chobyeongjun/AR_Walker/STM_Board/Assets/README.md

# Assets

이미지·다이어그램·스크린샷 저장 폴더.

## 권장

- **Excalidraw** 플러그인 사용 시: `.excalidraw.md` 파일로 저장
- PCB 스크린샷, 블록 다이어그램, 핀맵 이미지 등
- 파일명은 kebab-case 권장 (`block-diagram.png`)

## 연결

- [[Exosuit Board MOC]]
- [[Block Diagram]]
