chobyeongjun/AR_Walker/STM_Board/90 Templates/Schematic Block.md

---
aliases: []
tags: [type/block, phase/A]
type: schematic_block
phase: A
status: pending
kicad_sheet: ""
---

# {{title}}

## 목적

<!-- 이 블록이 하는 일 -->

## 핵심 부품

- [[]]

## 핀맵 (MCU 측)

| 신호 | MCU 핀 | 주변기기 | 비고 |
|---|---|---|---|

## 외부 회로

<!-- 디커플링, 풀업, 안티앨리어싱, 보호회로 등 -->

## 관련 개념

- [[]]

## 데이터시트 / 레퍼런스

- [ ]

## 작업 체크리스트

- [ ] reference schematic 수집
- [ ] KiCad 심볼 확인
- [ ] 풋프린트 확인
- [ ] sheet 그리기
- [ ] ERC 통과
- [ ] peer review

## 핀 충돌 검사

<!-- CubeMX .ioc 와 대조 -->
