chobyeongjun/AR_Walker/STM_Board/10 Project/Project MOC.md

---
aliases: [Project]
tags: [moc, project]
---

# Project MOC

Exosuit STM32 Board 프로젝트 전체 네비게이션.

## 계획·상태

- [[Goals & Requirements]] — 무엇을 만드는가, 비기능 요구사항
- [[Block Diagram]] — 시스템 블록 구성도
- [[Phase Plan]] — P0~P8 단계별 일정
- [[Size Budget]] — 보드 면적 예산
- [[Modular Strategy]] — Phase A / B 분리 전략

## 추적·투명성

- [[Decisions Log]] — 시간순 결정 기록
- [[Open Questions]] — 보류·미결 항목
- **[[Citations & Sources]]** ⭐ — 각 스펙·주장의 출처 추적 (투명성)

## Legacy (2026-04-12~14 이전 세션)

- [[_legacy/BOARD_PLAN]]
- [[_legacy/BOARD_DESIGN]]
- [[_legacy/BOARD_DESIGN_REVIEWED]]
- [[_legacy/EXOSUIT_PROTECTION]]
- [[_legacy/HANDOFF]]
- [[_legacy/RECONCILIATION]] — legacy 와 내 노트 diff

## 관련 MOC

- [[Components MOC]]
- [[Concepts MOC]]
- [[Schematic Blocks MOC]]
- [[BOM MOC]]
- [[Reference Index]]
