chobyeongjun/AR_Walker/STM_Board/90 Templates/Concept.md

---
aliases: []
tags: [type/concept, domain/]
type: concept
---

# {{title}}

> 이 템플릿은 `~/research-vault/templates/` 에도 복사해두는 것 권장.

## 문제 (Why)

<!-- 이 개념이 왜 필요한가? -->

## 해법 (How)

<!-- 어떻게 해결하는가? -->

## 우리 보드에서의 적용

<!-- 구체적 구현 -->

## 관련 부품

- [[]]

## 관련 결정

- [[]]

## 참고 자료
