chobyeongjun/AR_Walker/STM_Board/90 Templates/Decision.md

---
aliases: []
tags: [type/decision, status/decided]
type: decision
date: 
status: decided
domain: 
---

# Decision: {{title}}

> 이 템플릿은 `~/research-vault/templates/` 에도 복사해두는 것 권장.

## 결정

<!-- 한 줄로 -->

## 맥락

<!-- 언제, 왜 이 결정이 필요했는가 -->

## 고려한 옵션

- A: ...
- B: ...
- C: ...

## 근거

<!-- 왜 이 옵션을 골랐는가 -->

## 영향

- [[]]
- [[]]

## 재고 트리거

<!-- 언제 이 결정을 다시 볼 것인가 -->
