chobyeongjun/AR_Walker/STM_Board/10 Project/_legacy/BOARD_DESIGN_REVIEWED.md

# 보드 설계 검토 결과 — 수정본

> 4개 전문 에이전트 병렬 검토 결과 반영 (전원부 / STM32H743 / 아날로그 / CAN)

---

## CRITICAL 이슈 목록 (설계 전 반드시 수정)

| # | 영역 | 문제 | 결과 | 수정 |
|---|---|---|---|---|
| C1 | 전원 | AP62200WU VIN 최대 24V → 배터리 완충 25.2V 초과 | 동작 범위 이탈, 신뢰성 불가 | **AP63205WU-7** (4.2~32V) 또는 TPS54331으로 교체 |
| C2 | 전원 | SMBJ26A 클램프 전압 42.1V > AP63205 절대최대정격 | TVS가 있어도 IC 보호 안 됨 | 벅 컨버터 교체 후 TVS 재설계 |
| C3 | 전원 | P-MOS 역전압 보호 VGS = -22.9V → 절대최대정격 ±20V 초과 | P-MOS 파손 | GATE-GND 간 **12V 제너(BZT52C12) + R 100kΩ** 추가 |
| C4 | MCU | VCAP_2 핀(Pin 57) 누락 → LQFP100에는 VCAP 핀 2개 | 내부 1.2V LDO 불안정 → MCU 미동작 | VCAP_1(Pin33), VCAP_2(Pin57) 각각 **2.2μF** 독립 배치 |
| C5 | MCU | VREF+ 핀(Pin 21) 미처리 | 내장 ADC 전면 동작 불가 | VREF+ → VDDA 직결 + 100nF + 1μF |
| C6 | 아날로그 | ADS1234 AVDD 최소 4.75V → 현재 3.3V 계획 | ADC 미동작 | AVDD에 **5V 공급** 필수 |
| C7 | 아날로그 | INA333(3.3V 단전원) + 5V 여기 로드셀 → VCM=2.5V, 허용 최대 2.1V | 계측앰프 새추레이션, 측정 불가 | 여기 전압 3.0V 이하로 낮추거나 **INA128/AD8221**로 교체 |

---

## WARNING 이슈 목록 (설계 완료 전 반영)

| # | 영역 | 문제 | 권고 |
|---|---|---|---|
| W1 | 전원 | AMS1117-3.3 SOT-223 탭 미납땜 시 Tj=120°C(한계 125°C) | SOT-223 탭을 GND 동박(≥1cm²)에 납땜, 또는 벅으로 대체 |
| W2 | MCU | VDDA 필터 불충분 (1μF+100nF만) | 3.3V → **600Ω@100MHz 페라이트 비드** → VDDA, VDDA 쪽 10μF+1μF+100nF |
| W3 | MCU | PC13 RTC 도메인 핀 최대 전류 3mA | 직렬 100Ω 추가, 직접 부하 구동 금지, 필요 시 다른 GPIO로 이전 |
| W4 | MCU | 크리스탈 RS 저항 누락 | OSC_IN과 크리스탈 사이 **22Ω** 직렬 저항 추가 |
| W5 | MCU | USB Type-C CC1/CC2 핀 미처리 | CC1, CC2 각각 **5.1kΩ → GND**, D+/D-에 ESD TVS(PRTR5V0U2X) 추가 |
| W6 | MCU | BOOT0 처리 미명시 | **10kΩ 풀다운** + 점퍼/버튼으로 VDD 선택 가능하게 |
| W7 | MCU | NRST 값 미명시 | **100nF** (GND 사이), 저항 불필요 |
| W8 | 아날로그 | AINxN 처리 미명시 (단방향 측정) | AINxN에 VDD/2=1.65V 미드레일 인가, INA333 VREF도 동일 전압 |
| W9 | 아날로그 | 입력 과전압 보호 없음 | 각 입력 핀에 **직렬 10kΩ + BAV99 클램프 다이오드** |
| W10 | 아날로그 | 안티앨리어싱 필터 없음 | AINxP/N 직전 **1kΩ + 150nF** RC 필터 (fc≈1kHz) |
| W11 | CAN | TJA1051 STBY 핀 floating 위험 | **STBY → GND 직결** 또는 10kΩ 풀다운 |
| W12 | CAN | 차동 임피던스 재계산 필요 | 0.2mm 폭은 JLCPCB 스택업에서 약 88Ω → **0.17~0.18mm로 조정** |
| W13 | CAN | 토폴로지 미확정 | **데이지체인 확정**, 스타 구성 1Mbps에서 반사 위험 |
| W14 | CAN | GND 플레인 물리 분리 계획 문제 | **단일 연속 GND 플레인 유지** + 구역 파티셔닝 (Henry Ott 방식) |
| W15 | CAN | EMI → 로드셀 간섭 대책 없음 | CAN 양옆 GND 가드 트레이스, CMC(ACM2012-900) 검토 |

---

## 수정된 BOM

### 전원부 (변경)

| 부품 | 파트넘버 (수정 전) | 파트넘버 (수정 후) | 이유 |
|---|---|---|---|
| 벅 컨버터 | AP62200WU | **AP63205WU-7** | VIN 최대 32V, 5A |
| 역전압 P-MOS | 미정 | **DMP2305U-7** (SOT-23) | VGS ±20V, VDSS -30V |
| 역전압 제너 | 없음 | **BZT52C12** (SOD-123) | 12V, GATE-GND 클램핑 |
| TVS | SMBJ26A | **TVS 재설계** (AP63205 VIN 32V 기준) | 입력 내성 상향 후 재선정 |

### 아날로그부 (변경)

| 부품 | 파트넘버 (수정 전) | 파트넘버 (수정 후) | 이유 |
|---|---|---|---|
| 계측앰프 | INA333AIDGK | **INA128UA** (SOIC-8) 또는 **AD8221ARZ** | 5V 여기 로드셀 CMR 문제 해결 |
| 로드셀 여기 | 5V | **3.0V** (LDO 추가) | INA333 유지 시 CMR 허용 |

> **판단**: INA128(VDD 최대 ±18V = 36V, CMR 범위 -4V ~ Vcc-1.25V)은 5V 단전원에서 5V 여기 로드셀 사용 가능. AD8221도 동일. **INA128UA로 교체 권장.**

### 추가 부품

| 부품 | 파트넘버 | 용도 |
|---|---|---|
| 제너 다이오드 | BZT52C12 (SOD-123) | P-MOS GATE 보호 |
| 페라이트 비드 | BLM18PG601SN1D (0603) | VDDA 디지털-아날로그 분리 |
| 클램프 다이오드 | BAV99 (SOT-23) | 로드셀 입력 과전압 보호 |
| USB ESD | PRTR5V0U2X (SOT-363) | USB D+/D- 보호 |
| CAN CMC | ACM2012-900-2P-T002 | CAN 커먼모드 노이즈 (선택) |
| CC 저항 | 5.1kΩ 0402 ×2 | USB Type-C CC1/CC2 |
| BOOT 저항 | 10kΩ 0402 | BOOT0 풀다운 |
| NRST 캐패시터 | 100nF 0402 | NRST 필터 |
| Crystal RS | 22Ω 0402 | HSE 고조파 방지 |

---

## 수정된 회로 설계 핵심 사항

### 전원부 수정 회로

```
배터리(+) ─── [R1: 100kΩ] ─── GATE ─── [BZT52C12: 12V] ─── GND
                               │
배터리(+) ─── DRAIN(DMP2305U) ─── SOURCE ─── AP63205WU-7 VIN
                                              (4.2V~32V OK)
                                                 │
                                              5V 출력
                                                 │
                                    ┌────────────┤
                                    │            │
                               [AMS1117-3.3]  [ADP3338-3.3]
                               (디지털 3.3V)  (아날로그 3.3V)
                                    │
                               SOT-223 탭 → GND 동박 ≥1cm²
```

### STM32H743 전원 필터 수정

```
3.3V ─── [BLM18PG601: 600Ω@100MHz] ─── VDDA (Pin 11)
                                          ├── 10μF (X5R)
                                          ├── 1μF
                                          └── 100nF

3.3V ─────────────── VREF+ (Pin 21)
                      ├── 1μF
                      └── 100nF

GND ─── VCAP_1 (Pin 33) ─── 2.2μF (X5R, 6.3V)
GND ─── VCAP_2 (Pin 57) ─── 2.2μF (X5R, 6.3V)   ← 기존 누락!
```

### 로드셀 신호 체인 수정

```
로드셀 (5V 여기)
    │
  [R: 10kΩ] ─── IN+ ─── INA128UA ─── OUT ─── [R:1kΩ] ─── AINxP
  [BAV99]        │      (VDD=5V)               [C:150nF]
                IN- ─── VREF=1.65V             [C to GND]
                        │                          │
                [BAV99] │               AINxN ─── 1.65V (VDD/2)
                        │
                GAIN 설정: RG = 100kΩ/(G-1)
                G = 1650mV / (로드셀_full_scale_mV)
                예) 5V × 2mV/V = 10mV → G = 165 → RG = 613Ω
```

> **주의**: INA128은 5V 단전원에서 VDD/2 = 2.5V 공통모드 입력 지원. 허용 VCM = -4V ~ Vcc-1.25V = 3.75V → 2.5V OK.

### ADS1234 전원 수정

```
시스템 5V ─── AVDD (Pin) ─── 10μF + 100nF (기존 AGND 레일에서 공급)
3.3V      ─── DVDD (Pin) ─── 100nF
AVDD > DVDD 순서 또는 동시 인가 (역순 래치업 주의)
```

### CAN STBY 핀 수정

```
TJA1051 STBY ─── GND (직결)  ← 항상 Normal mode
             또는
TJA1051 STBY ─── [10kΩ] ─── GND (풀다운 + GPIO 제어 가능)
```

---

## PCB 레이아웃 수정 사항

### GND 플레인 처리 (수정)

```
[잘못된 기존 계획]
Layer 2: AGND 플레인 / DGND 플레인 물리적 분리(슬릿)

[수정된 방법 - Henry Ott]
Layer 2: 단일 연속 GND 플레인 (자르지 않음)
보드 구역 파티셔닝:
  ┌──────────────┬──────────────┐
  │   아날로그   │   디지털     │
  │ 로드셀/ADC   │ MCU/CAN/전원 │
  │ (좌측 하단) │ (우측 전체)  │
  └──────────────┴──────────────┘
규칙: 디지털 트레이스가 아날로그 구역 위(Layer 1) 통과 금지
      ADS1234 AGND/DGND 핀만 단일 스타포인트 연결
```

### 크리스탈 레이아웃 추가 규칙

```
OSC_IN ─── [22Ω] ─── 크리스탈 핀1
OSC_OUT ──────────── 크리스탈 핀2
크리스탈 아래 Layer 2 GND 비아 없음 (가드링만)
부하 캐패시터 GND 비아: 크리스탈 바로 옆 2mm 이내
```

---

## 확인된 OK 항목

- TJA1051T/3J 3.3V 로직 호환: VCCIO=3.3V 인가 시 OK
- CAN-FD Classic CAN 하위 호환: FDCAN_FRAME_CLASSIC 설정으로 OK
- FDCAN1/2 핀 할당 (PD0/1, PB12/13): STM32H743 AF 매핑 OK
- INA219 배터리 모니터 버스 전압: 25.2V < 26V 측정 한계 OK
- ADP3338 아날로그 LDO: 노이즈 40μVrms, 열 여유 OK
- ADS1234 데이터 레이트: PDIV=00으로 채널당 1kHz OK
- REF3325 출력 전류: 10mA >> ADC 요구 전류 OK
- SWD 핀 (PA13/PA14): 표준 SWD OK
- STM32H743 SMPS: H743에는 없음 → 외부 SMPS 부품 불필요 (단순화)
- JST-GH 4핀 CAN 커넥터: 전류/전압 정격 OK

---

## 수정 후 단계별 진행 체크리스트

### 스키매틱 작성 전 확인
- [ ] AP63205WU-7 데이터시트 입수 (LCSC C2688410)
- [ ] INA128UA 데이터시트 입수
- [ ] ADS1234 AVDD=5V, DVDD=3.3V 전원 분리 회로 설계
- [ ] P-MOS 역전압 보호 제너 포함 회로 확정

### 스키매틱 ERC 전 확인
- [ ] VCAP_1 (Pin 33) → 2.2μF 연결
- [ ] VCAP_2 (Pin 57) → 2.2μF 연결 (별도)
- [ ] VREF+ (Pin 21) → VDDA + 100nF + 1μF
- [ ] VDDA → 페라이트 비드 → 3.3V
- [ ] BOOT0 → 10kΩ 풀다운
- [ ] NRST → 100nF → GND
- [ ] OSC_IN → 22Ω → 크리스탈
- [ ] USB CC1, CC2 → 5.1kΩ → GND 각각
- [ ] TJA1051 STBY → GND
- [ ] TJA1051 VCCIO → 3.3V

### PCB 레이아웃 전 확인
- [ ] GND 플레인 단일 유지 (분리 금지)
- [ ] 아날로그/디지털 구역 배치 계획 확정
- [ ] AMS1117 SOT-223 탭 GND 동박 ≥1cm²
- [ ] CAN 차동쌍 폭 0.17~0.18mm
- [ ] JLCPCB 임피던스 제어 옵션 사용

---

## skiro 기록 대상 (설계 중 반드시 추적)

각 CRITICAL 수정 완료 시 `skiro_record_solution` 실행
문제 재발 시 `skiro_record_problem` 즉시 기록
하드웨어 테스트 전 `skiro_safety_gate_create` 실행 (CRITICAL 0개 조건)
