chobyeongjun/AR_Walker/STM_Board/10 Project/_legacy/EXOSUIT_PROTECTION.md

# Exosuit 보드 보호 회로 설계 — 최종 확정본

> **배경**: 케이블 드리븐 외골격의 반복적 pull-release → 수십 A 전류 급변 → 보드 반복 파손
> 4개 전문 에이전트 병렬 분석 + 교차검증으로 수치 근거 확정

---

## 왜 보드가 타는가 — 수치 분석

### 메커니즘 1: 재생 에너지 전압 폭주 (가장 위험)

```
케이블 릴리즈 순간:
  케이블 탄성에너지 = F×x/2 = 100N × 5mm / 2 = 0.25J/모터
  4개 동시 릴리즈: E_total = 1J

  배터리 BMS가 역전류 거부할 때 에너지 행선지:
  → 버스 캐패시터 충전

  C_bus = 100μF (보호 없을 때):
  V_peak = √(2×1J / 100μF + 24²) = √(20,000 + 576) = 143V  ← 즉사

  C_bus = 10,000μF (보호 후):
  V_peak = √(2×1J / 10,000μF + 24²) = √(200 + 576) = 27.9V ← 안전
```

### 메커니즘 2: Ground Bounce → CAN 트랜시버 TXD/RXD 파손

```
모터 리턴 전류 급변 + PCB 그라운드 인덕턴스:
  V_bounce = L × dI/dt = 50nH × 50A/μs = 2.5V

TJA1051 TXD/RXD 핀 (VIO 기준):
  절대최대정격: VIO ± 0.3V
  2.5V bounce → 즉시 초과 → 트랜시버 파손

  이것이 CAN 트랜시버가 주기적으로 죽는 원인
```

### 메커니즘 3: L·dI/dt 버스 스파이크

```
케이블 + PCB 배선 인덕턴스 총계 ≈ 700nH ~ 2μH
극단 케이스: V = 2μH × 2A/μs = 4V → 버스 최대 29.2V
→ 재생 에너지보다 작지만 고주파 반복 → 소자 열화 가속
```

---

## 확정 보호 아키텍처

### 블록 다이어그램

```
배터리 24V LiPo (완충 25.2V)
         │
    ┌────┴─────────────────────────────────────────────────┐
    │  [DMP2305U P-MOS + BZT52C12 12V 제너] 역전압 보호    │
    └────────────────────────┬─────────────────────────────┘
                             │
    ┌────────────────────────┴─────────────────────────────┐
    │  [SL08-2R005 NTC × 2 직렬 = 4Ω] 인러시 제한         │
    │  [Omron G5V-1 릴레이 bypass — 정상동작 후 단락]      │
    └────────────────────────┬─────────────────────────────┘
                             │
         24V_MOTOR 버스 ─────┤
                             │
         ┌───────────────────┤───────────────────┐
         │                   │                   │
  [BUS_BULK ×2]    [BUS_TVS P6KE33CA×2]  [제동저항 회로]
  9,400μF/35V       클램프 37.8V          TLV3201(비교기)
  버스 에너지 흡수   최후 클램프           26.5V 임계 → IPB025N10N3
                                         → 3Ω/50W 저항 → GND

    ┌─────────────┬─────────────┬─────────────┬───────────┐
  모터1          모터2          모터3          모터4
[SMAJ28CA]    [SMAJ28CA]    [SMAJ28CA]    [SMAJ28CA]  로컬 TVS
[470μF/35V]   [470μF/35V]   [470μF/35V]   [470μF/35V] 로컬 캐패시터
[BLM31AG]     [BLM31AG]     [BLM31AG]     [BLM31AG]   페라이트비드
[커넥터]       [커넥터]       [커넥터]       [커넥터]

         │
         └─────────────────── 24V_LOGIC 분기 (5A 퓨즈)
                              [10μH + 100μF 필터]
                              [AP63205WU-7 → 5V]
                              [TPS7A4700 LDO → 3.3V]

PGND ──[BLM21PG601SN1 단 1개]── AGND (스타 그라운드)

CAN 신호 경로 (FDCAN1, FDCAN2 동일):

STM32 FDCAN TX/RX
     │
 [33Ω] + [PRTR5V0U2X ESD ±8kV]
     │
 ISO1050DUBR (격리 5000Vrms)
 VCC1 = 3.3V (AGND)
 VCC2 = 5V (PGND, MGJ2D 격리출력 + BZT52C5V6 5.6V 제너)
     │
 [22Ω 댐핑]
     │
 [ACM2012-900 CMC 900Ω@100MHz]
     │
 [SM712-02HTG TVS 500W]
     │
 CAN 커넥터 → AK 모터 (데이지체인, 120Ω 종단)
```

---

## 확정 BOM — 보호 소자 전용

| 위치 | 부품 | 파트넘버 | 수량 | 선택 근거 |
|---|---|---|---|---|
| 버스 벌크 캐패시터 | 4700μF/35V 전해 | Rubycon 35ZLH4700M | 2 | 1J 재생에너지 흡수, V_peak=27.9V |
| 모터 로컬 캐패시터 | 470μF/35V OS-CON | Panasonic SVPD471M35 | 4 | 각 모터 로컬 에너지 흡수 |
| 버스 주 TVS | P6KE33CA 600W | Vishay P6KE33CA | 2병렬 | 37.8V 클램프, AK 내압 40V 대비 여유 |
| 모터 로컬 TVS | SMAJ28CA 400W | Vishay SMAJ28CA | 4 | 모터별 독립 보호, SOD-123 소형 |
| 제동 저항 | 3Ω/50W | Arcol HS50 3R0 J | 1 | 25W 평균 소산, 사이클 20% 듀티 |
| 제동 MOSFET | 100V/130A | Infineon IPB025N10N3 G | 1 | 재생 전류 소산 스위치 |
| 제동 비교기 | 단전원 비교기 | TI TLV3201DCKR | 1 | 26.5V 임계 감지 |
| 제동 임계 저항 상단 | 100kΩ 0.1% | - | 1 | 26.5V 분압 설정 |
| 제동 임계 저항 하단 | 10kΩ 0.1% | - | 1 | 26.5V 분압 설정 |
| 인러시 NTC | 2Ω NTC | Ametherm SL08-2R005 | 2직렬 | 4Ω 합산, 인러시 <6A, τ=40ms |
| 인러시 bypass 릴레이 | 5V DC 릴레이 | Omron G5V-1-DC5 | 1 | 정상동작 후 NTC 단락 |
| 역전압 P-MOS | -30V/4A SOT-23 | Diodes DMP2305U-7 | 1 | 역접속 완전 차단 |
| GATE 클램프 제너 | 12V SOD-123 | BZT52C12 | 1 | VGS ≤ 12V (절대최대 20V 보호) |
| CAN TVS | 500W 통합 | SM712-02HTG | 2 | CAN_H/L 동시, 4× PESD1CAN 에너지 |
| CAN 커먼모드 초크 | 900Ω@100MHz | TDK ACM2012-900-2P-T002 | 2 | EMI 차단, TVS 코어 포화 방지 |
| CAN 격리 트랜시버 | 5000Vrms | TI ISO1050DUBR | 2 | GND bounce 경로 물리 차단 |
| 격리 DC/DC | 5V→5V 2W | Murata MGJ2D05050SC | 2 | VCC2 독립 공급 |
| VCC2 보호 제너 | 5.6V SOD-123 | BZT52C5V6 | 2 | VCC2 최대 6.5V 보호 |
| FDCAN 핀 ESD | ±8kV SOT-363 | Nexperia PRTR5V0U2X | 2 | TX/RX 핀 직접 보호 |
| FDCAN 댐핑 저항 | 33Ω 0402 | - | 4 | 반사 억제, ESD 전류 제한 |
| CAN 댐핑 저항 | 22Ω 0402 | - | 4 | 버스 라인 댐핑 |
| PGND-AGND 비드 | 600Ω@100MHz | Murata BLM21PG601SN1D | 1 | 스타 그라운드 단 1개 연결점 |
| 모터 전원 페라이트 | 600Ω@100MHz 3A | Murata BLM31AG601SN1L | 4 | 모터별 고주파 노이즈 차단 |
| 5V 라인 TVS | 400W SOD-123 | Vishay SMAJ5.0A | 1 | AP63205 출력 보호 |

---

## 교차검증에서 수정된 핵심 사항

| 항목 | 1차 설계 | 교차검증 후 수정 | 근거 |
|---|---|---|---|
| 버스 캐패시터 | 4,400μF | **11,280μF** | 1J 흡수에 C_min=9,615μF 필요 |
| 제동 저항 임계 | 28V | **26.5V** | 배터리 완충 25.2V 대비 마진 확보 |
| TJA1051 VCC 보호 | SMAJ5.0A(클램프 9.2V) | **ISO1050 + BZT52C5V6(5.6V)** | VCC2 절대최대 6.5V < SMAJ5.0A 클램프 |
| 인러시 NTC | 단일 2Ω | **직렬 2개 4Ω + 릴레이** | 반복 동작 시 자기가열 → 저항 감소 방지 |
| CAN 트랜시버 | TJA1051 비격리 | **ISO1050 격리 5000Vrms** | GND bounce 2.5V → TXD/RXD 파손 원인 |

---

## PCB 레이아웃 규칙 (보호 관점)

### 1. 고전류 루프 면적 최소화 (인덕턴스 감소)

```
[잘못된 배치] 배터리 커넥터 → 트레이스 100mm → 캐패시터 → 모터
→ 루프 면적 크면 L 증가 → V_spike 증가

[올바른 배치] 배터리 커넥터 옆 3mm 이내에 벌크 캐패시터 배치
→ BUS_BULK ↔ 배터리 커넥터 사이 트레이스 최단
→ 캐패시터 GND via는 패드 직결, 별도 트레이스 없이
```

### 2. 모터 전원 리턴 경로 전용화

```
모터 커넥터 GND 핀
     ↓ (via 4개 이상)
Layer 2 PGND 플레인
     ↓ (넓은 Pour)
배터리 GND 커넥터
→ 이 경로에 MCU, 센서 GND 비아 없음
```

### 3. 격리 경계선 (ISO1050)

```
PCB Layer 1~4 모두:
  MCU 영역 (AGND) │ 솔더마스크 갭 2mm │ CAN 버스 영역 (PGND)
ISO1050 패키지가 이 경계를 가로지름
ISO1050 아래 Layer 2: AGND와 PGND 사이 갭 (via 없음)
```

### 4. 제동 저항 배치

```
IPB025N10N3 → PCB 모서리 or 외부 방열판 연결
저항 HS50 3Ω → PCB 외부 별도 방열판 (50W 소산)
MOSFET 방열: TO-263 패드 → 2oz 동박 방열 패드 최소 4cm²
```

### 5. CAN 보호 소자 배치 순서

```
커넥터 핀에서 거리:
3mm: SM712-02HTG TVS
8mm: ACM2012-900 CMC
13mm: 22Ω 댐핑 저항
18mm: ISO1050 버스측 핀
→ 격리 장벽 →
23mm: PRTR5V0U2X ESD
28mm: 33Ω MCU 측 저항
35mm: STM32H743 FDCAN 핀
```

---

## 실패 모드 보호 검증

| 실패 모드 | 보호 소자 | V 또는 E | 보호 충분? |
|---|---|---|---|
| 4모터 동시 회생 1J | 11,280μF + 제동저항 26.5V | V_peak=27.9V < 28V | ✅ 충분 |
| 버스 스파이크 (빠른 상승) | P6KE33CA×2 (1,200W) | 37.8V 클램프 | ✅ AK 내압 40V 이내 |
| 모터 로컬 서지 | SMAJ28CA + 470μF | 각 모터 독립 | ✅ 전파 차단 |
| CAN ESD ±8kV | SM712-02HTG + PRTR5V0U2X | ±8kV HBM | ✅ |
| GND bounce → MCU 파손 | ISO1050 5000Vrms 격리 | 물리적 경로 차단 | ✅ 근본 해결 |
| 24V 스파이크 → VCC2 | BZT52C5V6 5.6V 클램프 | 5.6V < VCC2_max 6.5V | ✅ |
| 역전압 접속 | DMP2305U + BZT52C12 | VGS ≤ 12V | ✅ |
| 인러시 전류 | NTC 4Ω 직렬 | 피크 6A, 2.88J/NTC | ✅ < 5J 정격 |
| CAN 커먼모드 노이즈 | ACM2012-900 CMC | -40dB@100MHz | ✅ |

---

## skiro 체크포인트

```
모터 연결 전: skiro_safety_gate_create (CRITICAL 0개 확인)
제동저항 초기 테스트: 먼저 28V 공급 → 비교기 출력 확인 → 저항 연결
ISO1050 통신 확인: 루프백 → 실제 모터 CAN 통신
벌크 캐패시터 충전 확인: NTC 자기가열 후 릴레이 동작 확인
```
