chobyeongjun/AR_Walker/Walker_Main/Python_GUI/Resources/Images/H-Walker_Blue.png

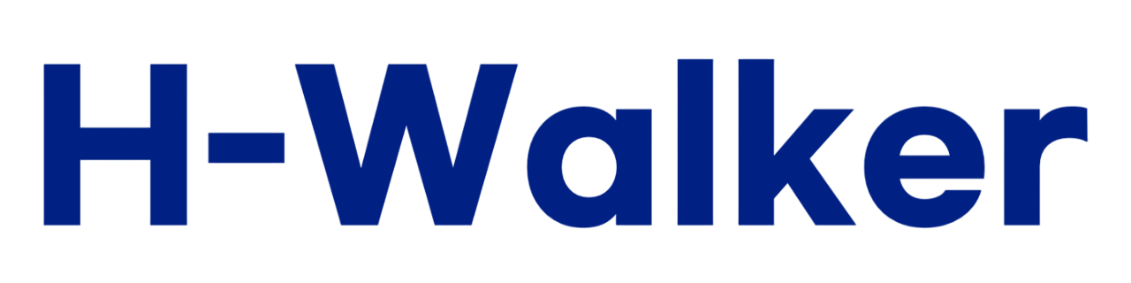
Walker_Main/Python_GUI/Resources/Images/H-Walker_Blue.png
