chobyeongjun/AR_Walker/Walker_Main/Python_GUI/Resources/Images/H-Walker_Sky.png

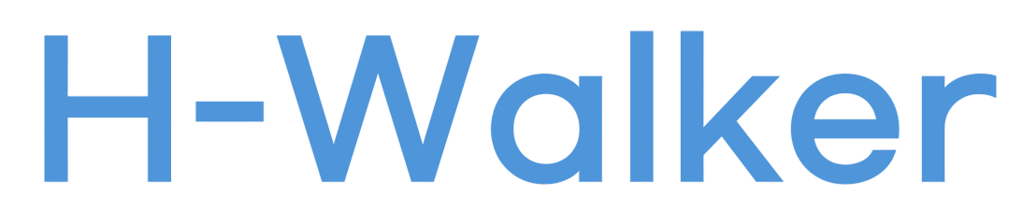
Walker_Main/Python_GUI/Resources/Images/H-Walker_Sky.png
