chobyeongjun/AR_Walker/STM_Board/20 Components/INA228.md

---
aliases: [INA228, 배터리 모니터]
tags: [type/component, domain/power, domain/sensor, phase/A, status/decided]
type: component
part_number: INA228IDGSR
package: VSSOP-10
manufacturer: TI
voltage_range: 0-85V common-mode
interface: I²C
phase: A
status: decided
qty: 2
---

# INA228

## 한 줄 요약

0~85V 전류·전압·전력·**쿨롱 카운터** 통합 모니터 — 배터리 SoC 추정. **2개 사용** (24V × 2 직렬 배터리 개별 측정).

## 사양

- 전압 범위: 0~85V (common-mode) — 24V 단일 / 48V 직렬 둘 다 OK
- ADC: 20-bit
- BUS 정밀도: 1.5 mV
- CURRENT 분해능: shunt 1mΩ + gain → 4µA LSB 가능
- 인터페이스: I²C (400kHz / 2.94 MHz)
- **CHARGE 레지스터** — 내장 쿨롱 카운터 (mAh 적분)

## ⚠️ Legacy: 2개 사용 (직렬 배터리)

Legacy HANDOFF 명시: **INA228 × 2**.

이유: 24V × 2 직렬 = 48V 시스템 시, **각 배터리 팩 개별 전압/전류 측정** 필요.
- 팩 1 불균형 감지
- 팩 간 electrical breakaway 감지
- 개별 SoC 계산 후 합산

I²C 주소 서로 다르게 (ADDR0/ADDR1 핀 결선) 설정.

### 24V 단일 시스템이면?

INA228 × 1 로도 OK. 단 legacy 가 2개 명시했으므로 **2개 풋프린트 배치 → 미사용 시 DNP** 추천.

## 왜 선택했나

- **전 전압 범위 커버** — 12V 든 48V 든 동일 IC
- vs INA226 (36V max) — 48V 불가
- vs 풀 BMS (BQ40Z80) — 과잉
- 내장 쿨롱 카운팅으로 MCU 부담 ↓

## 연결되는 블록

- [[Battery Monitor]]

## 관련 개념

- [[Battery SoC Estimation]]

## 외부 회로

- Shunt 저항 1 mΩ 2W 2512 (Susumu CSS2H) — 입력 +V 라인 직렬
- I²C 풀업 4.7kΩ × 2 ([[MCU Core]] I²C1 버스 공유)
- 3.3V 바이패스 (100nF + 1µF)

## I²C 주소

| 칩 | ADDR0 | ADDR1 | 주소 |
|---|---|---|---|
| INA228 #1 (팩 1) | GND | GND | 0x40 |
| INA228 #2 (팩 2) | VS | GND | 0x41 |

## 데이터시트

- [ ] TI INA228 데이터시트 PDF
