chobyeongjun/AR_Walker/STM_Board/20 Components/BZT52C12.md

---
aliases: [BZT52C12, 12V 제너]
tags: [type/component, domain/power, domain/safety, phase/B, status/decided]
type: component
part_number: BZT52C12
package: SOD-123 (SMD)
manufacturer: various (commodity)
voltage_range: 12V Zener
interface: Zener diode
phase: B
status: decided
---

# BZT52C12

## 한 줄 요약

12V 제너 다이오드 SOD-123 — [[DMP2305U]] P-MOS GATE 클램프. VGS 절대최대 ±20V 이내로 제한.

## 왜 12V

- V_GS(on) 임계: -2V 정도부터 도통 (DMP2305U R_DS 곡선)
- V_GS = -12V 에서 R_DS ~ 100mΩ (양호)
- 절대최대 -20V 에 마진 8V

## 관련

- [[DMP2305U]]
- [[Motor Power]]
