chobyeongjun/AR_Walker/STM_Board/20 Components/SL08-2R005.md

---
aliases: [SL08-2R005, 인러시 NTC]
tags: [type/component, domain/power, phase/B, status/decided]
type: component
part_number: SL08-2R005
package: through-hole
manufacturer: Ametherm
voltage_range: -
interface: thermistor (NTC)
phase: B
status: decided
---

# SL08-2R005

## 한 줄 요약

2Ω NTC 인러시 제한. 2개 직렬 (4Ω) 로 반복 동작 지원.

## 사양

- 저항 (25°C): 2Ω
- 최대 연속 전류: 5A
- 에너지 정격: 5J (단발)
- 패키지: through-hole

## 사용 방식

[[Inrush Current Limiting]] 참조.

2개 직렬로 4Ω → I_inrush = 24V/4Ω = 6A. τ = 45ms.
100ms 후 Omron G5V-1 릴레이 bypass → NTC 발열 없음.

## 관련

- [[Inrush Current Limiting]]
- [[Motor Power]]
