chobyeongjun/AR_Walker/STM_Board/90 Templates/Component.md

---
aliases: []
tags: [type/component, domain/, status/decided]
type: component
part_number: ""
package: ""
manufacturer: ""
voltage_range: ""
interface: ""
phase: A
status: decided
---

# {{title}}

> 이 템플릿은 `~/research-vault/templates/` 에도 복사해두는 것 권장 (vault 공용).

## 한 줄 요약

<!-- 이 부품이 어떤 역할을 하는지 한 문장 -->

## 사양

| 항목 | 값 |
|---|---|
| 제조사 |  |
| 패키지 |  |
| 공급 전압 |  |
| 인터페이스 |  |
| 핀 수 |  |
| 가격대 |  |

## 왜 이 부품을 선택했나

<!-- 관련 Concept 또는 Decision 노트로 근거 연결 -->

## 연결되는 블록

- [[]]

## 관련 개념

- [[]]

## 데이터시트 / 레퍼런스

- [ ] 데이터시트 PDF 저장
- [ ] EVM / dev board schematic 수집

## 핀 / 주의사항
