chobyeongjun/AR_Walker/STM_Board/20 Components/74LVC1G08.md

---
aliases: [74LVC1G08, AND gate]
tags: [type/component, domain/safety, phase/A, status/decided]
type: component
part_number: 74LVC1G08GW
package: SC-70-5 또는 SOT-353
manufacturer: Nexperia
voltage_range: 1.65-5.5V
interface: logic
phase: A
status: decided
---

# 74LVC1G08

## 한 줄 요약

단일 2-입력 AND 게이트 — [[E-stop Dual Safety]] 의 HW 차단 요소.

## 역할

`motor_enable_final = (MCU motor_enable) AND (E-stop NC 접점 OK)`

MCU 가 행(freeze)해도 E-stop 입력이 끊기면 게이트 출력 LOW → 모터 드라이버 enable 신호 차단.

## 사양

- 단일 게이트, 2-입력 AND
- 전파 지연: ~3 ns
- 공급 전압: 3.3V (우리 로직 레벨)
- 패키지: SC-70-5 또는 SOT-353 (1.6 × 1.6mm)

## 외부 회로

- VCC 100nF 바이패스
- 미사용 입력 없음 (2-입력 전부 사용)

## 연결되는 블록

- [[Safety UI]]

## 관련 개념

- [[E-stop Dual Safety]]

## 데이터시트

- [ ] Nexperia 74LVC1G08 데이터시트 PDF
