chobyeongjun/AR_Walker/STM_Board/20 Components/AS5048A.md

---
aliases: [AS5048A, encoder]
tags: [type/component, domain/sensor, phase/A, status/decided]
type: component
part_number: AS5048A
package: TSSOP-14
manufacturer: ams
voltage_range: 3.3V or 5V
interface: SPI or PWM or ABI
phase: A
status: decided
---

# AS5048A

## 한 줄 요약

14-bit 자기식 절대 인코더 — 풀리에 다이아메트럴 자석 배치, 케이블 위치·모터 축 각도 측정.

## 사양

- 해상도: **14-bit** (16384 pos/rev)
- 인터페이스: SPI (1MHz) + PWM + ABI
- 전원: 3.3V 또는 5V
- 최대 회전 속도: 14.5k RPM
- 온도: -40~125°C

## 왜 선택했나

- 풀리 회전 절대각 직접 측정 (reboot 후 homing 불필요)
- 접촉식 아닌 자기식 → 수명 길고 신뢰성 ↑
- [[Elmo 드라이버]] 내부 인코더 피드백을 CANopen 으로 받는 방법도 있지만, 외부 엔코더로 이중 센싱 안전

## 외부 회로

- SPI 풀업 (MISO 10kΩ)
- 바이패스 캡 (VDD 100nF)
- 자석 위치: IC 위 1-2mm 거리, 다이아메트럴 자화

## 연결되는 블록

- [[Encoder]] — 인코더 sheet
- [[MCU Core]] SPI3 + 2× CS

## 데이터시트

- [ ] ams AS5048A 데이터시트 PDF
- [ ] Adafruit AS5048A breakout schematic (참고)
