chobyeongjun/AR_Walker/STM_Board/20 Components/REF5025.md

---
aliases: [REF5025, 정밀 레퍼런스]
tags: [type/component, domain/sensor, phase/A, status/decided]
type: component
part_number: REF5025AIDR
package: SO-8
manufacturer: TI
voltage_range: input 2.7-18V, output 2.5V
interface: analog
phase: A
status: decided
---

# REF5025

## 한 줄 요약

2.5V 정밀 전압 레퍼런스 — [[ADS131M04]] REFIN 용, force 측정 정확도 결정.

## 사양

- 출력: 2.500 V ± 0.05% (A 그레이드)
- 온도 드리프트: **3 ppm/°C**
- 노이즈: 7.5 µVpp (0.1~10Hz)
- 출력 전류: ±10 mA

## 왜 필요한가

ADS131M04 의 FSR (full-scale range) 은 ±VREF. VREF 가 불안정하면 모든 force 측정이 비례로 오차.
내장 레퍼런스 (2.442V 내부) 보다 외부 REF5025 가 10× 안정적.

## 외부 회로

```
3.3V_A ─[100nF + 10µF]─ VIN
                       │
                       └── OUT (2.5V) ─[4.7µF + 100nF]─► ADS131M04 REFIN
                           NR(5) ─[1µF]─ GND          (노이즈 필터)
```

## 관련

- [[ADS131M04]]
- [[Loadcell Amplifier Design]]
- [[Loadcell Amp]]

## 데이터시트

- [ ] TI REF5025 데이터시트 PDF
