chobyeongjun/AR_Walker/STM_Board/20 Components/TPD4S012.md

---
aliases: [TPD4S012, USB ESD]
tags: [type/component, domain/comm, domain/safety, phase/A, status/decided]
type: component
part_number: TPD4S012DBVR
package: SOT-23-6
manufacturer: TI
voltage_range: 3.3V~5V
interface: USB D+/D-
phase: A
status: decided
---

# TPD4S012

## 한 줄 요약

4채널 ±15 kV ESD 다이오드 어레이 — USB-C D+/D- + CC 라인 정전기 보호.

## 사양

- ESD: IEC 61000-4-2 ±15 kV (접촉·공중 방전)
- 커패시턴스: 0.8 pF (USB HS 480 Mbps 에 적합)
- 4 채널 (D+, D-, CC1, CC2)
- SOT-23-6 (2.9×1.6 mm)

## 왜 선택했나

- USB HS (480Mbps) 에 낮은 cap 필수 (≤1pF)
- 4 채널 — D+/D- + CC1/CC2 모두 보호
- vs USBLC6 (2채널) — CC 라인까지 커버 못함

## 외부 회로

- USB 커넥터 바로 뒤 배치 (근접성 중요)
- VBUS 는 별도 보호 (TVS)

## 연결되는 블록

- [[USB Debug]]

## 데이터시트

- [ ] TI TPD4S012 데이터시트 PDF
