chobyeongjun/AR_Walker/Walker_Main/Hardware/Bowden_Transmission/Bill_of_Materials_AK60V1_1.xlsx

Item | Link | Count | Price ($) | Total ($)
Machined Parts
Sprocket (x2) AND Cable - Chain Interface (x4) | https://www.hubs.com/ | 1 | 432.58 | 432.58
Prefabricated Parts
Chain Master Link | https://www.mcmaster.com/catalog/130/1314/6027K71 | 4 | 1.78 | 7.12
04B Chain (1ft) | https://www.mcmaster.com/catalog/130/1314/6027K71 | 1 | 9.02 | 9.02
TMotors AK60V1.1 KV80 | https://www.cubemars.com/goods-1142-AK60-6+V11+KV80.html | 2 | 298.9 | 597.8
6mm x 13mm x 5mm Flanged Ball Bearing (package of 10) | https://www.amazon.com/HiPicco-Flanged-Bearing-Shielded-Bearings/dp/B0CRLFPJPG?th=1 | 1 | 7.99 | 7.99
Steel Cable (500ft) | https://www.amazon.com/gp/product/B00TYSBDPU/ref=ppx_yo_dt_b_search_asin_title?ie=UTF8&psc=1 | 1 | 99 | 99
Cable Crimps (pack of 50) | https://www.mcmaster.com/catalog/130/1731/3914T11 | 1 | 9.04 | 9.04
Fasteners
M3X8 Buttonhead Screw (pack of 100) | https://www.mcmaster.com/products/screws/system-of-measurement~metric/rounded-head-screws~/metric-18-8-stainless-steel-button-head-hex-drive-screws/thread-siz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 | 1 | 8 | 8
M3X6 Buttonhead Screw (pack of 100) | https://www.mcmaster.com/products/screws/system-of-measurement~metric/rounded-head-screws~/metric-18-8-stainless-steel-button-head-hex-drive-screws/finish~pas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 | 1 | 5.83 | 5.83
M3X30 Flathead Screw (pack of 50) | https://www.mcmaster.com/products/screws/flat-head-screws~/metric-alloy-steel-hex-drive-flat-head-screws/thread-size~m3/length~30-mm/ | 1 | 6.93 | 6.93
M5X20 Buttonhead Screw (pack of 50) | https://www.mcmaster.com/products/screws/rounded-head-screws~/metric-18-8-stainless-steel-button-head-hex-drive-screws/thread-size~m5/length~20-mm/finish~pass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 | 1 | 12.38 | 12.38
M5 Lock Nuts (pack of 50) | https://www.mcmaster.com/products/nuts/locknuts~/nylon-insert-locknuts~~/system-of-measurement~metric/thread-size~m5/material~stainless-steel-2/ | 1 | 7.26 | 7.26
M3 Washer (pack of 10) | https://www.mcmaster.com/products/washers/washers-2~/metric-general-purpose-washers/screw-size~m3/material~aluminum-1/ | 1 | 10.4 | 10.4
M4X8 Buttonhead Screw (pack of 100) | https://www.mcmaster.com/products/screws/rounded-head-screws~/metric-18-8-stainless-steel-button-head-hex-drive-screws/thread-size~m4/length~8-mm/finish~passi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 | 1 | 10.09 | 10.09
Total: |  |  |  | 1223.44
Bowden Tube | https://www.amazon.com/Jagwire-Sport-Housing-Slick-Lube-Titanium/dp/B085NBZMJS?s=sporting-goods | 1 | 61.97
