chobyeongjun/AR_Walker/Walker_Main/Hardware/Hip_Device/Bill_of_Materials.xlsx

Part | Quantity | Price (9/18/23) | Total Price | Notes | Link
Motor
AK60v1.1 Motor | 2 | 298.90 | 597.80 |  | https://store.tmotor.com/goods-1201-AK60-6+V11.html
External Manufactured Parts
Abduciton/Adduction Block - Hip | 2 | 103.50 | 207.00 | Refer to documentation for ordering information and files | https://uptivemfg.com/
Abduciton/Adduction Block - Leg | 2 | 103.50 | 207.00 | Refer to documentation for ordering information and files | https://uptivemfg.com/
Printed Circuit Board | 1 | 59.92 | 0.00 | Refer to documentation for ordering information and necessary files; Initial order was for 5 boards so price is estimated as 1/5th that price | https://jlcpcb.com/
Carbon Fiber Parts - Internally Manufactured
Carbon Fiber - Upright | 1 | 173.99 | 173.99 | Recommended stock should have enough for multiple uprights of varying lengths (e.g., short and long versions of uprights) | https://www.rockwestcomposites.com/25502-group
Carbon Fiber Plate | 1 | 60.25 | 60.25 | Part Number: 8181K14; For: Motor Adaptors (Inner and Outer), Spacer, and Motor-to-Upright; Totals 8 Parts | https://www.mcmaster.com/8181K14/
3D Printed Parts - Internally Printed
Upright Bolt Support | 2 | 2.44 | 4.88 | Printed with Onyx using a Markforged Mark Two; Price is estimated based on material used from printer; See Solidworks files located within documentation | N/A
HoleTemplateForUpright | 1 | 1.60 | 1.60
Motor-to-Leg Shell | 2 | 1.81 | 3.62
Thigh Cuffs - Right | 1 | 77.80 | 77.80
Thigh Cuffs - Left | 1 | 80.61 | 80.61
Thigh Cuffs - Back | 2 | 8.91 | 17.82
Thigh Cuffs - Top Slider | 2 | 9.13 | 18.26
Thigh Cuffs - Bottom Slider | 2 | 9.47 | 18.94
FSR Puck Plate | 4 | 1.05 | 4.20
Backplate | 1 | 24.37 | 24.37
Battery Cover | 1 | 11.86 | 11.86
Electrical Box Cover - Shell | 1 | 22.32 | 22.32
Electrical Box Cover - Internal | 1 | 4.55 | 4.55
Strain Relief for PCB Wires (left) | 1 | 1.31 | 1.31
Strain Relief for PCB Wires (right) | 1 | 1.28 | 1.28
PCB Spacer | 1 | 1.05 | 1.05
Hardware - Mounting Plates to Belt
PVC/Acrylic Plate Mounting Plates | 2 | 18.77 | 37.54 | Part Number: 8650K21, Grey | https://www.mcmaster.com/8650K21-8650K214/
Aluminum Hex Nut - M5 x 0.8 mm | 16 | 0.13 | 2.07 | Part Number: 91854A102; Only comes in pack of 50, price is estimated on a per part basis | https://www.mcmaster.com/91854a102/
Button Head Hex Drive Screw - M5 x 0.8 mm; Length: 22 mm | 8 | 0.26 | 2.10 | Part Number: 91239A242, Only comes in pack of 50, price is estimated on a per part basis | https://www.mcmaster.com/91239A242/
Aluminum Washer - M5 Screw Size | 8 | 1.08 | 8.66 | Part Number: 92334A113; Only comes in pack of 10, price is estimated on a per part basis | https://www.mcmaster.com/92334A113/
Nylon 6/6 Plastic Cap Nut | 8 | 0.26 | 2.08 | Part Number: 90527A510; Only Comes in Pack of 100, price is estimated on a per part basis | https://www.mcmaster.com/90527A510/
Hardware - Electrical Box
Zinc-Plated Steel Button Head Torx - M3 x 0.5 mm; Length 14 mm | 4 | 0.19 | 0.74 | Part Number: 92832A566; Only comes in pack of 50, price estimated on a per part basis | https://www.mcmaster.com/92832A566/
Aluminum Waher - M3 Screw Size | 4 | 1.04 | 4.16 | Part Number: 92334A109, Only comes in pack of 10, price estimated on per part basis | https://www.mcmaster.com/92334A109/
Medium-Strength Steel Thin Hex Nut - M3 x 0.5 mm | 2 | 0.06 | 0.11 | Part Number: 90370A203, Only comes in pack of 100, price estimated on a per part basis | https://www.mcmaster.com/90370A203/
Alloy Steel Socket Head Screw - M3 x 0.5 mm; Length 10 mm | 7 | 0.10 | 0.67 | Part Number: 91290A115, Only comes in pack of 100, price estimated on a per part basis | https://www.mcmaster.com/91290A115/
Heat-Set Inserts for Plastic - M3 x 0.5 mm | 15 | 0.28 | 4.27 | Part Number: 94459A130, Only comes in pack of 50, price estimated on a per part basis | https://www.mcmaster.com/94459A130/
M2.5 x 0.5 Tap | 1 | 11.99 | 11.99 | Might be able to get away with not using this | https://www.amazon.com/Aceteel-Metric-Thread-Machine-M2-5x0-5mm/dp/B09SHPBP22
Button Head Hex Drive Screw - M2.5 x 10 mm | 2 | 0.39 | 0.77 | Part Number: 91239A757, Only comes in pack of 25, price estimated on a per part basis | https://www.mcmaster.com/91239A757/
Hardware - Motor to Belt
Stainless Steel Ball Bearing - 6mm Shaft Diameter | 4 | 8.74 | 34.96 | Part Number: 7804K143 | https://www.mcmaster.com/7804K143/
Metal Sealing Washer - M6 Screw Size | 4 | 0.35 | 1.41 | Part Number: 97725A102, Only comes in pack of 50, price is estimated on a per part basis | https://www.mcmaster.com/97725A102/
Stainless Steel Low-Profile Precision Shoulder Screw - 6 mm Diameter; Length: 25 mm | 2 | 10.89 | 21.78 | Part Number: 90323A466 | https://www.mcmaster.com/90323A466/
Stainless Steel M5 Locknut | 2 | 0.15 | 0.29 |  | https://www.mcmaster.com/94205A240/
Button Head Hex Drive Screw - M5 x 0.8 mm; Length: 14 mm | 8 | 0.16 | 1.28 | Part Number: 91239A230; Only comes in pack of 100, price is estimated on a per part basis | https://www.mcmaster.com/91239A230/
Aluminum Hex Nut - M5 x 0.8 mm | 8 | 0.26 | 2.07 | Part Number: 91854A102; Only comes in pack of 50, price is estimated on a per part basis | https://www.mcmaster.com/91854A102/
Zinc-Plated Alloy Steel Button Head Torx Screws - M3 x 0.5 mm; Length: 6 mm | 8 | 0.08 | 0.65 | Part Number: 92832A215, Only comes in pack of 100, price is estimated on a per part basis | https://www.mcmaster.com/92832A215/
Alloy Steel Socket Head Screw - M3 x 0.5 mm; Length: 4 mm | 18 | 0.13 | 2.33 | Part Number: 91290A109; Only comes in pack of 100, price is estimated on a per part basis | https://www.mcmaster.com/91290A109/
Hardware - Upright to Motor
Alloy Steel Socket Head Screw - M3 x 0.5 mm; Length: 10 mm | 12 | 0.10 | 1.14 | Part Number: 91290A115; Only comes in pack of 100; price is estimated on a per part basis | https://www.mcmaster.com/91290A115/
Button Head Torx Screw - M5 x 0.8 mm; Length 30 mm | 6 | 0.37 | 2.20 | Part Number: 90910A582; Only comes in pack of 25, price is estimated on a per part basis | https://www.mcmaster.com/90910A582/
Aluminum Washer - M5 Screw Size | 6 | 1.09 | 6.55 | Part Number: 92334A113, Only comes in pack of 10, price is estimated on a per part basis | https://www.mcmaster.com/92334A113/
Aluminum Hex Nut - M5 x 0.8 mm | 6 | 0.26 | 1.56 | Part Number: 91854A102; Only comes in pack of 50, price is estimated on a per part basis | https://www.mcmaster.com/91854A102/
Electrical - CAN Wire
Motor-to-Board CAN Wire - CABLE 2COND 28AWG CLEAR SHLD 25' | 2 | 5.98 | 11.96 | Digi-Key Part Number: CI28E-25-ND; Part comes in 25 feet, price estimated based on length used (~19 inches) | https://www.digikey.com/en/products/detail/969M101-28-1TPS-025/CI28E-25-ND/3526257?itemSeq=386416477
CJT Connectors - Motor End | 2 | 0.03 | 0.07 | LCSC Part Number: C339040; Only comes in pack of 20, price estimated on a per part basis | https://www.lcsc.com/product-detail/Rectangular-Connectors-Housings_CJT-Changjiang-Connectors-A1257H-4P_C339040.html
CJT Pins - Motor End | 4 | 0.01 | 0.04 | LCSC Part Number: C339052; Only comes in pack of 100, price estimated on a per part basis | https://www.lcsc.com/product-detail/Line-Pressing-Terminals_CJT-Changjiang-Connectors-A1257-TP_C339052.html
Molex Pins - Board End | 4 | 0.12 | 0.48 | Digi-Key Part Number: WM7933-ND | https://www.digikey.com/en/products/detail/molex/5013340100/1531513
Molex Connectors- Board End | 2 | 0.32 | 0.64 | Digi-Key Part Number: WM7915-ND | https://www.digikey.com/en/products/detail/molex/5013300200/1531499
Electrical - FSRs
Force Sensitve Resistors (FSRs) | 4 | 27.82 | 111.27 | Comes in pack 4 | https://www.tekscan.com/products-solutions/force-sensors/flexiforce-a502-sensor
Wire - FSRs (Ribbon Cable) | 8 | 0.33 | 2.66 | Has ten pins, only need two for each FSR; price estimated on a per foot basis | https://www.amazon.com/risingsaplings-Ribbon-Rainbow-1-27mm-2-54mm/dp/B097C84H9W
FSR - Male and Female Pin Headers | 8 | 0.45 | 3.60 | Contains 20 of each, only need 8; price estimated on per pair basis | https://www.amazon.com/2-54mm-Breakaway-Female-Connector-Arduino/dp/B01MQ48T2V
Electrical - FSR to Board Wire
FSR-to-Board Connecting Cable - CABLE 4COND 28AWG BLACK SHLD 5M | 1 | 21.97 | 21.97 | Digi-Key Part Number:T1319-5-ND; Part comes in 5 meters, price estimated based on length used (~ 4ft) | https://www.digikey.com/en/products/detail/tensility-international-corp/30-00491/5819490
Ribbon Cable Header for Board- CONN RCPT 8POS IDC 28AWG GOLD | 2 | 2.11 | 4.22 |  | https://www.digikey.com/en/products/detail/w%C3%BCrth-elektronik/61200823021/4846918
Ribbon Cable | 2 | 0.33 | 0.67 | Has 10 pins but only need eight, can use other two for FSRs; Price based on a per foot basis | https://www.amazon.com/risingsaplings-Ribbon-Rainbow-1-27mm-2-54mm/dp/B097C84H9W
Electrical - Power Switch
Xt30 Male and Female - For Battery-to-Board Connection & Motor to Board | 1 | 0.86 | 0.86 | Comes in a pack of 10 (also include XT30 Female and Heat Shrink, so you could use to make own power cables); price esimtated on per part basis | https://www.amazon.com/10Pairs-Upgrade-Connector-Female-Battery/dp/B08P5HVMYT
Xt60 Male - For Battery-to-Board Connection | 1 | 1.00 | 1.00 | Comes in pack of 10, price estimated on a per part basis | https://www.amazon.com/XT60E-M-Mountable-Connector-Models-Multicopter/dp/B07YJMCDC3?th=1
Switch | 1 | 2.13 | 2.13 | Digi-Key Part Number: EG1529-ND | https://www.digikey.com/en/products/detail/e-switch/R5ABLKBLKFF0/301976
25 FT 16 AWG Electrical Wire | 1 | 11.98 | 11.98 |  | https://www.amazon.com/Electrical-Conductor-parallel-silicone-Extension/dp/B07RRPFL3Q
16 AWG Quick Disconnect Terminals | 2 | 0.10 | 0.20 |  | https://www.amazon.com/TICONN-Disconnect-Connectors-Electrical-Assortment/dp/B08BZ972B5?cv_ct_cx=ticonn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
Electrical - Motor Power Cables
16 AWG Wire | Price Factored Above |  |  | Comes in a pack of 10 (also include XT30 Female and Heat Shrink, so you could use to make own power cables); price esimtated on per part basis | https://www.amazon.com/Electrical-Conductor-parallel-silicone-Extension/dp/B07RRPFL3Q
Xt30 Male and Female - For Battery-to-Board Connection & Motor to Board | Price Factored Above |  |  | Comes in a pack of 10 (also include XT30 Female and Heat Shrink, so you could use to make own power cables); price esimtated on per part basis | https://www.amazon.com/10Pairs-Upgrade-Connector-Female-Battery/dp/B08P5HVMYT
Heat Shrink | Price Factored Below |  |  | Digi-Key Part Number: EG1529-ND | https://www.amazon.com/650pcs-Shrink-Tubing-innhom-Approved/dp/B07WWWPR2X?hvadid=664381657194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
Electrical - Other
Battery | 1 | 37.99 | 37.99 | Comes in pack of 2, price estimated on a per part basis | https://www.amazon.com/HRB-1800mAh-Helicopter-Airplane-Multicopter/dp/B088QXJNJV/
TICOON Nylon Spade Female Terminals | 2 | 0.09 | 0.18 | Contains pack of 100, price estimated on a per part basis | https://www.amazon.com/TICONN-Disconnect-Connectors-Electrical-Assortment/dp/B08BZ972B5?cv_ct_cx=ticonn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
Arduino Nano 33 BLE (with Headers) | 1 | 31.25 | 31.25 | Digi-Key Part Number: 1050-ABX00034-ND | https://www.digikey.com/en/products/detail/arduino/ABX00034/10239973
Teensy 4.1 (with Headers) | 1 | 37.28 | 37.28 | Digi-Key Part Number: 1568-DEV-16996-ND | https://www.digikey.com/en/products/detail/sparkfun-electronics/DEV-16996/13158152
RGB LED | 1 | 2.04 | 2.04 | Digi-Key Part Number: 754-2153-ND | https://www.digikey.com/en/products/detail/kingbright/WP154A4SEJ3VBDZGC-CA/7597097
Heat Shrink - FSRs and Cables (CAN, FSR-to-Board, Battery Connectors) | 1 | 9.96 | 9.96 | Just listed as one part price wise but contains all you need for device and much more | https://www.amazon.com/650pcs-Shrink-Tubing-innhom-Approved/dp/B07WWWPR2X?hvadid=664381657194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
Thigh Cuffs
Denser Hook & Loop Adehsive Tape | 1 | 10.99 | 10.99 | You don't need full amount, Price listed as full amount due to challenge of estimate amount used | https://www.amazon.com/Denser-Sticky-Adhesive-Fastener-Strips/dp/B07N3B36Z2?th=1
3 mm thick Velcro Brand Fastener Compatible UBL Neoprene | 1 | 65.00 | 65.00 | 3mm Thick; Color: Black; You don't need full amount, Price listed as full amount due to challenge of estimating amount used | https://www.seattlefabrics.com/Velcroreg-Brand-Fastener-Compatible-UBL-Neoprene-by-the-Linear-Foot-starting-4500-per-linear-foot_p_843.html
Velcro Fastener | 1 | 1.36 | 1.36 | Comes in a pack of 5, you only need 2-4, price estimated on a per part basis | https://www.securecableties.com/18-x-2-inch-cinch-straps-5-pack
Aluminum Hex Nut - M5 x 0.8 mm | 4 | 0.26 | 1.04 | Part Number: 91854A102; Only comes in pack of 50, price is estimated on a per part basis | https://www.mcmaster.com/91854A102/
Screw - M5 x Length: 12 | 4 | 0.12 | 0.49 | Part Number: 91306A666; Only comes in pack of 100, price is estimated on a per part basis | https://www.mcmaster.com/91306A666/
Aluminum Washer - M5 Screw Size | 4 | 1.08 | 4.33 | Part Number: 92334A113, Only comes in pack of 10, price is estimated on a per part basis | https://www.mcmaster.com/92334A113/
Cam Handle - M3 x 0.5 mm; Length: 15 mm | 2 | 15.02 | 30.04 | Part Number: 5720K241 | https://www.mcmaster.com/5720K241/
Button Head Hex Drive Screw - M3 x 0.5 mm; Length: 16 mm | 2 | 0.09 | 0.19 | Part Number: 92095A184; Only comes in pack of 100, price is estimated on a per part basis | https://www.mcmaster.com/92095A184/
M3 Nut | 4 | 0.06 | 0.23 | Part Number: 90370A203, Only comes in pack of 100, price estimated on a per part basis | https://www.mcmaster.com/90370A203/
Misc
Hip Belt | 1 | 39.00 | 39.00 | Any similar waist belt will suffice, this product may have limited quantities, we will update this information and guide if we switch to new one | https://www.moosejaw.com/p/osprey-womens-isoform-cm-hipbelt-23trywsfrmcmhpbltbag/23trywsfrmcmhpbltbag?sku=25482757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
SD Card | 1 | 10.96 | 10.96 | 32 GB is enough | https://www.amazon.com/SanDisk-Extreme-microSDHC-UHS-3-SDSQXAF-032G-GN6MA/dp/B06XWMQ81P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
EVA Foam (White) [Optional] | 1 | 17.19 | 17.19 | 500 mm x 1500 mm, 6 mm Thick; Used for Insoles and Hip Belt Padding | https://thecosplaypros.com/products/eva-foam-sheets?variant=31293426860167
ESTIMATED PRICE | $2165.14 |  |  |  | This price is an estimate, does not include the cost of shipping associated with purchased parts and manufacuring of some components nor the tools needed to manufacture some of the components
