chobyeongjun/AR_Walker/Walker_Main/Hardware/Bowden_Transmission/Large_Cable/Bill_of_Materials_Large_Cable.xlsx

Item | Link | Count | Price ($) | Total ($)
Machined Parts
Sprocket (x2) AND Cable - Chain Interface (x4) | https://www.hubs.com/ | 1 | 562.24 | 562.24
Prefabricated Parts
Chain Master Link | https://www.mcmaster.com/catalog/130/1314/6027K71 | 4 | 1.83 | 7.32
05B Chain (2ft) | https://www.mcmaster.com/catalog/130/1314/6027K71 | 1 | 18 | 18
TMotors AK80-9 | https://www.cubemars.com/goods-982-AK80-9.html | 2 | 570.9 | 1141.8
6mm x 13mm x 5mm Flanged Ball Bearing (package of 10) | https://www.amazon.com/HiPicco-Flanged-Bearing-Shielded-Bearings/dp/B0CRLFPJPG?th=1 | 1 | 7.99 | 7.99
Large Steel Cable (250 ft) | https://www.amazon.com/Stainless-Steel-Aircraft-Cable-T304/dp/B00THGVV9W | 1 | 37.5 | 37.5
Large Cable Crimps (pack of 50) | https://www.mcmaster.com/3926T32/ | 1 | 11.54 | 11.54
Fasteners
M3X8 Buttonhead Screw (pack of 100) | https://www.mcmaster.com/products/screws/system-of-measurement~metric/rounded-head-screws~/metric-18-8-stainless-steel-button-head-hex-drive-screws/thread-siz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 | 1 | 8 | 8
M3X6 Buttonhead Screw (pack of 100) | https://www.mcmaster.com/products/screws/system-of-measurement~metric/rounded-head-screws~/metric-18-8-stainless-steel-button-head-hex-drive-screws/finish~pas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 | 1 | 5.83 | 5.83
M3X30 Flathead Screw (pack of 50) | https://www.mcmaster.com/products/screws/flat-head-screws~/metric-alloy-steel-hex-drive-flat-head-screws/thread-size~m3/length~30-mm/ | 1 | 6.93 | 6.93
M5X20 Buttonhead Screw (pack of 50) | https://www.mcmaster.com/products/screws/rounded-head-screws~/metric-18-8-stainless-steel-button-head-hex-drive-screws/thread-size~m5/length~20-mm/finish~pass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 | 1 | 12.38 | 12.38
M5 Lock Nuts (pack of 50) | https://www.mcmaster.com/products/nuts/locknuts~/nylon-insert-locknuts~~/system-of-measurement~metric/thread-size~m5/material~stainless-steel-2/ | 1 | 7.26 | 7.26
M3 Washer (pack of 10) | https://www.mcmaster.com/products/washers/washers-2~/metric-general-purpose-washers/screw-size~m3/material~aluminum-1/ | 1 | 10.4 | 10.4
M4X8 Buttonhead Screw (pack of 100) | https://www.mcmaster.com/products/screws/rounded-head-screws~/metric-18-8-stainless-steel-button-head-hex-drive-screws/thread-size~m4/length~8-mm/finish~passi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 | 1 | 10.09 | 10.09
Total: |  |  |  | 1847.28
Bowden Tube | https://catalog.lexcocable.com/item/conduit--casing-housing-/flat-stock-coiled-steel-bicycle-type-conduit/-7mm2p | 1
