chobyeongjun/AR_Walker/Walker_Main/Hardware/Bowden_Transmission/Large_Cable/Universal Cable Chain Interface/UCCI.STEP

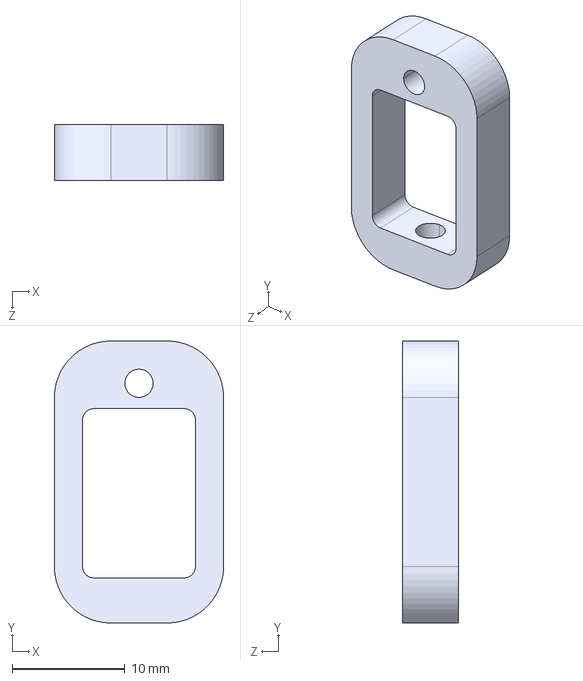
[picture p15: CAD file, 2025-08-19]
Walker_Main/Hardware/Bowden_Transmission/Large_Cable/Universal Cable Chain Interface/UCCI.STEP
15.0 x 25.0 x 5.00 mm
