chobyeongjun/AR_Walker/Walker_Main/Hardware/Bowden_Transmission/Parts/AK60V1.1/3D_Printed_Parts/Heat_Shield (Optional)/ak60v1_1HeatShield.SLDPRT

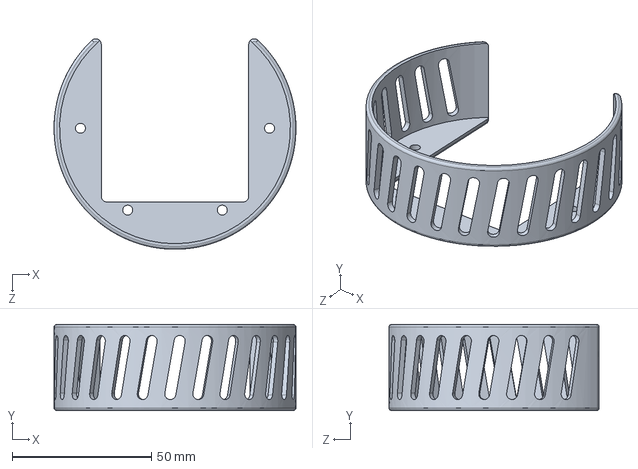
[picture p16: CAD file, 2025-08-19]
Walker_Main/Hardware/Bowden_Transmission/Parts/AK60V1.1/3D_Printed_Parts/Heat_Shield (Optional)/ak60v1_1HeatShield.SLDPRT
87.0 x 31.0 x 75.7 mm
