chobyeongjun/AR_Walker/Walker_Main/Hardware/Bowden_Transmission/Parts/AK60V1.1/3D_Printed_Parts/Strain_Relief_Inserts_TPU.SLDPRT

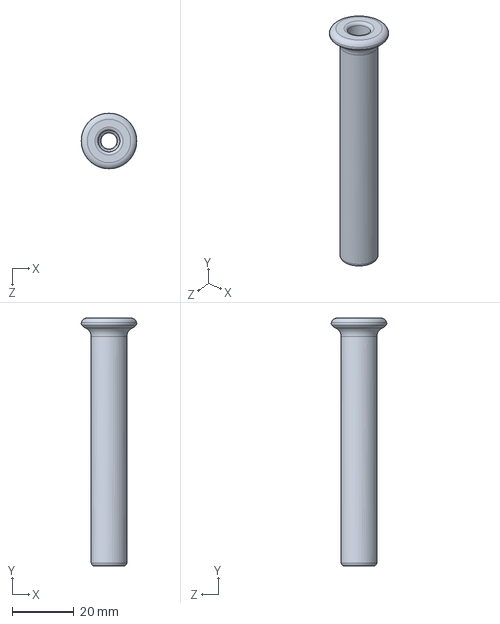
[picture p17: CAD file, 2025-08-19]
Walker_Main/Hardware/Bowden_Transmission/Parts/AK60V1.1/3D_Printed_Parts/Strain_Relief_Inserts_TPU.SLDPRT
17.9 x 80.0 x 17.9 mm
