chobyeongjun/AR_Walker/Walker_Main/Hardware/Bowden_Transmission/Parts/AK60V1.1/Machined_Parts/Sprocket_AK60V1_1.SLDPRT

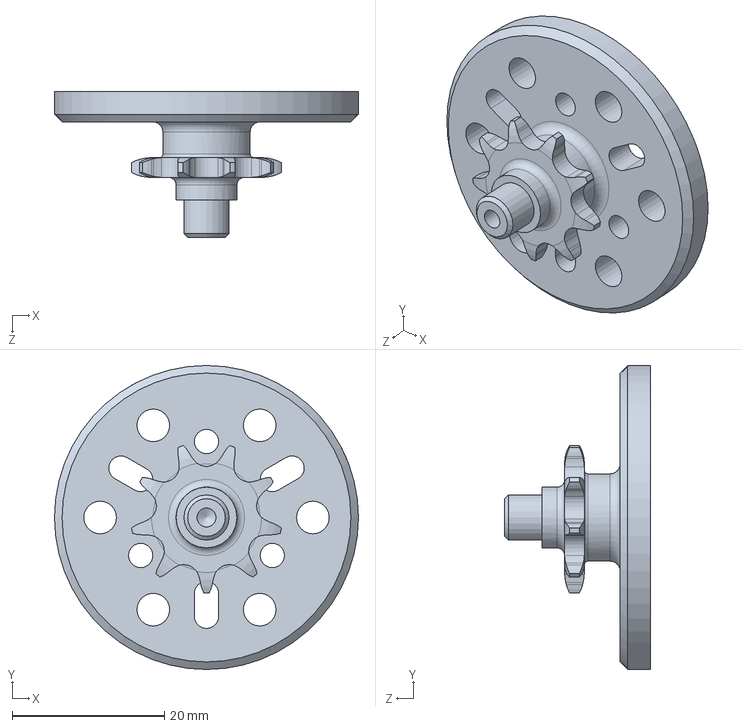
[picture p18: CAD file, 2025-08-19]
Walker_Main/Hardware/Bowden_Transmission/Parts/AK60V1.1/Machined_Parts/Sprocket_AK60V1_1.SLDPRT
40.0 x 40.0 x 19.2 mm
