chobyeongjun/AR_Walker/Walker_Main/Hardware/Bowden_Transmission/Parts/AK70/3D_Printed_Parts/Belt_to_Motor_AK70.SLDPRT

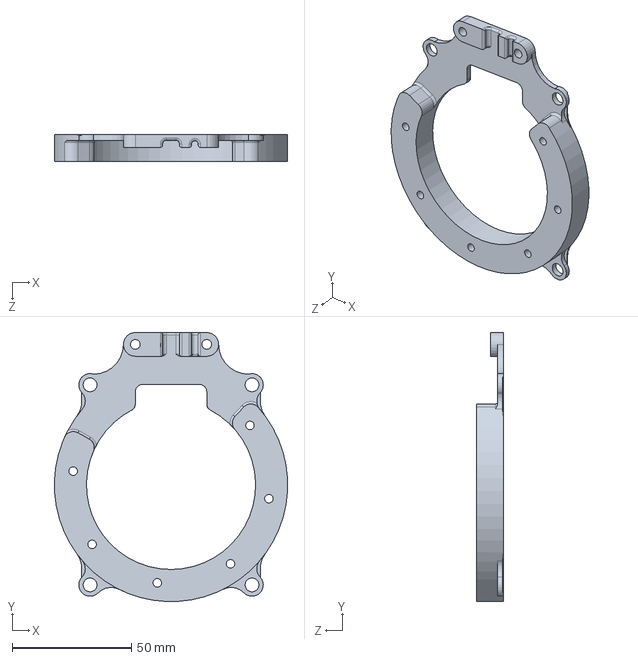
[picture p19: CAD file, 2025-08-19]
Walker_Main/Hardware/Bowden_Transmission/Parts/AK70/3D_Printed_Parts/Belt_to_Motor_AK70.SLDPRT
97.9 x 113.0 x 11.5 mm
