chobyeongjun/AR_Walker/Walker_Main/Hardware/Bowden_Transmission/Parts/AK70/AK70-10.SLDPRT

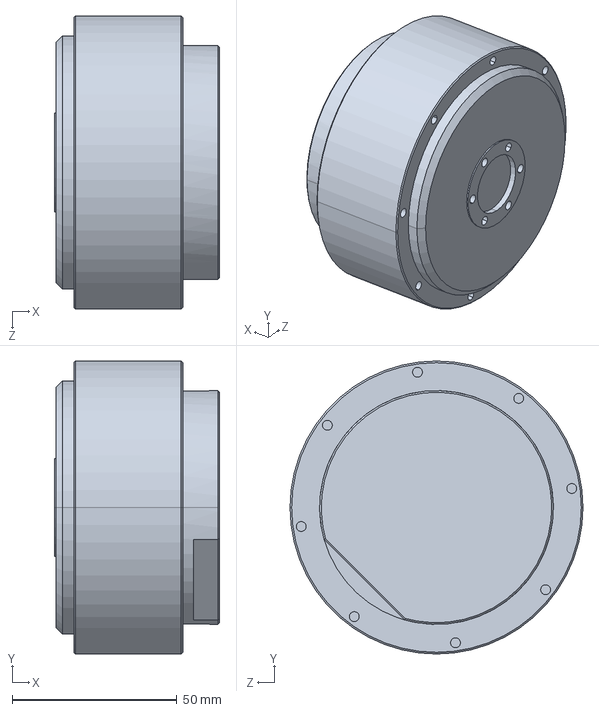
[picture p20: CAD file, 2025-08-19]
Walker_Main/Hardware/Bowden_Transmission/Parts/AK70/AK70-10.SLDPRT
50.2 x 89.0 x 89.0 mm
