chobyeongjun/AR_Walker/Walker_Main/Hardware/Bowden_Transmission/Parts/AK70/Machined_Parts/Cable_Chain_Interface.SLDPRT

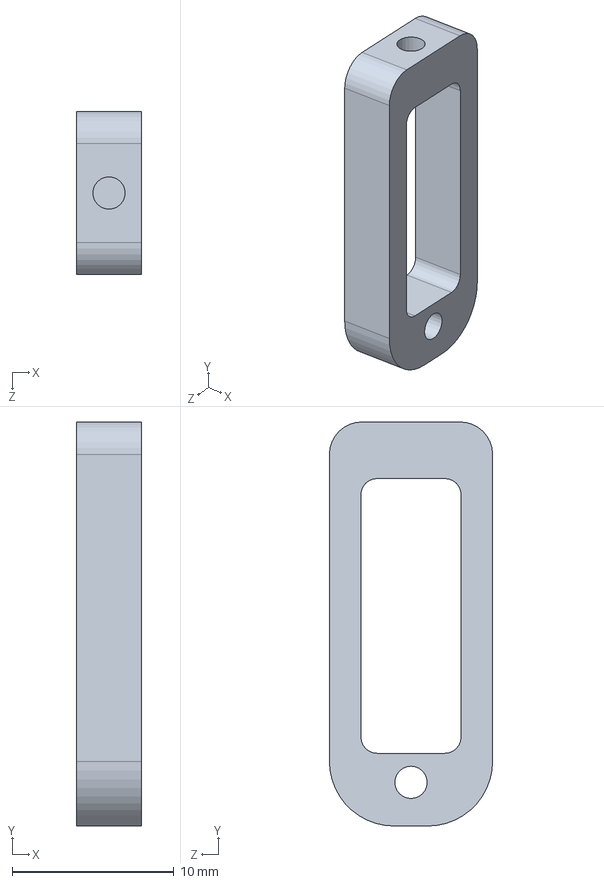
[picture p21: CAD file, 2025-08-19]
Walker_Main/Hardware/Bowden_Transmission/Parts/AK70/Machined_Parts/Cable_Chain_Interface.SLDPRT
4.00 x 25.0 x 10.1 mm
