chobyeongjun/AR_Walker/Walker_Main/Hardware/Bowden_Transmission/Parts/AK80/3D_Printed_Parts/Back_Cover_AK80.SLDPRT

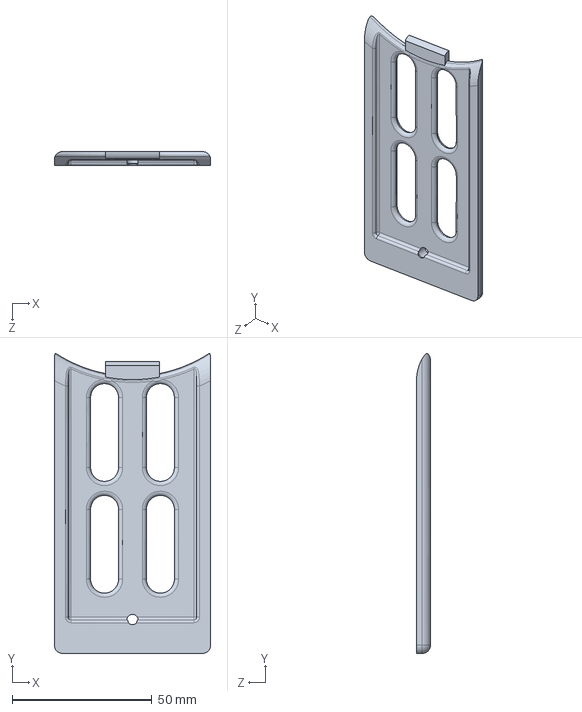
[picture p22: CAD file, 2025-08-19]
Walker_Main/Hardware/Bowden_Transmission/Parts/AK80/3D_Printed_Parts/Back_Cover_AK80.SLDPRT
56.0 x 107.4 x 5.00 mm
