chobyeongjun/AR_Walker/Walker_Main/Hardware/Bowden_Transmission/Parts/AK80/3D_Printed_Parts/Heat_Shield (Optional)/ak80HeatShield.SLDPRT

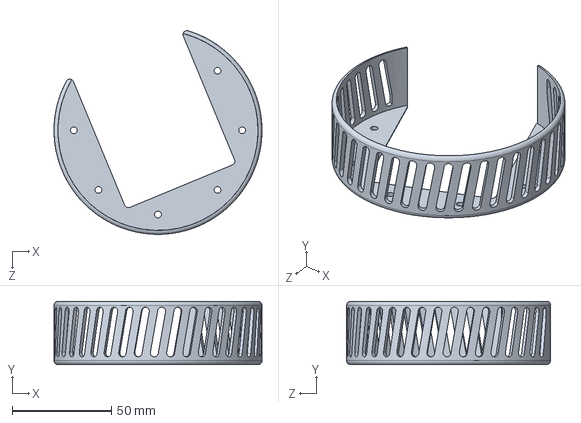
[picture p23: CAD file, 2025-08-19]
Walker_Main/Hardware/Bowden_Transmission/Parts/AK80/3D_Printed_Parts/Heat_Shield (Optional)/ak80HeatShield.SLDPRT
105.0 x 32.0 x 102.8 mm
