chobyeongjun/AR_Walker/Walker_Main/Hardware/Bowden_Transmission/Parts/AK80/AK80-9.SLDPRT

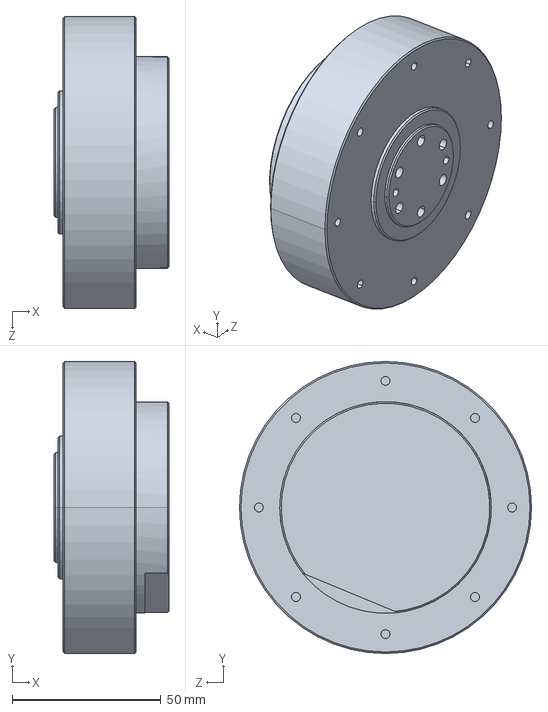
[picture p24: CAD file, 2025-08-19]
Walker_Main/Hardware/Bowden_Transmission/Parts/AK80/AK80-9.SLDPRT
38.5 x 98.0 x 98.0 mm
