chobyeongjun/AR_Walker/Walker_Main/Hardware/Bowden_Transmission/Parts/MotorCableStrainRelief.SLDPRT

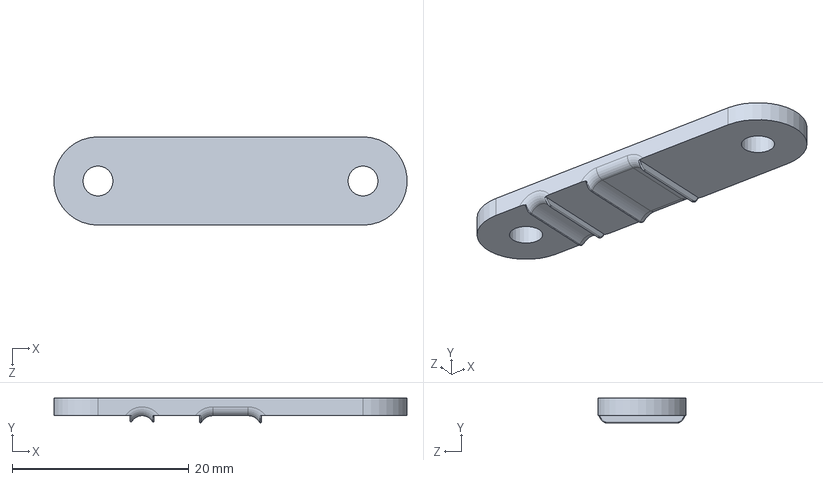
[picture p25: CAD file, 2025-08-19]
Walker_Main/Hardware/Bowden_Transmission/Parts/MotorCableStrainRelief.SLDPRT
40.0 x 2.82 x 10.0 mm
