chobyeongjun/AR_Walker/Walker_Main/Hardware/Hip_Device/Part Files for 3D Printing/Heat_Shield (Optional)/hipHeatShield.SLDPRT

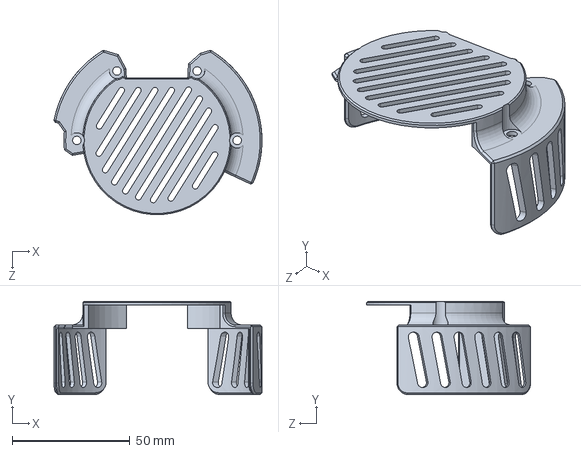
[picture p26: CAD file, 2025-08-19]
Walker_Main/Hardware/Hip_Device/Part Files for 3D Printing/Heat_Shield (Optional)/hipHeatShield.SLDPRT
88.2 x 39.5 x 69.6 mm
