chobyeongjun/AR_Walker/Walker_Main/Hardware/Hip_Device/Part Files for 3D Printing/thighCuffFront.SLDPRT

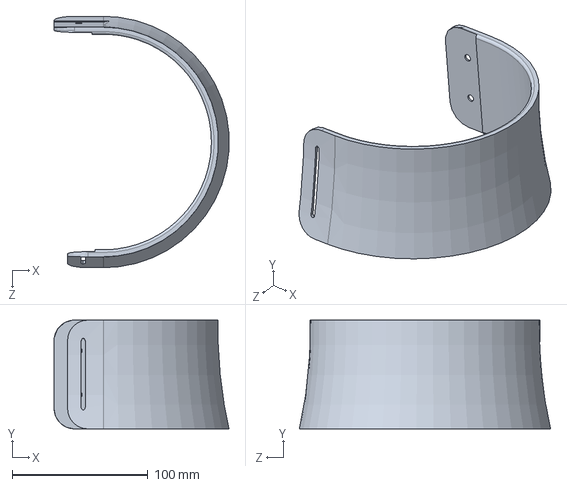
[picture p27: CAD file, 2025-08-19]
Walker_Main/Hardware/Hip_Device/Part Files for 3D Printing/thighCuffFront.SLDPRT
128.7 x 80.0 x 184.8 mm
