chobyeongjun/AR_Walker/Walker_Main/Hardware/Hip_Device/Part Files for Machining/Aluminum Machining/adAbductionBlockHipSide.SLDPRT

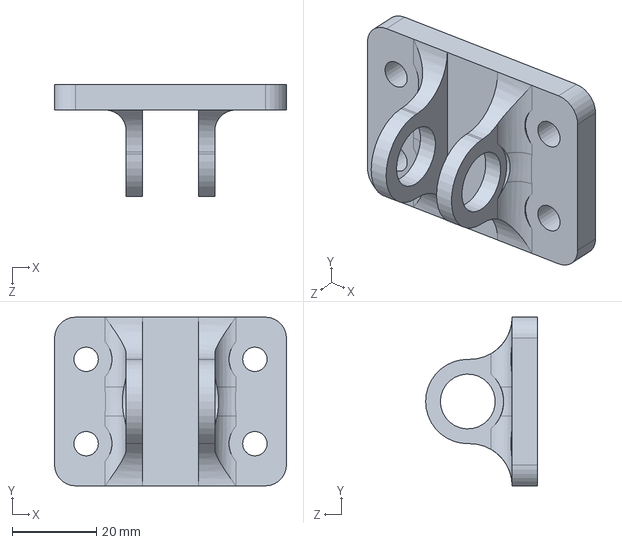
[picture p28: CAD file, 2025-08-19]
Walker_Main/Hardware/Hip_Device/Part Files for Machining/Aluminum Machining/adAbductionBlockHipSide.SLDPRT
55.0 x 40.0 x 26.5 mm
