chobyeongjun/AR_Walker/Walker_Main/Hardware/Hip_Device/Part Files for Machining/CF Machining/hipAdapterInner.SLDPRT

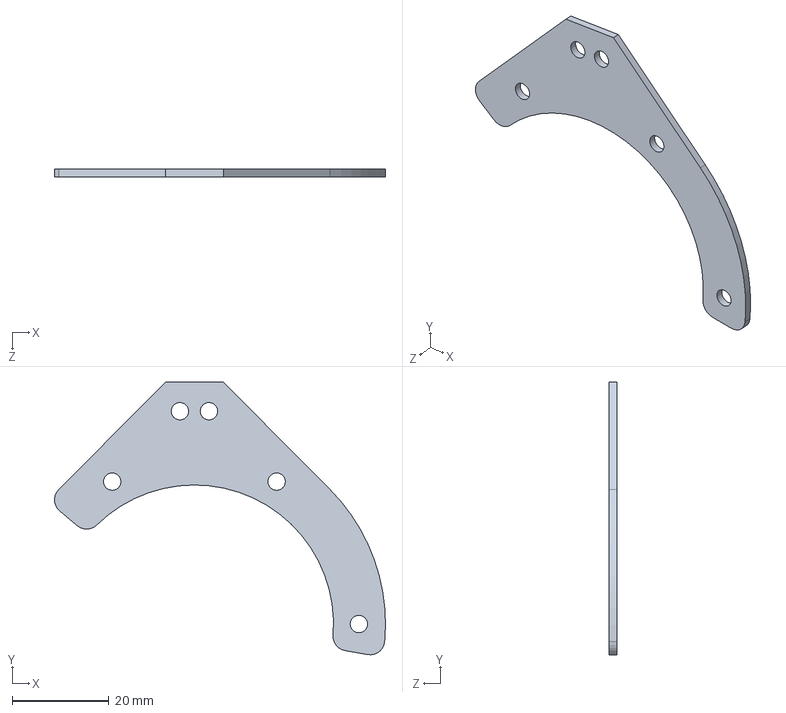
[picture p29: CAD file, 2025-08-19]
Walker_Main/Hardware/Hip_Device/Part Files for Machining/CF Machining/hipAdapterInner.SLDPRT
68.4 x 56.4 x 1.59 mm
