chobyeongjun/AR_Walker/Walker_Main/Hardware/Bowden_Transmission/Parts/AK60V1.1/3D_Printed_Parts/Belt_to_Motor_AK60V1_1.SLDPRT

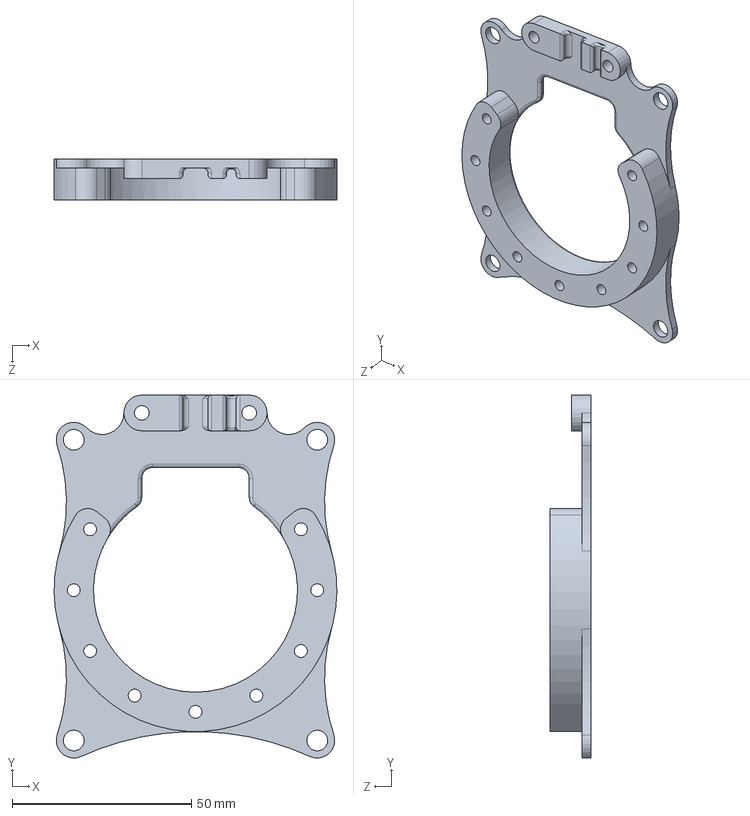
[picture p30: CAD file, 2025-08-19]
Walker_Main/Hardware/Bowden_Transmission/Parts/AK60V1.1/3D_Printed_Parts/Belt_to_Motor_AK60V1_1.SLDPRT
79.0 x 101.4 x 11.5 mm
