chobyeongjun/AR_Walker/Walker_Main/Hardware/Bowden_Transmission/Parts/AK60V1.1/Machined_Parts/Cable_Chain_Interface_AK60V1.1.SLDPRT

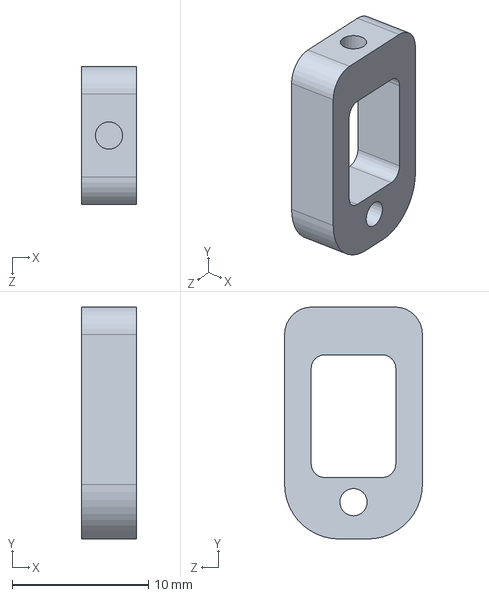
[picture p31: CAD file, 2025-08-19]
Walker_Main/Hardware/Bowden_Transmission/Parts/AK60V1.1/Machined_Parts/Cable_Chain_Interface_AK60V1.1.SLDPRT
4.00 x 17.0 x 10.1 mm
