chobyeongjun/AR_Walker/Walker_Main/Hardware/Bowden_Transmission/Parts/AK70/3D_Printed_Parts/Back_Cover_AK70.SLDPRT

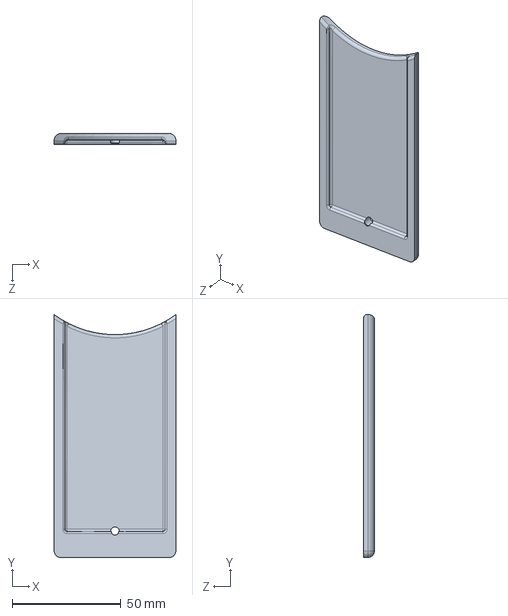
[picture p32: CAD file, 2025-08-19]
Walker_Main/Hardware/Bowden_Transmission/Parts/AK70/3D_Printed_Parts/Back_Cover_AK70.SLDPRT
56.0 x 111.8 x 5.00 mm
