chobyeongjun/AR_Walker/Walker_Main/Hardware/Bowden_Transmission/Parts/AK70/Machined_Parts/Sprocket_AK70.SLDPRT

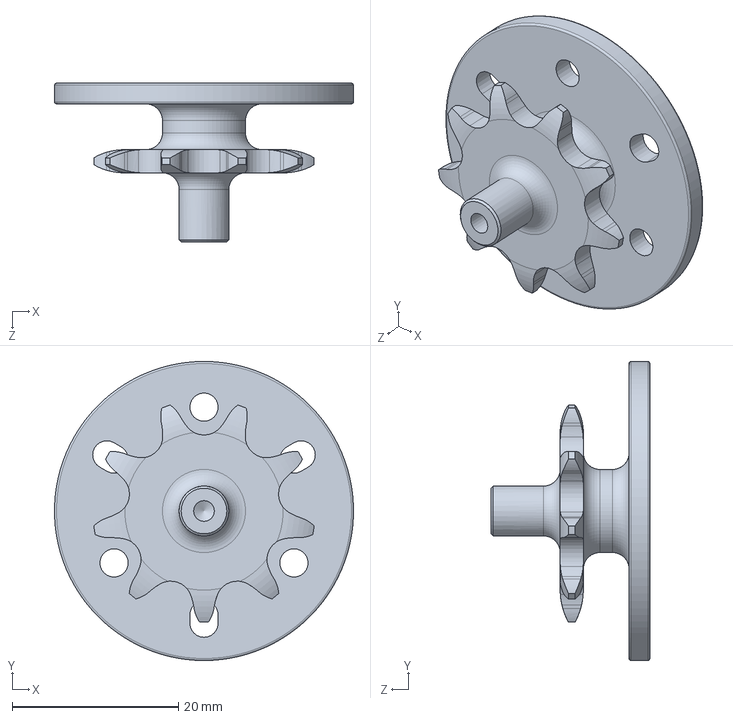
[picture p33: CAD file, 2025-08-19]
Walker_Main/Hardware/Bowden_Transmission/Parts/AK70/Machined_Parts/Sprocket_AK70.SLDPRT
36.0 x 36.0 x 19.1 mm
