chobyeongjun/AR_Walker/Walker_Main/Hardware/Bowden_Transmission/Parts/AK80/3D_Printed_Parts/Strain_Relief_Shell.SLDPRT

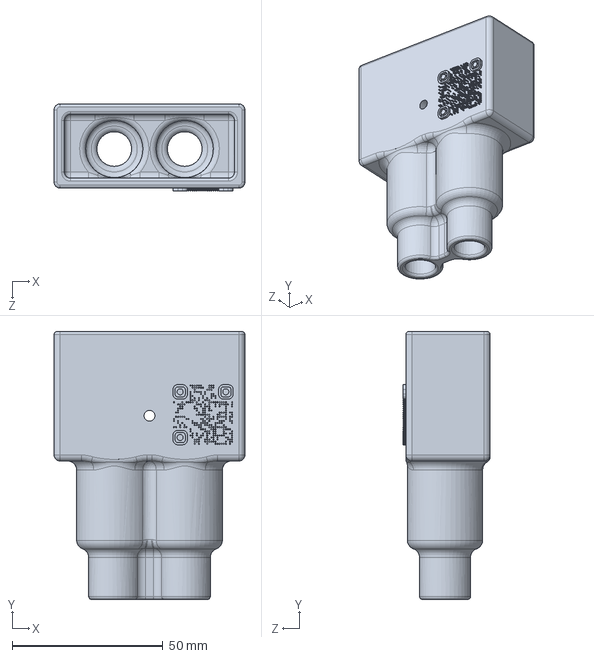
[picture p34: CAD file, 2025-08-19]
Walker_Main/Hardware/Bowden_Transmission/Parts/AK80/3D_Printed_Parts/Strain_Relief_Shell.SLDPRT
63.4 x 89.0 x 29.0 mm
