chobyeongjun/AR_Walker/Walker_Main/Hardware/Bowden_Transmission/Parts/AK80/Machined_Parts/Sprocket_AK80.SLDPRT

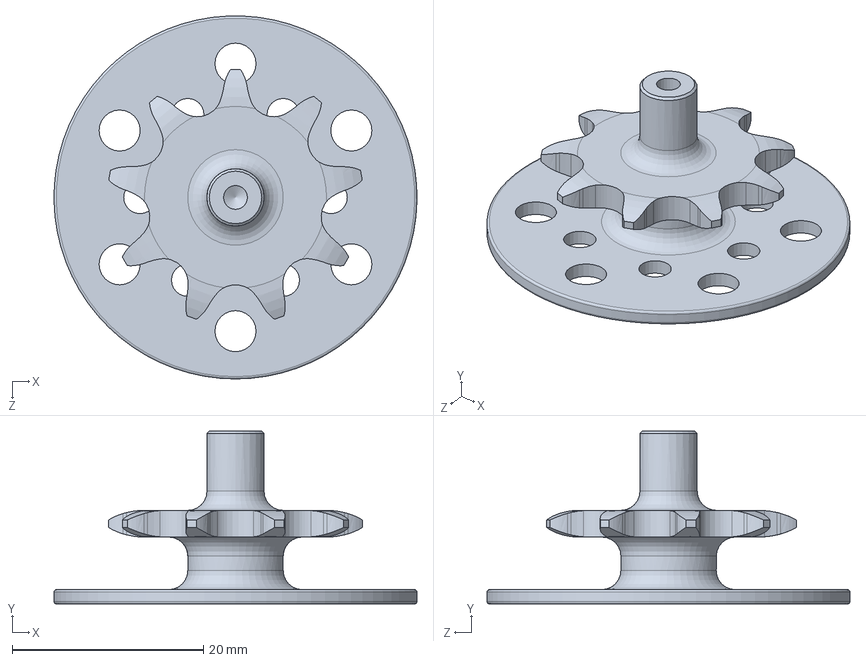
[picture p35: CAD file, 2025-08-19]
Walker_Main/Hardware/Bowden_Transmission/Parts/AK80/Machined_Parts/Sprocket_AK80.SLDPRT
38.0 x 18.1 x 38.0 mm
