chobyeongjun/AR_Walker/Walker_Main/Hardware/Hip_Device/Part Files for 3D Printing/cuffSliderTop.SLDPRT

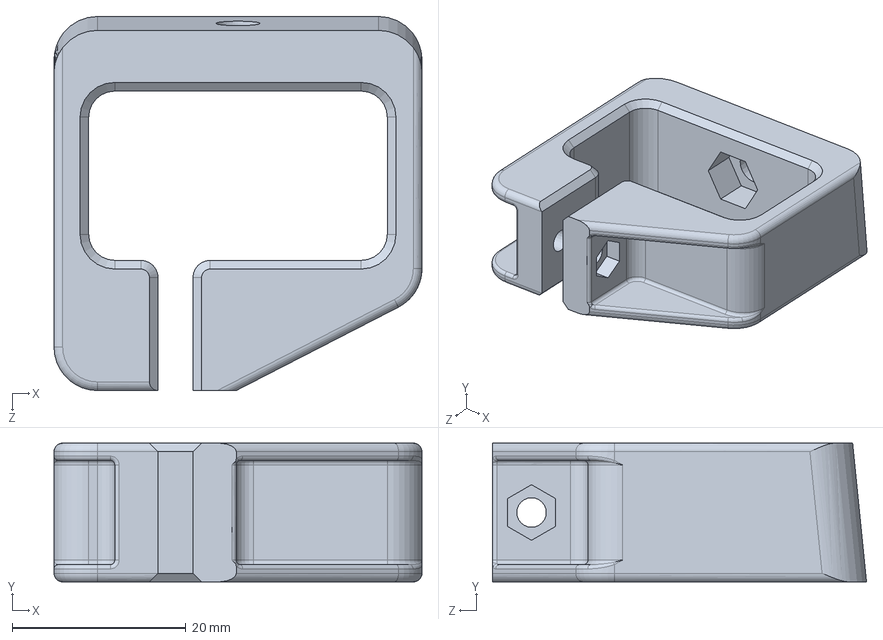
[picture p36: CAD file, 2025-08-19]
Walker_Main/Hardware/Hip_Device/Part Files for 3D Printing/cuffSliderTop.SLDPRT
42.4 x 16.0 x 43.1 mm
