chobyeongjun/AR_Walker/Walker_Main/Hardware/Hip_Device/Part Files for Machining/Aluminum Machining/adAbductionBlockLegSide.SLDPRT

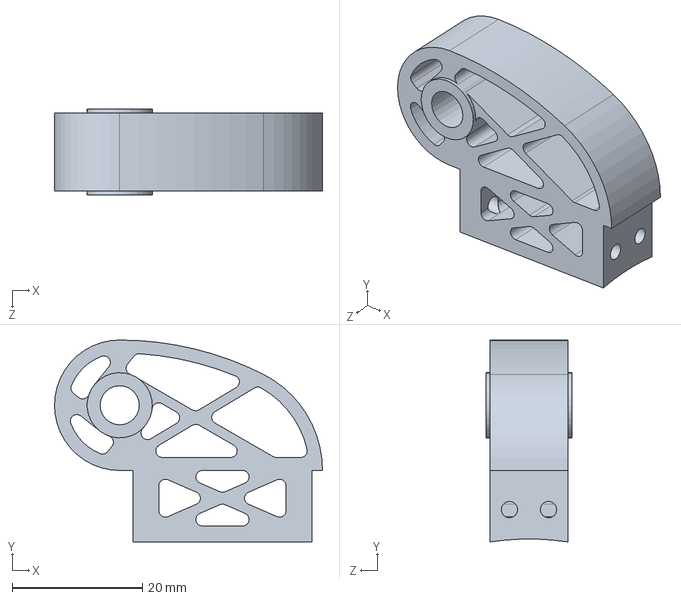
[picture p37: CAD file, 2025-08-19]
Walker_Main/Hardware/Hip_Device/Part Files for Machining/Aluminum Machining/adAbductionBlockLegSide.SLDPRT
41.1 x 31.0 x 13.2 mm
