chobyeongjun/AR_Walker/Walker_Main/Hardware/Hip_Device/Part Files for Machining/CF Machining/motorToStrutSupport.SLDPRT

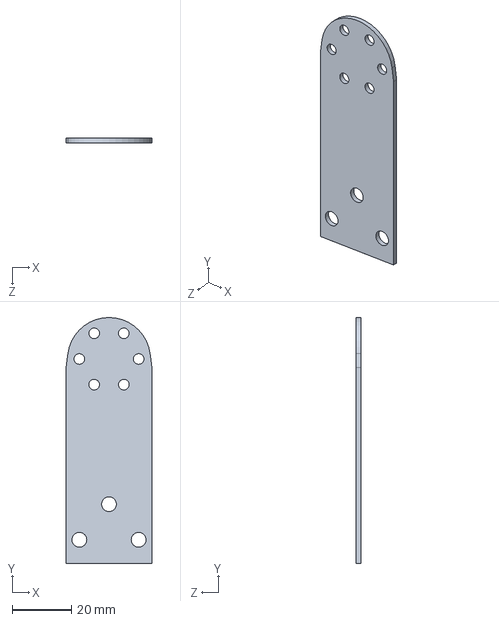
[picture p38: CAD file, 2025-08-19]
Walker_Main/Hardware/Hip_Device/Part Files for Machining/CF Machining/motorToStrutSupport.SLDPRT
29.0 x 83.0 x 1.59 mm
