chobyeongjun/AR_Walker/Walker_Main/Hardware/Bowden_Transmission/Parts/AK60V1.1/3D_Printed_Parts/Strain_Relief_Shell_AK60V1_1.SLDPRT

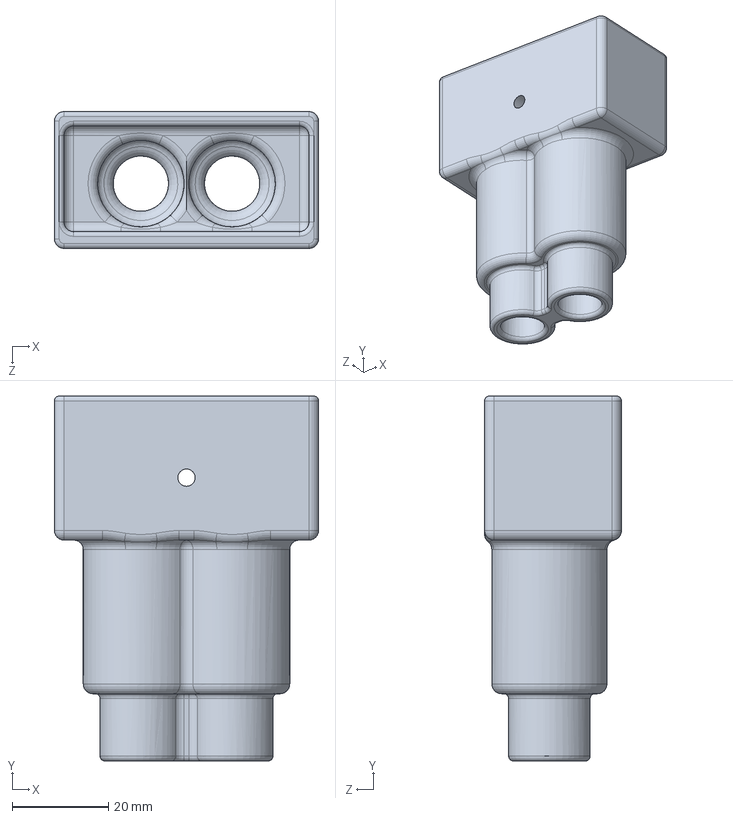
[picture p39: CAD file, 2025-08-19]
Walker_Main/Hardware/Bowden_Transmission/Parts/AK60V1.1/3D_Printed_Parts/Strain_Relief_Shell_AK60V1_1.SLDPRT
55.0 x 76.0 x 28.5 mm
