chobyeongjun/AR_Walker/Walker_Main/Hardware/Bowden_Transmission/Parts/AK70/3D_Printed_Parts/Cartridge_Spacer_AK70.SLDPRT

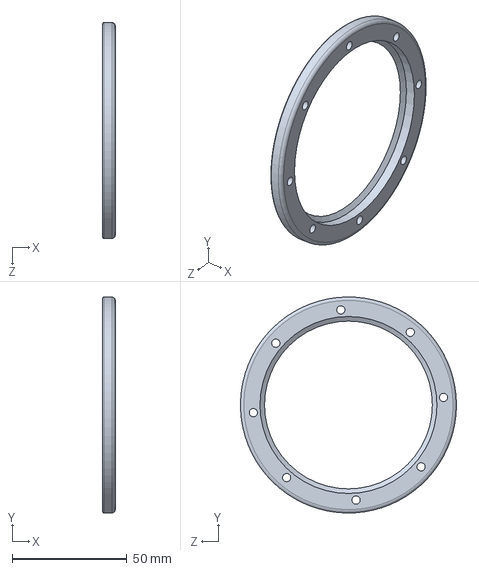
[picture p40: CAD file, 2025-08-19]
Walker_Main/Hardware/Bowden_Transmission/Parts/AK70/3D_Printed_Parts/Cartridge_Spacer_AK70.SLDPRT
5.50 x 94.0 x 94.0 mm
