chobyeongjun/AR_Walker/Walker_Main/Hardware/Hip_Device/Part Files for 3D Printing/cuffSliderBottom.SLDPRT

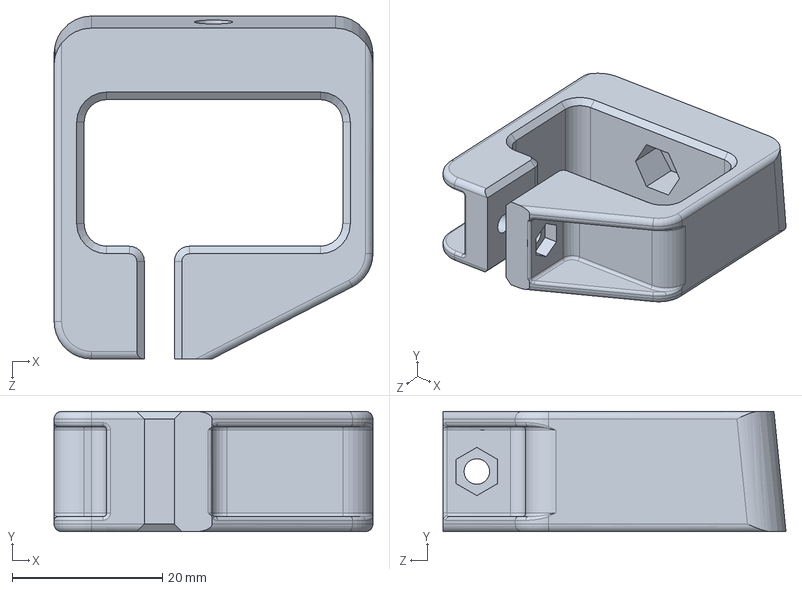
[picture p41: CAD file, 2025-08-19]
Walker_Main/Hardware/Hip_Device/Part Files for 3D Printing/cuffSliderBottom.SLDPRT
42.4 x 16.0 x 45.6 mm
