chobyeongjun/AR_Walker/Walker_Main/Hardware/Bowden_Transmission/Parts/AK70/3D_Printed_Parts/Cartridge_AK70.SLDPRT

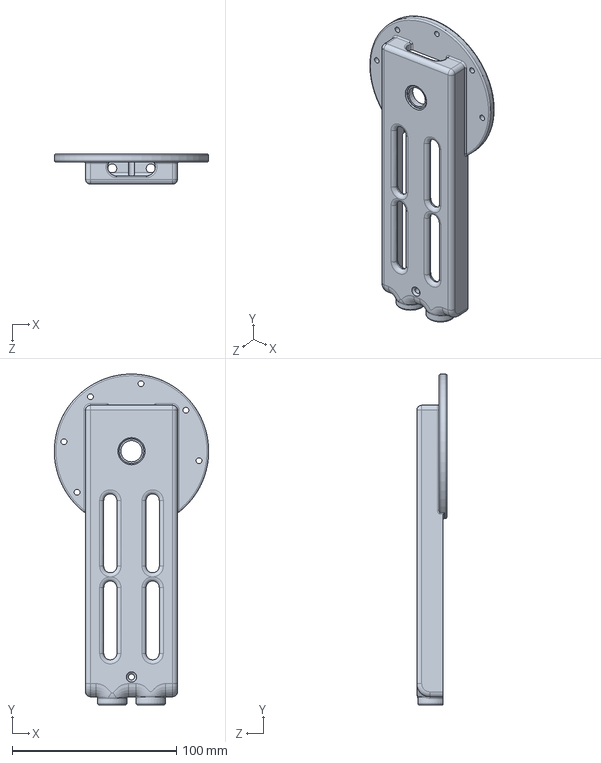
[picture p42: CAD file, 2025-08-19]
Walker_Main/Hardware/Bowden_Transmission/Parts/AK70/3D_Printed_Parts/Cartridge_AK70.SLDPRT
94.0 x 201.5 x 18.5 mm
