chobyeongjun/AR_Walker/Walker_Main/Hardware/Bowden_Transmission/Parts/AK80/3D_Printed_Parts/Cartridge_AK80.SLDPRT

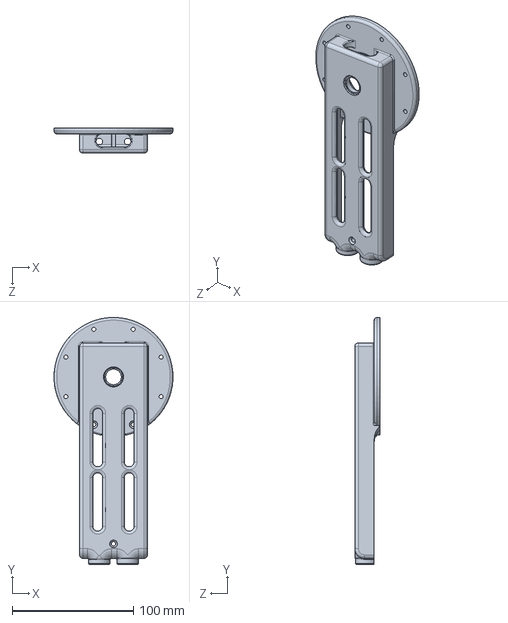
[picture p43: CAD file, 2025-08-19]
Walker_Main/Hardware/Bowden_Transmission/Parts/AK80/3D_Printed_Parts/Cartridge_AK80.SLDPRT
98.0 x 203.4 x 21.0 mm
