chobyeongjun/AR_Walker/Walker_Main/Hardware/Hip_Device/Part Files for 3D Printing/motorToStrut.SLDPRT

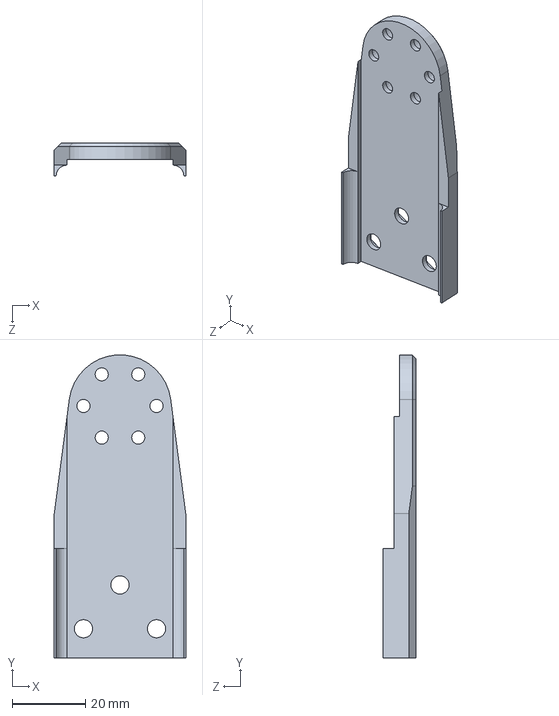
[picture p44: CAD file, 2025-08-19]
Walker_Main/Hardware/Hip_Device/Part Files for 3D Printing/motorToStrut.SLDPRT
36.0 x 82.9 x 9.09 mm
