chobyeongjun/AR_Walker/Walker_Main/Hardware/Hip_Device/Part Files for Machining/CF Machining/hipAdapterOuter.SLDPRT

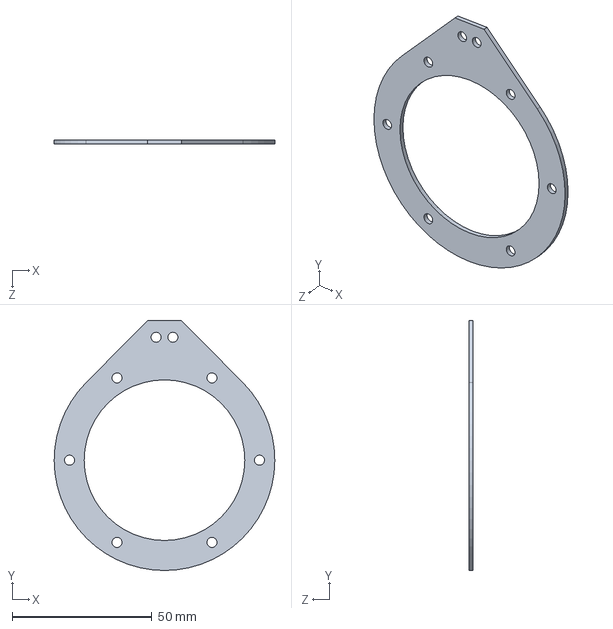
[picture p45: CAD file, 2025-08-19]
Walker_Main/Hardware/Hip_Device/Part Files for Machining/CF Machining/hipAdapterOuter.SLDPRT
79.0 x 89.5 x 1.59 mm
