chobyeongjun/AR_Walker/Walker_Main/Hardware/Bowden_Transmission/Parts/AK60V1.1/3D_Printed_Parts/Back_Cover_AK60V1_1.SLDPRT

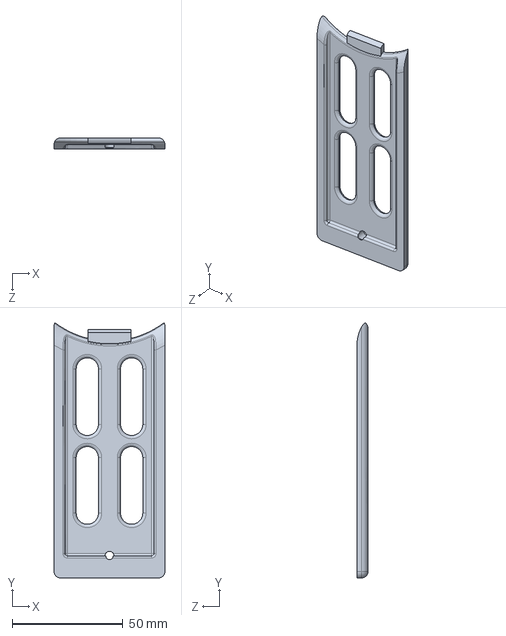
[picture p46: CAD file, 2025-08-19]
Walker_Main/Hardware/Bowden_Transmission/Parts/AK60V1.1/3D_Printed_Parts/Back_Cover_AK60V1_1.SLDPRT
50.0 x 114.9 x 5.00 mm
