chobyeongjun/AR_Walker/Walker_Main/Hardware/Hip_Device/Part Files for Machining/CF Machining/motorBracketSpacer.SLDPRT

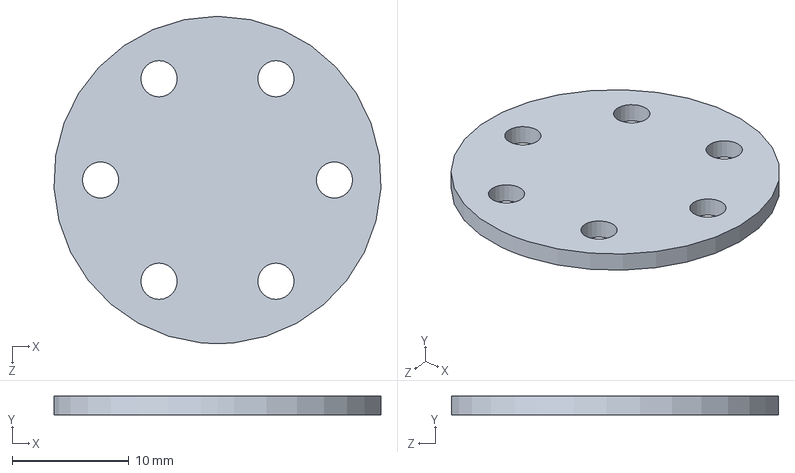
[picture p47: CAD file, 2025-08-19]
Walker_Main/Hardware/Hip_Device/Part Files for Machining/CF Machining/motorBracketSpacer.SLDPRT
28.0 x 1.59 x 28.0 mm
