chobyeongjun/AR_Walker/Walker_Main/Hardware/Bowden_Transmission/Parts/AK60V1.1/3D_Printed_Parts/Cartridge_AK60V1_1.SLDPRT

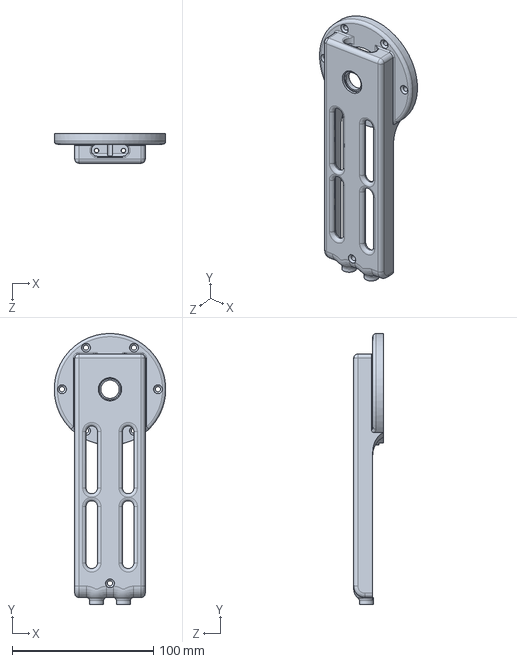
[picture p48: CAD file, 2025-08-19]
Walker_Main/Hardware/Bowden_Transmission/Parts/AK60V1.1/3D_Printed_Parts/Cartridge_AK60V1_1.SLDPRT
79.0 x 192.0 x 21.0 mm
