chobyeongjun/AR_Walker/Walker_Main/Hardware/Hip_Device/Part Files for 3D Printing/electronicsBoxBatteryCover.SLDPRT

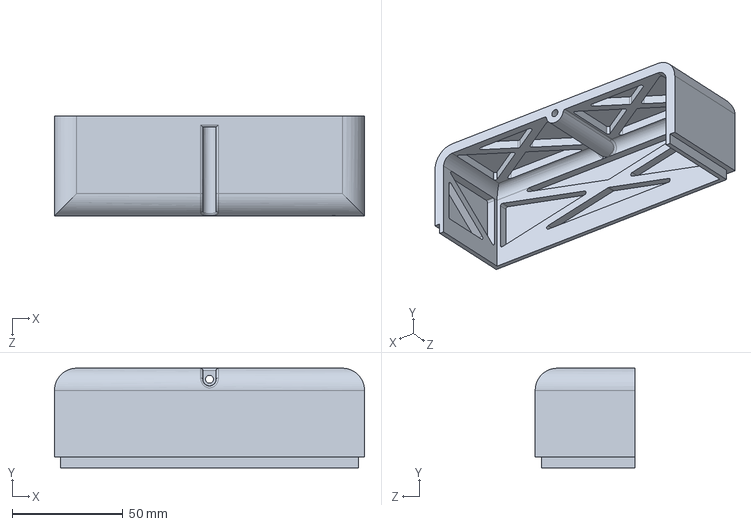
[picture p49: CAD file, 2025-08-19]
Walker_Main/Hardware/Hip_Device/Part Files for 3D Printing/electronicsBoxBatteryCover.SLDPRT
140.0 x 45.0 x 45.0 mm
