chobyeongjun/AR_Walker/Walker_Main/Hardware/Hip_Device/Part Files for Machining/CF Machining/carbonFiberStrut.SLDPRT

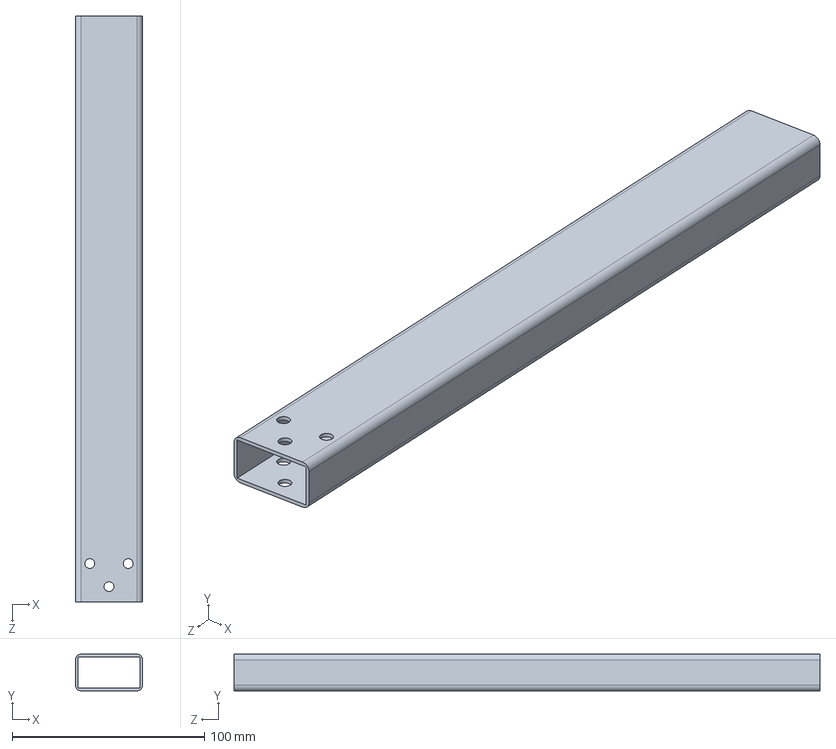
[picture p50: CAD file, 2025-08-19]
Walker_Main/Hardware/Hip_Device/Part Files for Machining/CF Machining/carbonFiberStrut.SLDPRT
35.0 x 19.2 x 304.8 mm
