chobyeongjun/AR_Walker/Walker_Main/Hardware/Hip_Device/Part Files for 3D Printing/electronicsBoxStrainReliefRight.SLDPRT

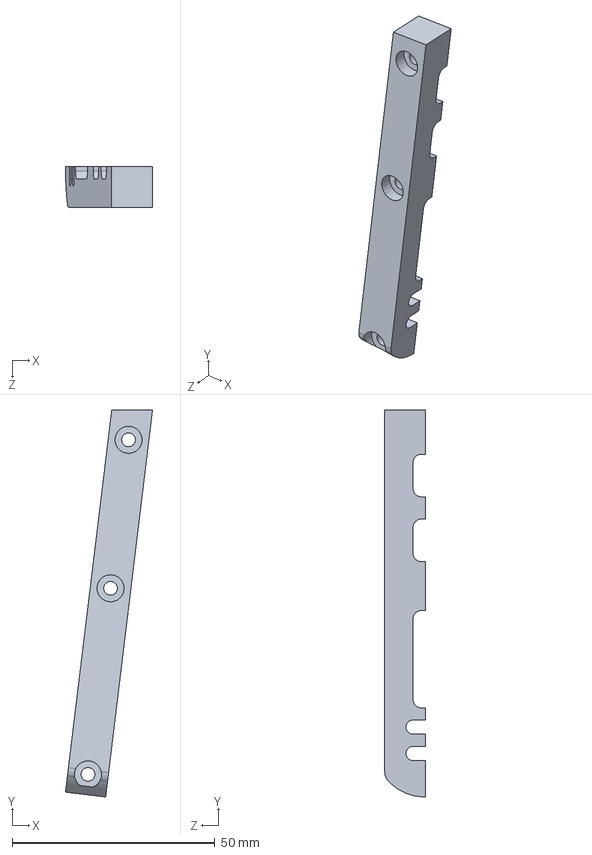
[picture p51: CAD file, 2025-08-19]
Walker_Main/Hardware/Hip_Device/Part Files for 3D Printing/electronicsBoxStrainReliefRight.SLDPRT
21.5 x 95.5 x 10.0 mm
