chobyeongjun/AR_Walker/Walker_Main/Hardware/Hip_Device/Part Files for 3D Printing/electronicsBoxBackPlate.SLDPRT

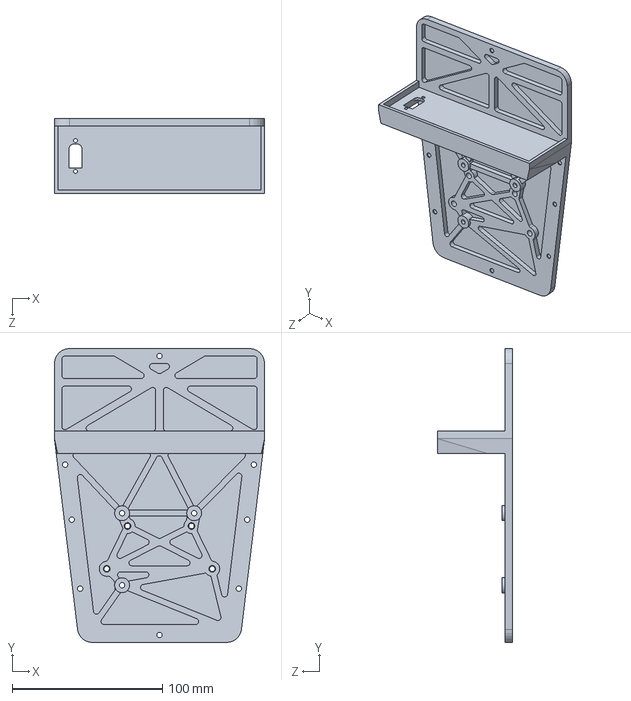
[picture p52: CAD file, 2025-08-19]
Walker_Main/Hardware/Hip_Device/Part Files for 3D Printing/electronicsBoxBackPlate.SLDPRT
140.0 x 195.8 x 50.0 mm
