chobyeongjun/AR_Walker/Walker_Main/Hardware/Hip_Device/Part Files for 3D Printing/electronicsBoxStrainReliefLeft.SLDPRT

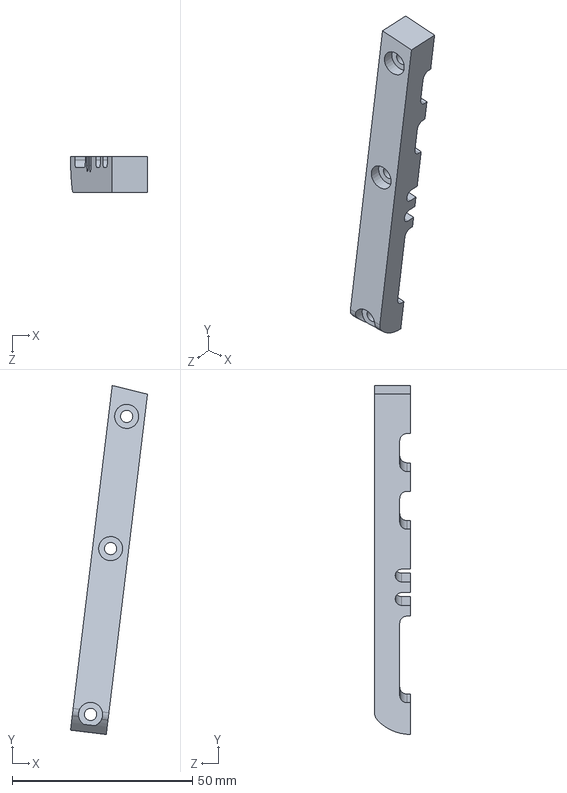
[picture p53: CAD file, 2025-08-19]
Walker_Main/Hardware/Hip_Device/Part Files for 3D Printing/electronicsBoxStrainReliefLeft.SLDPRT
21.3 x 96.7 x 10.0 mm
