chobyeongjun/AR_Walker/Walker_Main/Hardware/Hip_Device/Part Files for 3D Printing/electronicsBoxControlPanel.SLDPRT

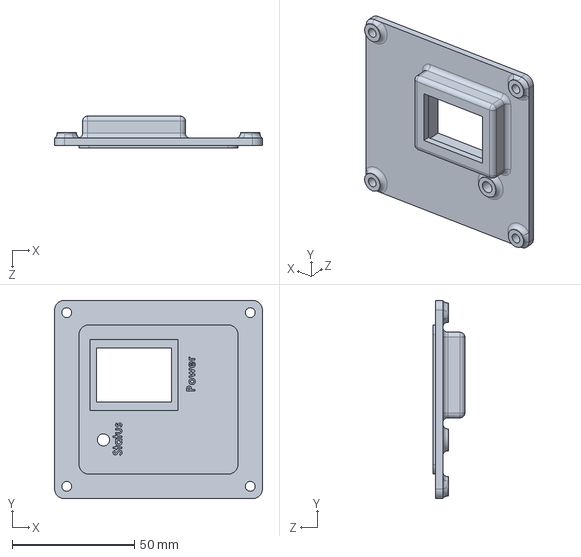
[picture p54: CAD file, 2025-08-19]
Walker_Main/Hardware/Hip_Device/Part Files for 3D Printing/electronicsBoxControlPanel.SLDPRT
85.0 x 81.0 x 13.0 mm
