chobyeongjun/AR_Walker/Walker_Main/Hardware/Hip_Device/Part Files for 3D Printing/heelPuck.SLDPRT

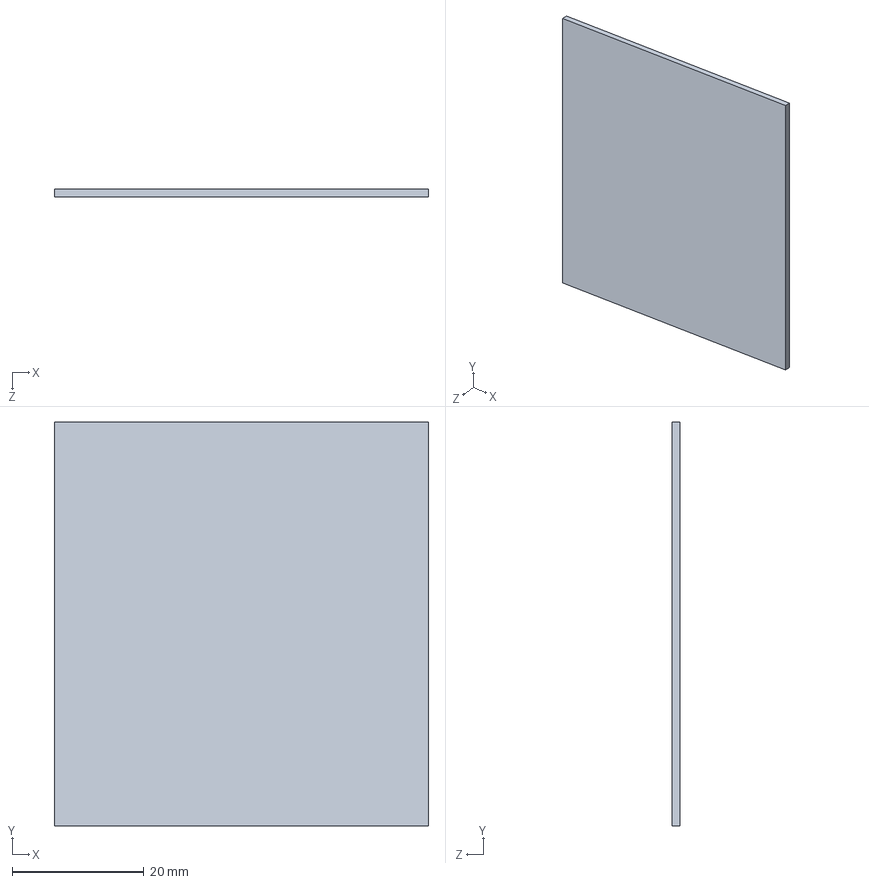
[picture p55: CAD file, 2025-08-19]
Walker_Main/Hardware/Hip_Device/Part Files for 3D Printing/heelPuck.SLDPRT
56.8 x 61.3 x 1.25 mm
