chobyeongjun/AR_Walker/Walker_Main/Hardware/Hip_Device/Part Files for 3D Printing/thighCuffBack.SLDPRT

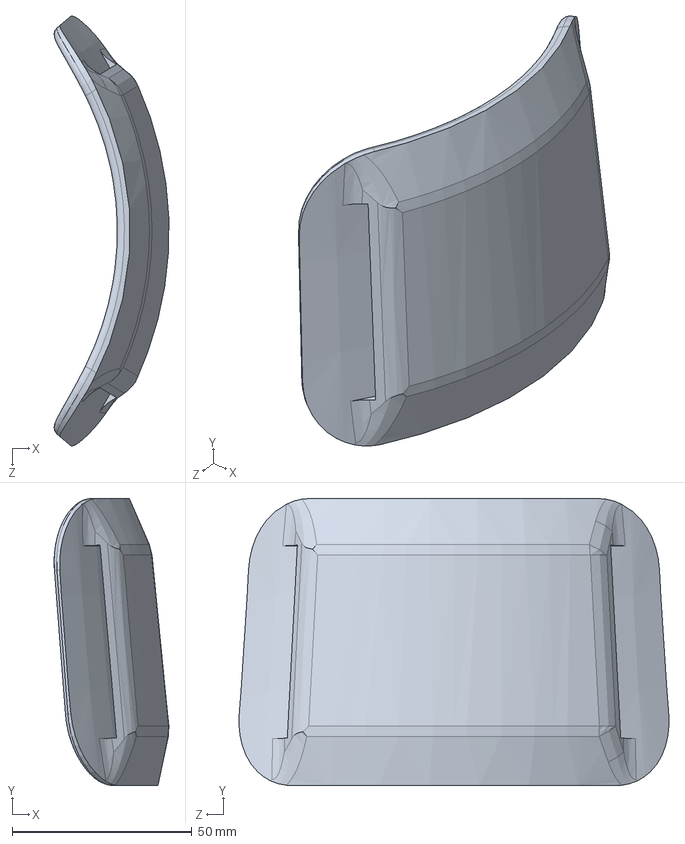
[picture p56: CAD file, 2025-08-19]
Walker_Main/Hardware/Hip_Device/Part Files for 3D Printing/thighCuffBack.SLDPRT
32.0 x 80.0 x 119.8 mm
