chobyeongjun/AR_Walker/(list of files, cad)

Other CAD files:
Walker_Main/Hardware/Bowden_Transmission/Parts/AK80/3D_Printed_Parts/Strain_Relief_Inserts_TPU.SLDPRT
Walker_Main/Hardware/Hip_Device/Part Files for Machining/CF Machining/thighCuffReinforcement.SLDPRT
Walker_Main/Hardware/Bowden_Transmission/Parts/AK70/3D_Printed_Parts/Strain_Relief_Inserts_TPU.SLDPRT
Walker_Main/Hardware/Bowden_Transmission/Parts/AK80/3D_Printed_Parts/Belt_to_Motor_Mount_AK80.SLDPRT
Walker_Main/Hardware/Hip_Device/Part Files for 3D Printing/holeTemplateForStrut.SLDPRT
Walker_Main/Hardware/Bowden_Transmission/Parts/AK70/3D_Printed_Parts/Strain_Relief_Shell_AK70.SLDPRT
Walker_Main/Hardware/Bowden_Transmission/Large_Cable/Universal Cable Chain Interface/UCCI.SLDDRW
Walker_Main/Hardware/Bowden_Transmission/Large_Cable/Universal Cable Chain Interface/UCCI.SLDPRT
Walker_Main/Hardware/Bowden_Transmission/Large_Cable/Universal Cable Chain Interface/UCCI.STL
Walker_Main/Hardware/Bowden_Transmission/Parts/AK60V1.1/3D_Printed_Parts/Back_Cover_AK60V1_1(1).SLDPRT
Walker_Main/Hardware/Bowden_Transmission/Parts/AK80/Fasteners/7804K143_Stainless Steel Ball Bearing.SLDPRT
Walker_Main/Hardware/Bowden_Transmission/Parts/AK80/Fasteners/90236A127_M3x35_1Zinc-Plated Alloy Steel Torx Flat Head Screws.SLDPRT
Walker_Main/Hardware/Bowden_Transmission/Parts/AK80/Fasteners/91290A117_M3x12_6Alloy Steel Socket Head Screw.SLDPRT
Walker_Main/Hardware/Bowden_Transmission/Parts/AK80/Fasteners/92095A179_M3x6_1Button Head Hex Drive Screw.SLDPRT
Walker_Main/Hardware/Bowden_Transmission/Parts/AK80/Fasteners/92095A181_M3x8_8Button Head Hex Drive Screw.SLDPRT
Walker_Main/Hardware/Bowden_Transmission/Parts/AK80/Fasteners/92095A189_M4x8_6Button Head Hex Drive Screw.SLDPRT
Walker_Main/Hardware/Bowden_Transmission/Parts/AK80/Fasteners/92334A109_M3_1Aluminum Washer.SLDPRT
Walker_Main/Hardware/Bowden_Transmission/Parts/AK80/Fasteners/97763A813_M3x8_218-8 Stainless Steel Button Head Hex Drive Screws.SLDPRT
Walker_Main/Hardware/Hip_Device/Part Files for 3D Printing/boltSupportForStrut.SLDPRT
