chobyeongjun/AR_Walker/Walker_Main/OpenExo_Publication_Data/Publication_Data/Engineering/Duration_Test_Results.xlsx

Sheet: Hip
Minute | Voltage | Left Temp | Right Temp | Average Temp [F] | Average Temp [C]
0 | 25 | 73.8 | 73.7 | 73.8 | 23.2
1 | 24.7 | 77.3 | 77.3 | 77.3 | 25.2
2 | 24.6 | 83.1 | 83.2 | 83.2 | 28.4
3 | 24.5 | 87 | 86.6 | 86.8 | 30.4
4 | 24.4 | 92.6 | 92 | 92.3 | 33.5
5 | 24.3 | 96.9 | 96.1 | 96.5 | 35.8
6 | 24.1 | 101.4 | 101.1 | 101.2 | 38.5
7 | 24.2 | 106.5 | 105.2 | 105.8 | 41.0
8 | 23.9 | 111.2 | 109.3 | 110.2 | 43.5
9 | 23.8 | 115.1 | 113.8 | 114.4 | 45.8
10 | 23.7 | 119.4 | 118.2 | 118.8 | 48.2
11 | 23.7 | 122.9 | 120.6 | 121.8 | 49.9
12 | 23.5 | 126.6 | 123.9 | 125.2 | 51.8
13 | 23.4 | 130.2 | 127.8 | 129.0 | 53.9
14 | 23.5 | 133.5 | 130.3 | 131.9 | 55.5
15 | 23.3 | 136.5 | 132.4 | 134.4 | 56.9
16 | 23.4 | 138.7 | 136.2 | 137.4 | 58.6
17 | 23.2 | 142.2 | 138.6 | 140.4 | 60.2
18 | 23.2 | 143.9 | 140.4 | 142.2 | 61.2
19 | 23.2 | 146.6 | 142.3 | 144.4 | 62.5
20 | 23.1 | 148.2 | 144.8 | 146.5 | 63.6
21 | 23 | 150.8 | 146.6 | 148.7 | 64.8
22 | 23 | 152.8 | 148.1 | 150.4 | 65.8
23 | 22.9 | 154.4 | 149.7 | 152.1 | 66.7
24 | 22.8 | 156.3 | 151.5 | 153.9 | 67.7
25 | 22.7 | 158.3 | 153.1 | 155.7 | 68.7
26 | 22.7 | 159.8 | 154.8 | 157.3 | 69.6
27 | 22.7 | 161.3 | 156 | 158.7 | 70.4
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
