chobyeongjun/AR_Walker/Walker_Main/OpenExo_Publication_Data/Publication_Data/Experimental/P1/Shod_Metabolic.xlsx

P1 | Test date | 10/31/2023 | Barometric Pressure (mmHg) | 599 | t | Rf | VT | VE | IV | VO2 | VCO2 | RQ | O2exp | CO2exp | VE/VO2 | VE/VCO2 | VO2/Kg | METS | FeO2 | FeCO2 | FetO2 | FetCO2 | FiO2 | FiCO2 | PeO2 | PeCO2 | PetO2 | PetCO2 | Phase | Marker | Amb. Temp. | RH Amb | Device Temp. | Analyz. Press. | PB | EEkc | EEh | EEm | EEtot | EEkg | PRO | FAT | CHO | PRO% | FAT% | CHO% | npRQ | Long | Lat | GPS Altitude | Barom_Altitude | GPS Speed | GPS Dist. | Ti | Te
Last Name | Test Time | 3:30 PM | Ambient Temperature (°C) | 20 | s | 1/min | L(btps) | L/min | mL | mL/min | mL/min | --- | mL | mL | --- | --- | mL/min/Kg | --- | % | % | % | % | % | % | mmHg | mmHg | mmHg | mmHg | --- | --- | °C | % | °C | mmHg | mmHg | kcal/day | kcal/h | kcal/min | kcal | kcal/Kg/day | kcal/day | kcal/day | kcal/day | % | % | % | --- | ° ' " | ° ' " | m | m | km/h | m | s | s
First Name | Test Duration | 0:13:50 | Ambient Relative Humidity (%) | 32
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
