chobyeongjun/AR_Walker/Walker_Main/OpenExo_Publication_Data/Publication_Data/Engineering/Ankle/RMSE/Walk_Test.xlsx

TStep | 1 | 2 | 3 | 4 | 5 | 6 | 7 | 8 | 9 | 10 | 11 | 12 | 13 | 14 | 15 | 16 | 17 | 18 | 19 | 20 | 21 | 22 | 23 | 24 | 25 | 26 | 27 | 28 | 29 | 30 | 31 | 32 | 33 | 34 | 35 | 36 | 37 | 38 | 39 | 40 | 41 | 42 | 43 | 44 | 45 | 46 | 47 | 48 | 49 | 50 | 51 | 52 | 53 | 54 | 55 | 56 | 57 | 58 | 59
RTorque | -3.3 | -4.13 | -1.05 | -0.18 | 0.18 | 0.23 | -0.4 | -0.4 | 0.05 | 0.27 | 0.31 | -0.1 | 0.14 | 0.31 | 0 | -0.37 | -1.1 | -2.23 | -0.44 | -0.01 | 0.43 | 0.52 | 0.18 | -0.23 | -0.44 | 0.18 | -0.18 | -0.05 | 0.1 | 0.18 | 0.18 | 0.05 | -0.15 | -0.15 | -0.15 | -0.15 | 0.1 | 0.69 | 1.91 | 1.22 | -0.37 | -1.14 | -1.58 | -0.62 | -0.54 | 0.23 | 0.4 | 0.1 | -0.05 | 0.1 | 0.1 | -0.01 | 0.18 | 0.4 | 0 | -0.97 | -0.88 | -0.1 | 0.23
RSetP | 0 | 0 | 0 | 0 | 0 | 0 | 0 | 0 | 0 | 0 | 0 | 0 | 0 | 0 | 0 | 0 | 0 | 0 | 0 | 0 | 0 | 0 | 0 | 0 | 0 | 0 | 0 | 0 | 0 | 0 | 0 | 0 | 0 | 0 | 0 | 0 | 0 | 0 | 0 | 0 | 0 | 0 | 0 | 0 | 0 | 0 | 0 | 0 | 0 | 0 | 0 | 0 | 0 | 0 | 0 | 0 | 0 | 0 | 0
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
