chobyeongjun/AR_Walker/Walker_Main/OpenExo_Publication_Data/Publication_Data/Experimental/P3/Outdoor/Exo_Metabolics.csv

# Type Time Date Duration Items First name Last name UUID
UUD
Test type
Test no.
Duration
Items
BTPS
BTPSE
STPD
uuid
GUID
Date
Time
Firstname
Lastname
SSNID
Birth date
Gender
Ethnicity
Height
Weight | 93
Notes
IDS | 62 | HR | K5_VE | K5_VO2 | K5_VCO2 | K5_R | VT | K5_Rf | IV | K5_FeO2 | K5_FeCO2 | Pan | FetO2 | FetCO2 | PB | ExpO2 | ExpCO2 | FiO2 | FiCO2 | Te | Ti | DevTempK4 | Item | hh:mm:ss | GpsAltK4 | LongHI | LongLO | LatHI | LatLO | BkSpd | BkCadCk | GpsExt | Battery | GpsSpeed | GpsSats | AmbTempK4 | Marker | BarAltK4 | RHAmb | O2Delay | CO2Delay | GpsHead | Info | StrdSp | StrdDist | StrdCad | BkWlCad | BkPowWl | BkTrqCk | BkTrqLe | BkTrqRi | StrCnt | RHSampl | THb1 | SmO21 | THb2 | SmO22 | THb3 | SmO23
DEC | 62 | 0 | 1 | 0 | 0 | 2 | 0 | 1 | 0 | 2 | 2 | 0 | 2 | 2 | 0 | 1 | 1 | 2 | 2 | 0 | 0 | 1 | 0 | 0 | 0 | 0 | 0 | 0 | 0 | 0 | 0 | 0 | 0 | 1 | 0 | 1 | 0 | 0 | 0 | 0 | 0 | 0 | 0 | 0 | 0 | 0 | 0 | 0 | 0 | 0 | 0 | 0 | 0 | 0 | 0 | 0 | 0 | 0 | 0
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
