chobyeongjun/AR_Walker/Walker_Main/OpenExo_Publication_Data/Publication_Data/Experimental/P3/Outdoor/Outdoor_Results.xlsx

 | Duration | Steps | Step Length | Walking Speed
Exo | 1035 | 1071 | 1.54 | 1.59
Shod | 1192 | 1167 | 1.41 | 1.38
 | -13 | -8 | 9 | 15
