chobyeongjun/AR_Walker/STM_Board/80 Journal/2026-04-20 Obsidian Migration.md

---
date: 2026-04-20
tags: [journal]
---

# 2026-04-20 — Obsidian 리팩토링

## 오늘 한 것

- Vault 구조를 Obsidian Second Brain 으로 전환
- 기존 단일 `PLAN.md` (~50KB) 를 atomic 노트 50+ 개로 분해
- MOC 6개 (Index, Project, Components, Concepts, Schematic Blocks, References, BOM)
- 템플릿 4개 (Component, Concept, Decision, Schematic Block)
- YAML frontmatter + tags + `[[wikilinks]]` 전면 적용
- [[STM32H723VGT6]] 확정

## 다음

- [[Phase Plan]] 의 **P1** 진행: [[Reference Index]] 의 데이터시트 수집
- [[70 KiCad]] 프로젝트 생성 (P2)
- [[Loadcell Amp]] sheet 부터 그리기 (P3A.3, 사용자 우선)

## 링크

- [[Exosuit Board MOC]]
- [[Open Questions]]
- [[Decisions Log]]

## 후속 (2026-04-20 오후)

- 통합 vault `~/research-vault/` 로 재구성 (옵션 C: symlink 통합)
- 이 프로젝트는 `Projects/Exosuit_Board/` symlink 로 이동
- `.obsidian/` 설정과 공용 템플릿은 vault 루트로 이동
- 자세한 것: `~/research-vault/Journal/2026-04-20.md`
