chobyeongjun/AR_Walker/Walker_Main/systemCheck/SyncLed/SyncLed.ino

#if defined(ARDUINO_TEENSY36) | defined(ARDUINO_TEENSY41)

  #include "src\Board.h"
  #include "src\SyncLed.h"
  
  void setup()
  {
    Serial.begin(115200);
    
  }
  
  void loop()
  {
    static SyncLed sync_led(logic_micro_pins::sync_led_pin, sync_time::SYNC_START_STOP_HALF_PERIOD_US, sync_time::SYNC_HALF_PERIOD_US, logic_micro_pins::sync_led_on_state, logic_micro_pins::sync_default_pin);  // Create a sync LED object, the first and last arguments (pin) are found in Board.h, and the rest are in Sync_Led.h.  If you do not have a digital input for the default state you can remove SYNC_DEFAULT_STATE_PIN.  
     
    int state_period_ms = 10000;
    static int last_transition_time = millis();
    int current_time = millis();
    static int trigger_count = 0;
    
    if (state_period_ms <= (current_time - last_transition_time))
    {
      trigger_count++;
      logger::println(trigger_count);
      sync_led.trigger();
      last_transition_time = current_time;
    }
    sync_led.handler();
  }


#endif
