chobyeongjun/AR_Walker/Main/main/src/MotorData.h

#ifndef MotorData_h
#define MotorData_h

#include "Arduino.h"

#include "ParseIni.h"
#include "Board.h"

#include <stdint.h>

// Forward declaration
class ExoData;

class MotorData
{
public: // ParseIni.h에 정의된 config_defs::joint_id enum class를 사용하여 MotorData 클래스의 생성자에서 motor_id를 초기화
    MotorData(config_defs::joint_id id, uint8_t *config_to_send);


    void reconfigure(uint8_t *config_to_send);

    config_defs::joint_id id; 
    uint8_t motor_type;       
    float p;                  
    float v;                  
    float i;                  
    float kt;                 
    int8_t temperature;       
    uint8_t error;            
    float p_des;              
    float v_des;              
    float a_des;              

    bool do_zero;        
    bool is_on;          
    bool is_left;        
    bool flip_direction; 
    float gearing;       

    // Timeout state
    int timeout_count;          /**< Number of timeouts in a row */
    int timeout_count_max = 40; /**< Number of timeouts in a row before the motor is disabled */

    // Real-time Maxon Motor Reset Feedback
    int maxon_plotting_scalar = 1;
};

#endif
