chobyeongjun/AR_Walker/Walker_Main/src/uart_commands.h

#ifndef UART_COMMANDS_H
#define UART_COMMANDS_H

#include "Arduino.h"
#include "UARTHandler.h"
#include "UART_msg_t.h"

#include "ParseIni.h"
#include "ExoData.h"
#include "JointData.h"
#include "ParamsFromSD.h"
#include "Logger.h"
#include "RealTimeI2C.h"


namespace UART_command_names
{
    /* Update_x must be get_x + 1 */
    static const uint8_t empty_msg = 0x00;
    static const uint8_t get_controller_params = 0x01;
    static const uint8_t update_controller_params = 0x02;
    static const uint8_t get_status = 0x03;
    static const uint8_t update_status = 0x04;
    static const uint8_t get_config = 0x05;
    static const uint8_t update_config = 0x06;

    static const uint8_t get_motor_enable_disable = 0x07;
    static const uint8_t update_motor_enable_disable = 0x08;

    static const uint8_t get_motor_zero = 0x09;
    static const uint8_t update_motor_zero = 0x0A;

    static const uint8_t get_real_time_data = 0x0B;
    static const uint8_t update_real_time_data = 0x0C;

    static const uint8_t get_controller_param = 0x0D;
    static const uint8_t update_controller_param = 0x0E;

    static const uint8_t get_error_code = 0x0F;
    static const uint8_t update_error_code = 0x10;

};


namespace UART_command_enums
{
    enum class controller_params : uint8_t
    {
        CONTROLLER_ID = 0,
        PARAM_LENGTH = 1,
        PARAM_START = 2,
        LENGTH
    };
    enum class status : uint8_t
    {
        STATUS = 0,
        LENGTH
    };

    enum class motor_enable_disable : uint8_t
    {
        ENABLE_DISABLE = 0,
        LENGTH
    };
    enum class motor_zero : uint8_t
    {
        ZERO = 0,
        LENGTH
    };
    enum class controller_param : uint8_t
    {
        CONTROLLER_ID = 0,
        PARAM_INDEX = 1,
        PARAM_VALUE = 2,
        LENGTH
    };
    enum class real_time_data : uint8_t
    {

    };

    enum class get_error_code : uint8_t
    {
        ERROR_CODE = 0,
        LENGTH
    };


};


namespace UART_command_handlers
{
    inline static void get_controller_params(UARTHandler *handler, ExoData *exo_data, UART_msg_t msg)  //  (정보 요청 처리 및 응답)
    {
         //logger::println("UART_command_handlers::update_controller_params->Fetching params with msg: ");
         //UART_msg_t_utils::print_msg(msg);

        JointData *j_data = exo_data->get_joint_with(msg.joint_id);                 // 수신된 msg.joint_id에 해당하는 JointData 객체를 가져옵니다.
        if (j_data == NULL)
        {
            //logger::println("UART_command_handlers::get_controller_params->No joint with id =  ");
            //logger::print(msg.joint_id);
            //logger::println(" found");
            return;
        }

        msg.command = UART_command_names::update_controller_params;                 // 이제 보낼 응답 메시지를 준비합니다. 메시지 종류(command)를 "파라미터 업데이트" 정보

        uint8_t param_length = j_data->controller.get_parameter_length();
        msg.len = param_length + (uint8_t)UART_command_enums::controller_params::LENGTH;
        msg.data[(uint8_t)UART_command_enums::controller_params::CONTROLLER_ID] = j_data->controller.controller; // 현재 컨트롤러의 ID를 msg.data 배열에 저장합니다.
        msg.data[(uint8_t)UART_command_enums::controller_params::PARAM_LENGTH] = param_length;  // 파라미터의 개수를 msg.data 배열에 저장합니다.
        for (int i = 0; i < param_length; i++)
        {
            msg.data[(uint8_t)UART_command_enums::controller_params::PARAM_START + i] = j_data->controller.parameters[i];       // 각 파라미터 값을 msg.data 배열에 저장합니다.
        }

        handler->UART_msg(msg);                                
    }
    inline static void update_controller_params(UARTHandler *handler, ExoData *exo_data, UART_msg_t msg)
    {
         logger::println("UART_command_handlers::update_controller_params->Got new params with msg: ");
         UART_msg_t_utils::print_msg(msg);

        JointData *j_data = exo_data->get_joint_with(msg.joint_id);
        if (j_data == NULL)
        {
            logger::println("UART_command_handlers::update_controller_params->No joint with id =  " + String(msg.joint_id) + " found");
            return;
        }

#if defined(ARDUINO_TEENSY36) || defined(ARDUINO_TEENSY41)
        j_data->controller.controller = (uint8_t)msg.data[(uint8_t)UART_command_enums::controller_params::CONTROLLER_ID];
        set_controller_params(msg.joint_id, (uint8_t)msg.data[(uint8_t)UART_command_enums::controller_params::CONTROLLER_ID], (uint8_t)msg.data[(uint8_t)UART_command_enums::controller_params::PARAM_START], exo_data);
        //Serial.println("Updating Controller Params: " + String(msg.joint_id) + ", " + String((uint8_t)msg.data[(uint8_t)UART_command_enums::controller_params::PARAM_START]) + ", " + String(j_data->controller.controller));
#endif
    }
    // 상태를 알기 위한 것들은 지금 내 상태를 보내는 거니까 tx_msg를 만들어서 보냄
    inline static void get_status(UARTHandler *handler, ExoData *exo_data, UART_msg_t msg)
    {

        UART_msg_t tx_msg;
        tx_msg.command = UART_command_names::update_status;
        tx_msg.joint_id = 0;
        tx_msg.len = (uint8_t)UART_command_enums::status::LENGTH;
        tx_msg.data[(uint8_t)UART_command_enums::status::STATUS] = exo_data->get_status();

        handler->UART_msg(tx_msg);
        // logger::println("UART_command_handlers::get_status->sent updated status");
    }

    inline static void update_status(UARTHandler *handler, ExoData *exo_data, UART_msg_t msg)
    {
        exo_data->set_status(msg.data[(uint8_t)UART_command_enums::status::STATUS]);
#if defined(ARDUINO_TEENSY36) || defined(ARDUINO_TEENSY41)
        if (msg.data[(uint8_t)UART_command_enums::status::STATUS] == status_defs::messages::trial_on)
        {
            //Set default parameters for each used joint
            exo_data->set_default_parameters();
        }
#endif
    }
    //  상태를 알기 위한 것들은 지금 내 상태를 보내는 거니까 tx_msg를 만들어서 보냄
    inline static void get_config(UARTHandler *handler, ExoData *exo_data, UART_msg_t msg)
    {
        UART_msg_t tx_msg;
        tx_msg.command = UART_command_names::update_config;             // 메시지의 종류를 update_config라고 지정
        tx_msg.joint_id = 0;
        tx_msg.len = ini_config::number_of_keys;

        //exo_data->config에 저장된 현재 시스템의 모든 설정 값들(보드 이름, 배터리 종류, 각 관절 설정 등)을 tx_msg.data 배열에 하나씩 복사하여 채워 넣습니다.
        tx_msg.data[config_defs::board_name_idx] = exo_data->config[config_defs::board_name_idx];
        tx_msg.data[config_defs::battery_idx] = exo_data->config[config_defs::battery_idx];
        tx_msg.data[config_defs::board_version_idx] = exo_data->config[config_defs::board_version_idx];
        tx_msg.data[config_defs::exo_name_idx] = exo_data->config[config_defs::exo_name_idx];
        tx_msg.data[config_defs::exo_side_idx] = exo_data->config[config_defs::exo_side_idx];
        tx_msg.data[config_defs::knee_idx] = exo_data->config[config_defs::knee_idx];
        tx_msg.data[config_defs::ankle_idx] = exo_data->config[config_defs::ankle_idx];
        tx_msg.data[config_defs::knee_gear_idx] = exo_data->config[config_defs::knee_gear_idx];
        tx_msg.data[config_defs::ankle_gear_idx] = exo_data->config[config_defs::ankle_gear_idx];
        tx_msg.data[config_defs::exo_knee_default_controller_idx] = exo_data->config[config_defs::exo_knee_default_controller_idx];
        tx_msg.data[config_defs::exo_ankle_default_controller_idx] = exo_data->config[config_defs::exo_ankle_default_controller_idx];
        tx_msg.data[config_defs::knee_use_Loadcell_idx] = exo_data->config[config_defs::knee_use_Loadcell_idx];
        tx_msg.data[config_defs::ankle_use_Loadcell_idx] = exo_data->config[config_defs::ankle_use_Loadcell_idx];
        tx_msg.data[config_defs::knee_use_IMU_idx] = exo_data->config[config_defs::knee_use_IMU_idx];
        tx_msg.data[config_defs::ankle_use_IMU_idx] = exo_data->config[config_defs::ankle_use_IMU_idx];


        //  완성된 메시지를 상대방에게 전송하는 함수 handler->UART_msg(tx_msg); // UARTHandler 클래스의 인스턴스를 사용하여 tx_msg를 전송합니다.
        handler->UART_msg(tx_msg);
        // logger::println("UART_command_handlers::get_config->sent updated config");
    }
 
    // 이 함수는 설정 정보를 받았을 때 호출됩니다.
    //  상대방으로부터 받은 설정 정보 메시지를 읽어서, 그 내용대로 현재 시스템의 설정을 업데이트하는 역할
    inline static void update_config(UARTHandler *handler, ExoData *exo_data, UART_msg_t msg)
    {
        // logger::println("UART_command_handlers::update_config->got message: ");
        UART_msg_t_utils::print_msg(msg); // UART 메시지(msg)의 내용을 개발자가 볼 수 있도록 시리얼 모니터에 출력(print)하는 디버깅용 함수
        exo_data->config[config_defs::board_name_idx] = msg.data[config_defs::board_name_idx];
        exo_data->config[config_defs::battery_idx] = msg.data[config_defs::battery_idx];
        exo_data->config[config_defs::board_version_idx] = msg.data[config_defs::board_version_idx];
        exo_data->config[config_defs::exo_name_idx] = msg.data[config_defs::exo_name_idx];
        exo_data->config[config_defs::exo_side_idx] = msg.data[config_defs::exo_side_idx];
        exo_data->config[config_defs::knee_idx] = msg.data[config_defs::knee_idx];
        exo_data->config[config_defs::ankle_idx] = msg.data[config_defs::ankle_idx];
        exo_data->config[config_defs::knee_gear_idx] = msg.data[config_defs::knee_gear_idx];
        exo_data->config[config_defs::ankle_gear_idx] = msg.data[config_defs::ankle_gear_idx];

        exo_data->config[config_defs::exo_knee_default_controller_idx] = msg.data[config_defs::exo_knee_default_controller_idx];
        exo_data->config[config_defs::exo_ankle_default_controller_idx] = msg.data[config_defs::exo_ankle_default_controller_idx];
        exo_data->config[config_defs::knee_use_Loadcell_idx] = msg.data[config_defs::knee_use_Loadcell_idx];
        exo_data->config[config_defs::ankle_use_Loadcell_idx] = msg.data[config_defs::ankle_use_Loadcell_idx];
        exo_data->config[config_defs::knee_use_IMU_idx] = msg.data[config_defs::knee_use_IMU_idx];
        exo_data->config[config_defs::ankle_use_IMU_idx] = msg.data[config_defs::ankle_use_IMU_idx];

    }

    inline static void get_motor_enable_disable(UARTHandler *handler, ExoData *exo_data, UART_msg_t msg)
    {
    }
    inline static void update_motor_enable_disable(UARTHandler *handler, ExoData *exo_data, UART_msg_t msg)
    {
        // logger::println("UART_command_handlers::update_motor_enable_disable->Got msg");
        exo_data->for_each_joint([](JointData *j_data, float *args)
                                 {if (j_data->is_used) j_data->motor.enabled = (bool)args[0]; },
                                 msg.data);
        exo_data->user_paused = !(bool)msg.data[0];
    }

    inline static void get_motor_zero(UARTHandler *handler, ExoData *exo_data, UART_msg_t msg)
    {
    }
    inline static void update_motor_zero(UARTHandler *handler, ExoData *exo_data, UART_msg_t msg)
    {
    }

    inline static void get_real_time_data(UARTHandler *handler, ExoData *exo_data, UART_msg_t msg, uint8_t *config)
    {
        UART_msg_t rx_msg;
        rx_msg.command = UART_command_names::update_real_time_data;
        rx_msg.joint_id = 0;
        rx_msg.len = (uint8_t)rt_data::BILATERAL_KNEE_RT_LEN; 

        // logger::println("config[config_defs::exo_name_idx] :: "); //Uncomment if you want to check that system is receiving correct config info
        // logger::println(config[config_defs::exo_name_idx]);

        //Plotting Guide [Mapping data value (o,1,2,etc.) to the color and tab of the Python GUI; Rule of Thumb: Even = Blue, Odd = Orange). 
        //Tab One
        //0 = Top Blue Line
        //1 = Top Orange Line
        //2 = Bottom Blue Line
        //3 = Bottom Orange Line
        
        //Tab 2
        //4 = Top Blue Line
        //5 = Top Orange Line
        //6 = Bottom Blue Line
        //7 = Bottom Orange Line
        
        //8 = Not Plotted, Will Save
        //9 = Not Plotted, Will Save

        //Note: Ankle and Hip are Configured for Step Controller, Elbow for the ElbowMinMax Controller, Multi-joint for their primary control schemes
        // rx_msg.data에 담기는 값들은 로봇의 현재 상태를 나타내는 핵심 센서 및 제어 값들
        switch (config[config_defs::exo_name_idx])
        {

        // 수정해야함.
        case (uint8_t)config_defs::exo_name::bilateral_knee:
            rx_msg.len = (uint8_t)rt_data::BILATERAL_KNEE_RT_LEN;
            rx_msg.data[0] = 0;            
            rx_msg.data[1] = 0;            
            rx_msg.data[2] = 0;
            rx_msg.data[3] = 0;
            rx_msg.data[4] = 0;
            rx_msg.data[5] = 0;
            rx_msg.data[6] = 0;
            rx_msg.data[7] = 0;
            rx_msg.data[8] = 0;
            rx_msg.data[9] = 0;
            break;
        case (uint8_t)config_defs::exo_name::bilateral_ankle:
            rx_msg.len = (uint8_t)rt_data::BILATERAL_ANKLE_RT_LEN;
            rx_msg.data[0] = 0;
            rx_msg.data[1] = 0;
            rx_msg.data[2] = 0;
            rx_msg.data[3] = 0;
            rx_msg.data[4] = 0;
            rx_msg.data[5] = 0;
            rx_msg.data[6] = 0;
            rx_msg.data[7] = 0;
            rx_msg.data[8] = 0;
            rx_msg.data[9] = 0;
            break;

        default:
            rx_msg.len = (uint8_t)rt_data::BILATERAL_KNEE_RT_LEN;
            rx_msg.data[0] = 0;
            rx_msg.data[1] = 0;
            rx_msg.data[2] = 0;
            rx_msg.data[3] = 0;
            rx_msg.data[4] = 0;
            rx_msg.data[5] = 0;
            rx_msg.data[6] = 0;
            rx_msg.data[7] = 0;
            rx_msg.data[8] = 0;
            rx_msg.data[9] = 0;
            break;
        }

        #if REAL_TIME_I2C
        real_time_i2c::msg(rx_msg.data, rx_msg.len);
        #else
        handler->UART_msg(rx_msg);
        #endif

        //Serial.print("RX_Message: ");
        //UART_msg_t_utils::print_msg(rx_msg);
        //Serial.print("\n");

         //logger::println("UART_command_handlers::get_real_time_data->sent real time data");   //Uncomment if you want to test to see what data is being sent
         //UART_msg_t_utils::print_msg(rx_msg);
    }

    //Overload for no config
    inline static void get_real_time_data(UARTHandler *handler, ExoData *exo_data, UART_msg_t msg)
    {
        uint8_t empty_config[ini_config::number_of_keys] = {0};
        get_real_time_data(handler, exo_data, msg, empty_config);
    }

    inline static void update_real_time_data(UARTHandler *handler, ExoData *exo_data, UART_msg_t msg)
    {
        // logger::println("UART_command_handlers::update_real_time_data->got message: ");
        // UART_msg_t_utils::print_msg(msg);
        #if REAL_TIME_I2C
                return;
        #endif
        if (rt_data::len != msg.len)
        {
            return;
        }
        for (int i = 0; i < rt_data::len; i++)
        {
            rt_data::float_values[i] = msg.data[i];
        }
        rt_data::new_rt_msg = true;
    }

    inline static void update_controller_param(UARTHandler *handler, ExoData *exo_data, UART_msg_t msg)
    {
        //Get the joint
        JointData *j_data = exo_data->get_joint_with(msg.joint_id);
        if (j_data == NULL)
        {
            //logger::println("UART_command_handlers::update_controller_param->No joint with id =  ");
            //logger::print(msg.joint_id);
            //logger::println(" found");
            return;
        }

        //Set the controller
        if (msg.data[(uint8_t)UART_command_enums::controller_params::CONTROLLER_ID] != j_data->controller.controller)
        {
            j_data->controller.controller = (uint8_t)msg.data[(uint8_t)UART_command_enums::controller_params::CONTROLLER_ID];
            exo_data->set_default_parameters((uint8_t)j_data->id);
        }

        //Set the parameter
        j_data->controller.parameters[(uint8_t)msg.data[(uint8_t)UART_command_enums::controller_param::PARAM_INDEX]] = msg.data[(uint8_t)UART_command_enums::controller_param::PARAM_VALUE];
        // Serial.println("Updating Controller Params: " + String(msg.joint_id) + ", "
        // + String((uint8_t)msg.data[(uint8_t)UART_command_enums::controller_param::CONTROLLER_ID]) + ", "
        // + String((uint8_t)msg.data[(uint8_t)UART_command_enums::controller_param::PARAM_INDEX]) + ", "
        // + String((uint8_t)msg.data[(uint8_t)UART_command_enums::controller_param::PARAM_VALUE]) + ", ");
    }

    inline static void update_error_code(UARTHandler *handler, ExoData *exo_data, UART_msg_t msg)
    {
        //logger::println("UART_command_handlers::update_error_code->got message: ");
        //UART_msg_t_utils::print_msg(msg);
        
        //Set the error code
        exo_data->error_code = msg.data[(uint8_t)UART_command_enums::get_error_code::ERROR_CODE];
        exo_data->error_joint_id = msg.joint_id;
    }
    // msg : 다른 장치로부터 받은 에러 정보가 담긴 msg
    inline static void get_error_code(UARTHandler *handler, ExoData *exo_data, UART_msg_t msg)
    {
        logger::print("Sending error: ", LogLevel::Error);
        logger::print(msg.joint_id, LogLevel::Error);
        logger::print(", ", LogLevel::Error);
        logger::println(msg.data[0], LogLevel::Error);

        // 받은 msg의 내용을 그대로 복사한 tx_msg 를 만들어서 상대방에게 전송
        UART_msg_t tx_msg;
        tx_msg.command = UART_command_names::update_error_code;
        tx_msg.joint_id = msg.joint_id;
        tx_msg.len = 1;
        tx_msg.data[(uint8_t)UART_command_enums::get_error_code::ERROR_CODE] = msg.data[(uint8_t)UART_command_enums::get_error_code::ERROR_CODE];
        handler->UART_msg(tx_msg);
    }

    
};

namespace UART_command_utils
{      

    static UART_msg_t call_and_response(UARTHandler *handler, UART_msg_t msg, float timeout)
    {
        UART_msg_t rx_msg = {0, 0, 0, 0};
        uint8_t searching = 1;
        // logger::println("UART_command_utils::call_and_response->searching for message");
        float start_time = millis();
        while (searching)   // searching은 while 반복문을 계속 실행할지, 아니면 멈출지를 결정하는 스위치 역할의 변수
        {
            handler->UART_msg(msg); // msg는 **전송(TX)**됩니다. 즉, "이런 요청을 보낼 테니 응답해 줘"라고 상대방에게 보내는 **'요청 편지'**
            // logger::println("UART_command_utils::call_and_response->sent msg");
            delay(500);
            rx_msg = handler->poll(200000);
            searching = (rx_msg.command != (msg.command + 1));  //  수신된 응답 메시지의 명령어 ID(rx_msg.command)가 내가 보낸 요청 메시지의 ID(msg.command)에 1을 더한 값과 같은지 확인
            // 요청(Call) 메시지의 명령어 ID가 X 라면, 그 요청에 대한 응답(Response) 메시지의 명령어 ID는 반드시 X + 1 이어야 한다.
            if (millis() - start_time > timeout)
            {
                // logger::println("UART_command_utils::call_and_response->timed out");
                return rx_msg;
            }
        }
        // logger::println("UART_command_utils::call_and_response->found message:");
        UART_msg_t_utils::print_msg(rx_msg);
        return rx_msg;
    }

    static uint8_t get_config(UARTHandler *handler, uint8_t *config, float timeout)
    {
        UART_msg_t msg;
        float start_time = millis();
        while (1)
        {
            msg.command = UART_command_names::get_config;
            msg.len = 0;
            msg = call_and_response(handler, msg, timeout);

            if ((millis() - start_time) > timeout)
            {
                logger::println("UART_command_utils::get_config->timed out");
                return 1;
            }

            //The length of the message needs to be equal to the config length
            if (msg.len != ini_config::number_of_keys)
            {
                logger::println("UART_command_utils::get_config->msg.len != number_of_keys");
                //Keep trying to get config
                continue;
            }
            for (int i = 0; i < msg.len; i++)
            {
                //A valid config will not contain a zero
                if (!msg.data[i])
                {
                    logger::print("UART_command_utils::get_config->Config contained a zero at index ");
                    logger::println(i);

                    //Keep trying to get config
                    continue;
                }
            }
            logger::println("UART_command_utils::get_config->got good config");
            break;
        }

        //Pack config
        for (int i = 0; i < msg.len; i++)
        {
            config[i] = msg.data[i];
        }
        return 0;
    }

    static void wait_for_get_config(UARTHandler *handler, ExoData *data, float timeout)
    {
        UART_msg_t rx_msg;
        float start_time = millis();
        while (true)
        {
            logger::println("UART_command_utils::wait_for_config->Polling for config");
            rx_msg = handler->poll(100000);
            if (rx_msg.command == UART_command_names::get_config)
            {
                logger::println("UART_command_utils::wait_for_config->Got config request");
                UART_command_handlers::get_config(handler, data, rx_msg);
                break;
            }
            delayMicroseconds(500);

            if ((millis() - start_time) > timeout)
            {
                logger::println("UART_command_utils::wait_for_config->Timed out");
                return;
            }
        }
        logger::println("UART_command_utils::wait_for_config->Sent config");
    }

    static void handle_msg(UARTHandler *handler, ExoData *exo_data, UART_msg_t msg)
    {
        if (msg.command == UART_command_names::empty_msg)
        {
            return;
        }

        //logger::println("UART_command_utils::handle_message->got message: ");
        //UART_msg_t_utils::print_msg(msg);

        switch (msg.command)
        {
        case UART_command_names::empty_msg:
            //logger::println("UART_command_utils::handle_message->Empty Message!");
            break;

        case UART_command_names::get_controller_params:
            UART_command_handlers::get_controller_params(handler, exo_data, msg);
            break;
        case UART_command_names::update_controller_params:
            UART_command_handlers::update_controller_params(handler, exo_data, msg);
            break;
        case UART_command_names::get_status:
            UART_command_handlers::get_status(handler, exo_data, msg);
            break;
        case UART_command_names::update_status:
            UART_command_handlers::update_status(handler, exo_data, msg);
            break;

        case UART_command_names::get_config:
            UART_command_handlers::get_config(handler, exo_data, msg);
            break;
        case UART_command_names::update_config:
            UART_command_handlers::update_config(handler, exo_data, msg);
            break;

        case UART_command_names::get_motor_enable_disable:
            UART_command_handlers::get_motor_enable_disable(handler, exo_data, msg);
            break;
        case UART_command_names::update_motor_enable_disable:
            UART_command_handlers::update_motor_enable_disable(handler, exo_data, msg);
            break;

        case UART_command_names::get_motor_zero:
            UART_command_handlers::get_motor_zero(handler, exo_data, msg);
            break;
        case UART_command_names::update_motor_zero:
            UART_command_handlers::update_motor_zero(handler, exo_data, msg);
            break;

        case UART_command_names::get_real_time_data:
            UART_command_handlers::get_real_time_data(handler, exo_data, msg);
            break;
        case UART_command_names::update_real_time_data:
            UART_command_handlers::update_real_time_data(handler, exo_data, msg);
            break;

        case UART_command_names::update_controller_param:
            UART_command_handlers::update_controller_param(handler, exo_data, msg);
            break;

        case UART_command_names::get_error_code:
            UART_command_handlers::get_error_code(handler, exo_data, msg);
            break;
        case UART_command_names::update_error_code:
            UART_command_handlers::update_error_code(handler, exo_data, msg);
            break;

        default:
            logger::println("UART_command_utils::handle_message->Unknown Message!", LogLevel::Error);
            UART_msg_t_utils::print_msg(msg);
            break;
        }
    }
};

#endif
