chobyeongjun/AR_Walker/Main/main/src/JointData.cpp

#include "JointData.h"
#include "Logger.h"

// 생성자 시그니처 수정 및 초기화 리스트 추가
JointData::JointData(config_defs::joint_id id, uint8_t *config_to_send)
    : motor(id, config_to_send), controller(id, config_to_send)
{
    this->id = id;
    this->is_left = ((uint8_t)this->id & (uint8_t)config_defs::joint_id::left) == (uint8_t)config_defs::joint_id::left;
    this->position = 0;
    this->velocity = 0;

    this->loadcell_reading = 0;
    this->imu_pitch = 0;
    this->imu_gyro_y = 0;
    this->imu_battery = 100; // IMU 배터리 초기값 100%
    this->imu_time_error_detected = false; // IMU 시간 오류 플래그 초기화
    
    // Emergency/Error 브레이크 초기화
    this->brake_requested = false;
    this->brake_current = 0.0f;

    // is_used 플래그 설정
    switch ((uint8_t)this->id & (~(uint8_t)config_defs::joint_id::left & ~(uint8_t)config_defs::joint_id::right))
    {
    case (uint8_t)config_defs::joint_id::knee:
    {
        // Check if joint and side is used
        is_used = (config_to_send[config_defs::knee_idx] != (uint8_t)config_defs::motor::not_used) && ((static_cast<uint8_t>(config_defs::exo_side::bilateral) == config_to_send[config_defs::exo_side_idx]) || (((uint8_t)config_defs::exo_side::left == config_to_send[config_defs::exo_side_idx]) && this->is_left) || (((uint8_t)config_defs::exo_side::right == config_to_send[config_defs::exo_side_idx]) && !this->is_left));

        break;
    }
    case (uint8_t)config_defs::joint_id::ankle:
    {
        // Check if joint and side is used
        is_used = (config_to_send[config_defs::ankle_idx] != (uint8_t)config_defs::motor::not_used) && ((static_cast<uint8_t>(config_defs::exo_side::bilateral) == config_to_send[config_defs::exo_side_idx]) || (((uint8_t)config_defs::exo_side::left == config_to_send[config_defs::exo_side_idx]) && this->is_left) || (((uint8_t)config_defs::exo_side::right == config_to_send[config_defs::exo_side_idx]) && !this->is_left));

        break;
    }
    }
};

// reconfigure 메서드 시그니처 수정 및 로직 추가
void JointData::reconfigure(uint8_t *config_to_send)
{

    switch ((uint8_t)this->id & (~(uint8_t)config_defs::joint_id::left & ~(uint8_t)config_defs::joint_id::right))
    {
    case (uint8_t)config_defs::joint_id::knee:
    {
        is_used = (config_to_send[config_defs::knee_idx] != (uint8_t)config_defs::motor::not_used) && ((static_cast<uint8_t>(config_defs::exo_side::bilateral) == config_to_send[config_defs::exo_side_idx]) || (((uint8_t)config_defs::exo_side::left == config_to_send[config_defs::exo_side_idx]) && this->is_left) || (((uint8_t)config_defs::exo_side::right == config_to_send[config_defs::exo_side_idx]) && !this->is_left));
        break;
    }
    case (uint8_t)config_defs::joint_id::ankle:
    {
        is_used = (config_to_send[config_defs::ankle_idx] != (uint8_t)config_defs::motor::not_used) && ((static_cast<uint8_t>(config_defs::exo_side::bilateral) == config_to_send[config_defs::exo_side_idx]) || (((uint8_t)config_defs::exo_side::left == config_to_send[config_defs::exo_side_idx]) && this->is_left) || (((uint8_t)config_defs::exo_side::right == config_to_send[config_defs::exo_side_idx]) && !this->is_left));
        break;
    }
    }

    // Reconfigure the contained objects
    motor.reconfigure(config_to_send);
    controller.reconfigure(config_to_send);
};
