chobyeongjun/AR_Walker/Main/main/src/ErrorManager.h

#ifndef ERROR_MANAGER_H
#define ERROR_MANAGER_H
#if defined(ARDUINO_TEENSY36) || defined(ARDUINO_TEENSY41)

#include "error_types.h"
#include "error_codes.h"
#include "error_map.h"
#include <queue>

class ErrorManager
{
public:
    ErrorManager() {};

    bool run(JointData *_data, ExoData *exo_data)  // ExoData 접근을 위한 매개변수 추가
    {
        // Check for errors
        for (int i_error = (NO_ERROR + 1); i_error != ERROR_CODE_LENGTH; i_error++)
        {
            // Current error code
            ErrorCodes error_code = static_cast<ErrorCodes>(i_error); // ErrorCodes 가 MOTOR_ERROR 등으로 되어있음

            // Get error type
            ErrorType *error = error_map.at(error_code);

            // Check for error
            if (error->check(_data, exo_data))
            {
                error->handle(_data, exo_data);
                this->_pushError(error_code);
            }
        }

        return static_cast<bool>(this->errorQueueSize());
    }

 
    int errorQueueSize()
    {
        return this->_error_queue.size();
    }

    ErrorCodes popError()
    {
        ErrorCodes error_code = this->_error_queue.front(); // front() : 맨 앞의 요소를 확인
        this->_error_queue.pop();                           // pop() : 맨 앞의 요소를 제거
        return error_code;
    }

private:
    std::queue<ErrorCodes> _error_queue; // _error_queue를 만들건데, ErrorCodes 타입만 담을 거고, 에러 코드들을 순서대로 저장하는 큐(queue) 자료구조

    void _pushError(ErrorCodes error_code)
    {
        this->_error_queue.push(error_code);
    }
};

#endif
#endif // ERROR_MANAGER_H
