chobyeongjun/AR_Walker/(commit log)

2025-09-04 Update MediWalker system with comprehensive admittance control and system improvements
    - Consolidate admittance control testing into unified AdmittanceTest system
    - Add real-time parameter control with serial commands (m,c,s format)
    - Integrate loadcell calibration values from LoadcellTest system
    - Implement SD card logging with Timer, Actual Force, Ref Force, M/D/K, Error%
    - Add configurable force generation patterns (half-sine and step functions)
    - Optimize control frequency to 500Hz matching main system
    - Enhance swing/stance control logic with safety mechanisms
    - Add Battery monitoring and error management improvements
    - Update Python GUI with new interface elements and functionality
    - I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
    [2025-Aug-29-18-33-43.csv, 2025-Aug-29-18-36-15.csv, PHMC.csv, PJMC.csv, chirp.csv, constantTorque.csv, elbowMinMax.csv, franksCollinsHip.csv]
2026-04-17 Add STM_Board design plan, BOM v0, decisions log, and folder skeleton
    Initial scaffolding for the cable-driven exosuit STM32 board:
    - PLAN.md with block diagram, MCU candidates, phase plan
    - BOM_v0.csv with first-pass component list (motor parts deferred)
    - decisions.md to track design choices over time
    - kicad/, refs/, schematic_blocks/ folders prepared for next phases
    https://claude.ai/code/session_01Rte5TeYFxuy6vzeX3PVFzG
    [BOM_v0.csv]
2026-04-18 Update STM_Board plan to v2.2: H7, EBIMU, ADS131M04, DMA, BLE, Jetson pose downlink
    - MCU: switch to STM32H723ZGT6 (550MHz M7, USB HS internal PHY, more RAM)
    - Loadcell: HX711 -> ADS131M04 (24bit, 32kSPS, 4ch simultaneous)
    - IMU: drop onboard chip, route EBIMU wireless receiver UART to MCU
    - Logging: onboard microSD via SDMMC 4-bit
    - CAN: single bus, EtherCAT removed (per user)
    - Wireless control: add ESP32-C3-MINI-1 (BLE 5.0 + WiFi) on UART
    - DMA: explicit mapping table for all high-throughput peripherals
    - Jetson: model camera->pose downlink (~50KB/s, <20ms latency target),
    recommend high-speed UART + dedicated HW SYNC GPIO as primary link
    - Add link health watchdog (motor enable cut on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
    [BOM_v1.csv]
2026-04-18 Add compact form-factor constraints and downsize part choices
    - Target board size: 50x50mm 4-layer (safe) / 45x40mm 6-layer (aggressive)
    - MCU recommendation: STM32H723VGT6 LQFP100 (14x14, ~50% area vs Z144)
    - Buck: TPS54360 -> TPS62933 (2.5MHz, smaller inductor and caps)
    - All wire connectors standardized to JST-GH 1.25mm (drop XH/screw terminals)
    - Ethernet PHY+RJ45 marked REMOVED (340mm^2 saving, conditional on user)
    - Add size budget table per block (~1500mm^2 components, ~2300mm^2 with routing)
    - Update decisions log with compact-related choices
    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
    [BOM_v1.csv]
2026-04-18 Confirm key decisions (v2.4): MCU, antenna, USB-C, E-stop, drop Ethernet
    User feedback this round:
    - MCU: present comparison table, recommend STM32H723VGT6 (LQFP100, 14x14)
    - rationale: compact + USB HS internal PHY + sufficient perf, vs LQFP144/BGA/H743V
    - Jetson SYNC: explain WHY HW sync line is needed (data-age problem,
    pose timestamp alignment with control loop), keep SYNC_OUT/SYNC_IN GPIO
    - USB-C debug/DFU port: keep, place at board edge (80mm^2 cost worth it)
    - Ethernet: removed entirely (was already de-prioritized)
    - ESP32 antenna: switch to ESP32-C3-MINI-1U (IPEX external antenna)
    - rationale: wearable case/clothing blocks PCB antenna, IPEX more stable
    - E-stop: dual-safety cir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
    [BOM_v1.csv]
2026-04-18 Expand MCU detailed comparison + redesign power for motor pass-through (v2.5)
    User asked for deeper MCU pros/cons and confirmed motor power flows through board.
    MCU comparison (PLAN section 2):
    - Side-by-side detailed table: H723VGT6 / H723ZGT6 / H743VIT6 / H723VGH6
    - Per-chip prose pros/cons covering package size, soldering difficulty,
    rework, RAM/Flash layout, USB HS PHY, Ethernet, peripherals,
    power consumption, price, ST HAL maturity, Nucleo availability
    - Reaffirms STM32H723VGT6 (LQFP100) as 1st pick
    Power redesign (motor pass-through):
    - DC input: JST-GH -> XT30PW (15A continuous)
    - Two motor output XT30PW connectors
    - Reverse polarity: P-MOSFET -> LTC4359 + N-MOSFET (high curren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
    [BOM_v1.csv]
2026-04-18 v2.6: BGA reframe, eFuse deep-dive (LTC4368), scale power for 15A+ motors
    User clarifications:
    - Outsources PCBA, asks if BGA performance penalty exists
    - Wants detailed eFuse explanation
    - Motor draws 15A+ continuous (each)
    BGA reframe (PLAN section 2):
    - Performance: 100% identical to LQFP (same silicon, same specs)
    - Real costs even with outsourced assembly:
    HDI/microvia PCB +$30-60, BGA SMT +$5-15, X-ray inspection
    ~$50-100/board total premium
    - Probe access lost (debug hard), rework essentially impossible
    - Our board size is constrained by microSD/ESP32/connectors, not MCU
    - Recommendation: still LQFP100 even with assembly house
    eFuse deep-dive (PLAN section 3-1A):
    - Replaces fuse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
    [BOM_v1.csv]
2026-04-18 v2.7: switch to 6-layer 50x50mm compact (8L 45x45 option) per user feedback
    User request: prefer more layers if it shrinks the board, prioritize
    performance and safety.
    PCB stackup redesign (PLAN section 4-11):
    - Move from 4-layer 60x60mm to 6-layer 50x50mm with double-side population
    - Stackup: SIG / GND / SIG_PWR / PWR / GND / SIG
    - Every signal layer adjacent to a GND plane (SI + EMI)
    - Two GND planes for star-ground motor / logic separation
    - Dedicated PWR plane for 3.3V/5V distribution
    - Outer 2oz copper for 30A motor traces
    - Inner 1oz, ENIG finish, via-in-pad, 4/4 mil minimum
    - 8-layer 45x45mm option for ultra-compact (motor power on dual planes)
    Performance / safety wins quan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
    [BOM_v1.csv]
2026-04-18 v2.8: add battery state-of-charge monitoring (INA228 + coulomb counting)
    User: "battery level should be checked too" - confirm INA228 inclusion
    and design full SoC estimation pipeline.
    - Replace INA226 (36V max) with INA228 (85V max) - covers 24/36/48V packs
    - Add 1mOhm 2W shunt (Susumu CSS2H, 2512) on input rail
    - Add JST-GH 2pin connector for external battery NTC + pull-up
    - Firmware SoC algorithm:
    - Boot: open-circuit voltage -> initial SoC via Li-ion OCV curve
    - Runtime: coulomb counting via INA228 CHARGE register
    - Periodic OCV recalibration
    - Reporting channels: RGB LED color, ESP32 BLE app, SD log, Jetson telemetry
    - Auto-safety: SoC < 20% warn, SoC < 5% (or UVLO) -> motor enab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
    [BOM_v1.csv]
2026-04-18 v2.9: modular Phase A (logic, freeze now) / Phase B (motor-dependent, defer)
    User insight: motor and voltage decisions only affect the high-current
    power section; logic/sensors/comms always run on 5V/3.3V regardless.
    So freeze logic-side schematics now and defer only the motor power block.
    Restructure plan:
    - Add section 4-0 "Modular design strategy" listing every block as
    motor-independent (Phase A) or motor-dependent (Phase B)
    - Phase A includes loadcell amp (ADS131M04), MCU, sensors, comms,
    wireless, USB-C, microSD, E-stop, battery monitor, logic LDOs, buck
    topology
    - Phase B is just: DC input connector, eFuse MOSFET sizing, motor output
    connectors, bulk cap voltage rating, choke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
2026-04-18 Clarify voltage dependency: INA228 stays universal, list voltage-sensitive parts
    User noted motor voltage may end up lower than 24-48V range.
    INA228 (0-85V) covers any voltage decision - keep as-is, no change needed.
    Same for TPS62933 buck (60V max) and LTC4368 eFuse (80V max).
    Add voltage-dependency matrix in PLAN section 4-0:
    - Voltage-dependent parts (Phase B): bulk cap V rating, TVS clamp,
    MOSFET V_DS, motor power polygon
    - Voltage-independent parts (Phase A): MCU, ADC, LDO, INA228, eFuse IC,
    buck topology, all logic-side circuitry
    Note current scaling: lower voltage at same power = higher current,
    so 15A motor spec interpretation (current vs power-based) matters for
    connector and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
2026-04-20 v3.0: full reset - migrate to Obsidian Second Brain vault
    User asked to redo setup from scratch and integrate Obsidian for a PKM /
    Second Brain workflow. CubeMX chip choice delegated -> STM32H723VGT6
    confirmed.
    Structural changes:
    - Delete single monolithic PLAN.md (~50KB) and old flat layout
    (docs/, parts/, refs/, schematic_blocks/, kicad/)
    - New numbered folder structure optimized for Obsidian sort order:
    00 Index.md (root MOC)
    10 Project/ -- goals, plan, decisions, open Qs, size, strategy
    20 Components/ -- atomic note per IC/part (14 notes)
    30 Concepts/ -- reusable engineering concepts (10 notes)
    40 Schematic Blocks/ -- per-sheet work notes (11 notes)
    50 Refe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
    [BOM_v0.csv, BOM_v1.csv, BOM_v2.csv]
2026-04-20 v3.1: demote STM_Board to project module under unified research-vault
    User chose option C: single Obsidian vault at ~/research-vault with
    projects symlinked in. "Physical storage distributed, knowledge
    unified" - keeps each project under its own git repo while exposing
    everything in one knowledge graph.
    Changes to STM_Board (this repo):
    - Remove .obsidian/ config (vault root now at ~/research-vault)
    - Remove global templates (Component, Concept, Decision) - moved to
    ~/research-vault/Templates/
    - Keep project-specific template (Schematic Block)
    - Rename 00 Index.md -> Exosuit Board MOC.md to avoid collision with
    vault root 00 Index
    - Update Exosuit Board MOC content to link up to parent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
2026-04-20 v3.2: align project notes to user's existing research-vault structure
    User has existing vault at ~/research-vault with layout:
    00_Raw/ 10_Wiki/ 20_Meta/ templates/
    <project-1-kebab>/ <project-2-kebab>/
    My previous attempt invented Areas/Projects/Resources PARA layout that
    didn't match. Rollback:
    - Remove [[Projects MOC]], [[Areas MOC]], [[00 Index]] references from
    Exosuit Board MOC.md - those MOCs don't exist in user's vault
    - Restore project-local Component/Concept/Decision templates (were
    removed in v3.1 under wrong assumption that global ones exist). Now
    they live in both places so the project is self-contained AND the
    user can copy/merge them into ~/research-vaul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
2026-04-20 v3.3: change symlink name from exosuit-board to stm-board
    User preference. Updates references in Exosuit Board MOC.md and
    README.md so the documented integration command reads:
    ln -s ~/AR_Walker/STM_Board ~/research-vault/stm-board
    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
2026-04-20 v3.4: point integration docs at ~/stm_board instead of ~/AR_Walker/STM_Board
    User prefers daily editing via ~/stm_board (legacy symlink created in
    session 1). Update the symlink command and path tables to reflect that:
    ln -s ~/stm_board ~/research-vault/stm-board
    So the three equivalent paths are:
    ~/stm_board/ -- daily work (terminal, editor)
    ~/research-vault/stm-board/ -- Obsidian vault access
    ~/AR_Walker/STM_Board/ -- git repo canonical
    All three resolve to the same files via symlinks; edits at any path
    are tracked by the AR_Walker git repo.
    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
2026-04-20 v3.5 Commit A: MCU migration (H723->H743) + CAN isolation (TCAN1462->ISO1050)
    Legacy docs discovered at ~/stm_board (2026-04-12~14) contained decisions
    already validated by 4-agent review. This commit reconciles my atomic
    notes with those prior decisions.
    Key changes:
    - STM32H723VGT6 -> STM32H743VIT6
    - H743 has 2MB Flash / 1MB RAM / dual-bank (vs H723 1MB/564KB/single)
    - H723's only advantage (internal USB HS PHY) is moot for us (USB FS
    sufficient for debug/DFU)
    - Nucleo-H743ZI enables parallel firmware dev
    - H743 HAL is more mature (2017 vs 2020)
    - Delete 20 Components/STM32H723VGT6.md
    - Add 20 Components/STM32H743VIT6.md with legacy C4/C5/W2/W4/W6/W7 fixes
    documented (VCAP_2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
2026-04-20 v3.5 Commit B: motor power protection architecture (regen/brake/inrush)
    Legacy board (2026-04-12~14) died from regen energy surge and GND
    bounce. That work documented a comprehensive protection architecture
    (EXOSUIT_PROTECTION.md) that was missing from my atomic notes. This
    commit imports all of it.
    New concept notes (3):
    - Regen Energy Protection
    4-motor simultaneous release = 1J. Without 9,615uF+ bulk + TVS +
    brake circuit, V_peak = 143V (bulk 100uF only) - prior board dead.
    Solution: 11,280uF bulk (Rubycon 35ZLH4700M x2 + 470uF x4 per motor),
    P6KE33CA x2 parallel (37.8V clamp), + brake circuit (below).
    - Brake Resistor Circuit
    Active energy dissipation above 26.5V thr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
2026-04-20 v3.5 Commit C: system specs + 2x INA228 + Goals/Block Diagram + BOM v3
    Completes the v3.5 legacy reconciliation by documenting the system-level
    components that weren't in my original atomic notes, and refreshing the
    top-level project documents.
    New component notes (3 - system level, not on board):
    - EBIMU EBMotion V5 (E2BOX 2.4GHz wireless IMU, 1000Hz, Quaternion,
    receiver UART 5V)
    - ZED X Mini (Stereolabs stereo camera, GMSL2, IP67, 150g, 120fps,
    connects to Jetson not MCU)
    - Jetson Orin NX 16GB (157 TOPS, ZED Link PCIe for camera, UART+SYNC
    to MCU)
    Updated component:
    - INA228: now qty 2 (pack 1 + pack 2 monitoring for 24V series). I2C
    addressing 0x40 / 0x41. DNP on pack 2 when ru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
    [BOM_v3.csv]
2026-04-20 v3.6: comprehensive datasheet index + download script (confirmed parts)
    Collect datasheets for all v3.5-confirmed components. Motor, motor
    driver, and specific battery model are excluded (still Phase B).
    Coverage (17 categories):
    01 MCU STM32H743, AN5436, AN2867, Nucleo-H743ZI
    02 ADC / Loadcell ADS131M04, REF5025, EVM, SBAA532
    03 Encoder AS5048A
    04 CAN Isolation ISO1050, MGJ2D05050SC, PRTR5V0U2X, SM712, BZT52C5V6
    05 USB Debug TPD4S012, USB-C GCT
    06 Battery Monitor INA228 (x2)
    07 Logic Power TPS62933, AP63205WU, TLV75533, BLM18PG601, XAL4040
    08 Reverse Protection DMP2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
2026-04-20 v3.7: add Citations & Sources transparency doc
    User accountability request: "make sure citations are correct and
    TI library references are all noted".
    Create 10 Project/Citations & Sources.md documenting:
    - Primary sources used in this project:
    - Legacy docs (5 files in _legacy/) - source of truth for reviewed
    values, CRITICAL/WARNING list, protection architecture numbers
    - ST documentation: STM32H743xx datasheet (DS12110), RM0433,
    AN5436 (HW checklist), AN2867 (oscillator), AN4879 (USB),
    AN5200 (SDMMC), Nucleo-H743ZI UM1974
    - TI datasheets + app notes with doc numbers (SBAS950, SBAA532,
    SBAU329, SBOS410, SLLS983, SBOS882, SBVS244, SLVSGL7, SLLSEQ6,
    SBOS550)
    - O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
2026-04-20 v3.8: add Unsourced Items Audit - user directive "no personal opinions"
    User directive: "Everything from your judgment is X. Must have basis."
    Audit all claims/additions in the vault for provenance. Categorize as:
    - Legacy-sourced (prior Claude session 4-agent review docs)
    - Datasheet-sourced (vendor official docs)
    - User-confirmed (explicit agreement in this session)
    - My judgment (unsourced additions - RED FLAG)
    13-item audit table covering every debatable addition.
    Flagged items requiring user decision:
    Q1. ESP32-C3-MINI-1U wireless module (my addition, not in legacy)
    Q2. Hardware SYNC GPIO for Jetson (my addition, not in legacy)
    Q3. JST-GH 1.25mm for all connectors (my generaliz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
2026-04-20 v3.9: remove Hardware SYNC, confirm BLE/JST-GH, mark size provisional, flag CubeMX-pending pins
    User answers to Unsourced Items Audit (Q1-Q4):
    Q1 ESP32-C3-MINI-1U BLE: CONFIRM INCLUDE (user "BLE required")
    Q2 Hardware SYNC GPIO: REMOVE (user unsure, default remove)
    Q3 JST-GH 1.25mm unify: CONFIRM (rationale in Citations)
    Q4 Board size 50x50mm: PROVISIONAL (finalize after motor)
    Changes:
    1. Hardware SYNC removed
    - 30 Concepts/Hardware Sync for Jetson.md marked status/removed,
    content preserved as "reference only, can reactivate if Jetson
    pose feeds MCU control loop in future"
    - 40 Schemat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
    [BOM_v4.csv]
2026-04-20 v3.10: restore Hardware SYNC GPIO (user decision)
    User reversal: "SYNC 추가야" (add SYNC). Previously removed in v3.9
    under "if unsure remove" policy, now explicitly confirmed by user.
    Changes (reverting v3.9 removal):
    - 30 Concepts/Hardware Sync for Jetson.md
    status: removed -> decided
    banner: "user-confirmed 2026-04-20 v3.10, v3.9 removal reverted"
    - 40 Schematic Blocks/Comms.md
    SYNC_OUT (PB14) / SYNC_IN (PB15) back in pin table with 🚩 CubeMX flag
    JST-GH 3pin SYNC connector restored in parts list
    "Jetson UART + HW SYNC" section with connector details
    - 20 Components/STM32H743VIT6.md
    SYNC_OUT / SYNC_IN rows restored in pin assignment table
    Marked 🚩 (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
    [BOM_v4.csv]
2026-04-20 v3.11: rewrite download_all.sh with verified URLs + multi-fallback
    User frustration: "정말 하나도 제대로 된 URL이 없네". Re-verified every
    datasheet URL via web search. Many of my original URLs were:
    - wrong Vishay doc numbers (88471 -> 88369 for P6KE)
    - wrong Murata paths (Rubycon ZLH path was invented)
    - wrong Infineon fileId (v02_01 stale -> v02_03)
    - wrong ST AN5200 URL suffix ("how-to-use" -> "getting-started-with")
    - wrong Panasonic OS-CON path
    - invented AS5048A ams-osram consent URL
    Script improvements:
    - Browser-like User-Agent (bypasses some bot checks)
    - Multiple fallback URLs per part (primary + 1-2 alternatives)
    - File size sanity check (>10KB, else try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
2026-04-22 v3.12: EBIMU V5 -> V6 correction + EBRCV24GV6 receiver as separate spec
    User confirmed actual IMU model is V6 (not V5 as legacy HANDOFF said).
    Two-part system:
    - EBIMU24GV6 : body-worn 2.4GHz wireless IMU sensor (3.3V)
    - EBRCV24GV6 : RF receiver dongle feeding STM32 via UART (5V input)
    - Rename 20 Components/EBIMU EBMotion V5.md -> EBIMU24GV6.md
    - Rewrite note covering both parts (IMU + receiver), mark content
    tentative pending user's verification of actual PDF specs
    - YAML aliases include legacy names: [EBIMU V6, EBIMU24GV6, EBRCV24GV6,
    EBIMU EBMotion V5, EBIMU V5] - wikilinks won't break
    - Update all references from V5 to V6 in:
    Exosuit Board MOC.md
    Goals & Requ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
2026-04-22 v3.12.1: fix EBIMU24GV6.md content + BOM V6 row (prior commit was no-op for these)
    Previous v3.12 commit had two Write operations that failed with
    "File has not been read yet" - the rename left EBIMU24GV6.md with the
    old V5 content, and BOM_v4.csv still referenced V5.
    Now actually applied:
    - EBIMU24GV6.md rewritten with V6 two-part spec (EBIMU24GV6 sensor +
    EBRCV24GV6 receiver), aliases include legacy names for wikilink
    compatibility, spec values marked provisional pending user PDF review
    - BOM_v4.csv MOD_IMU row updated to V6 part numbers
    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
    [BOM_v4.csv]
2026-04-22 add EBIMU24GV6 + EBRCV24GV6 + ZED X datasheets + Jetson setup guides
2026-04-22 v3.13: EBIMU24GV6 + EBRCV24GV6 spec verification from actual datasheets
    Read both E2BOX PDFs directly via Read tool (they are now in repo):
    EBIMU24GV6_IMU_Module.pdf (Rev1.0 F/W v610, 34p)
    EBRCV24GV6_Receiver.pdf (Rev1.0 F/W v6.00, 29p)
    Replace all provisional specs in EBIMU24GV6.md with verified values,
    each one cited to a specific datasheet section.
    Key corrections:
    - UART connector: 4pin (TX/RX/GND/5V) -> 3pin (TX/GND/5V)
    Receiver header pins are 5V/GND/3V/TX per EBRCV §2-1, no RX.
    Commands are set via USB-C (VCP) only, then receiver streams on TX.
    - Default baud rate: 921600 bps (sb=8), not "~1 Mbps estimate"
    - Output rate: configurable 1-1000 Hz via <sor>, use sor=2 for 500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
    [BOM_v4.csv]
2026-04-22 v3.14: ZED X Mini verified from datasheet + Jetson PDF integrity flag
    Read ZED_X_Datasheet_v1.2.pdf (10.5 MB, 721 lines extracted) directly.
    Replace provisional ZED specs with datasheet-cited values.
    Key findings / corrections:
    - ZED X Mini dimensions: 93.6 x 31.8 x 36.7 mm, 151 g
    - Baseline 5cm, IP67, -20~+55 deg C, PoC via GMSL2
    - Built-in IMU: Accel +/-12g 16-bit 400Hz, Gyro +/-1000dps 16-bit 400Hz
    NOTE: ZED IMU is for CAMERA Visual-Inertial SLAM, not user body.
    EBIMU24GV6 remains for user-body pose.
    - Stereo: 1/2.6" 2.3MP x2, 1928x1208, global shutter sync <100us
    across multiple cameras
    - Output: 1200p@60fps / 1080p@60fps / 960x600@120fps (side-by-side)
    - Body tracking: 18/34/38 k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
